hima0407/Project-Eidolon/README.md

# Project Eidolon

**A two-seat light trainer designed to beat the Hansa-NG, with every number traceable to code.**

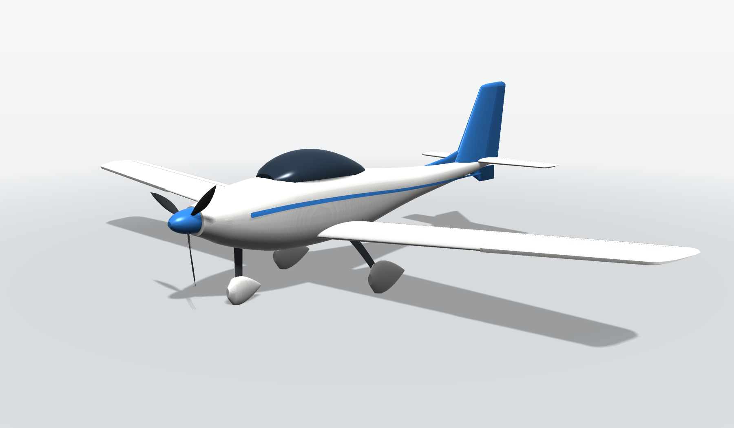
[picture p1: results/16_geometry/render_hero.png]
Eidolon v1, generated from the design closure


Eidolon is a first-semester conceptual design of a 750 kg, two-seat, single-engine trainer. It sits in the same class as India's CSIR-NAL **Hansa-NG**. Every number in this repository comes out of one Python pipeline: airfoils, wing, structure and mass, drag, propeller, engine choice, tail, CG, performance, loads, landing gear and the 3-D model. Every chosen value is the result of a study you can re-run with one command.

> **Status:** preliminary design (conceptual phase). Results are outputs of calibrated engineering models, not flight-test or wind-tunnel data. [Methods & validation](docs/METHODS_AND_VALIDATION.md) lists what each model can and cannot claim.

---

## The idea in one line: calibrate on real aircraft, then beat them

Every conceptual-design model has bias. So we first run our models on real aircraft with published data, and only then on Eidolon.

- **Mass.** A bottom-up count of sized structure, plus one measured unknown: the "class allowance" that a bottom-up count always misses, measured on three certified trainers (Hansa-NG, Aquila A210, DV20 Katana) as **148.8 ± 11.6 kg**. Leave-one-out predicts each of them within −3.7 % to +2.1 %.
- **Performance.** Two factors fitted on the Hansa-NG's cruise speed and climb rate. The models then predict five other published Hansa-NG numbers within **±15 %**.

Eidolon then goes through the **identical** models, so whatever bias is left mostly cancels and the comparison is like-for-like.

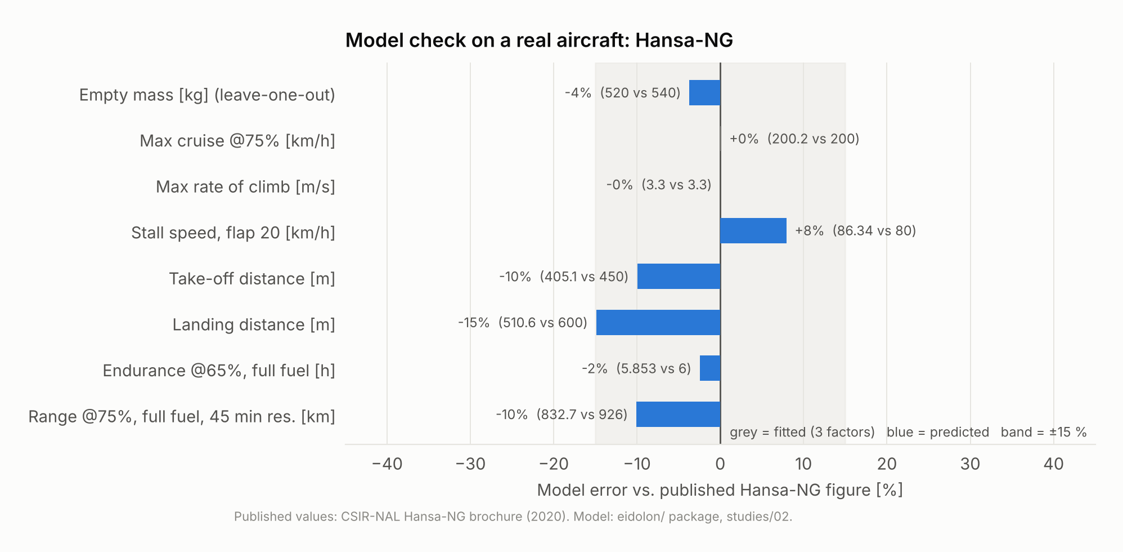
[picture p2: results/02_calibration/hansa_validation.png]
Model check on Hansa-NG


## Eidolon against the Hansa-NG

The design was closed first with glass-fibre sandwich skins (studies 01-16). Study 20 then re-closed the same geometry with **carbon sandwich skins**; that is the final aircraft.

| Same models, same calibration | Hansa-NG | First closure (glass) | **Eidolon, final (carbon)** | Change vs Hansa-NG |
|---|---:|---:|---:|---:|
| Fuel per 100 km at 200 km/h | 9.35 L | 7.84 L | **7.85 L** | **−16 %** |
| Range at 200 km/h, 2 × 77 kg + 10 kg, 45-min reserve | 713 km | 803 km | **1,098 km** | **+54 %** |
| Range, 2 × 90 kg + 10 kg | — | 334 km | **884 km** | |
| Cruise speed at 75 % power, 1500 m | 200 km/h | 216 km/h | **215 km/h** | +8 % |
| Max rate of climb, sea level | 3.30 m/s | 3.70 m/s | **3.70 m/s** | +12 % |
| Take-off distance to 15 m | 405 m | 357 m | **357 m** | −12 % |
| Stall speed, landing flap | 86 km/h* | 81 km/h | **81 km/h** | −6 % |
| L/D max | 12.8 | 15.0 | **15.0** | +17 % |
| Parasite drag coefficient CD0 | 0.0332 | 0.0263 | **0.0263** | −21 % |
| Empty mass | 526 kg | 530 kg | **500 kg** | −5 % |
| Unit cost, model (study 18) | ₹3.00 cr | ₹3.09 cr | **₹3.19 cr** | +6 % |
| Spin screen (Bowman TDPF, ≥ 200 × 10⁻⁶) | — | 481 × 10⁻⁶ | **496 × 10⁻⁶** | passes |

\*Model value. The model over-predicts Hansa-NG's published 80 km/h by 8 %, so Eidolon's 81 km/h is conservative. It is below the CS-VLA limit of 83 km/h.

Carbon does not change fuel burn: the wing is sized by stall at 750 kg either way. It turns 30 kg of structure into payload and fuel, so the 100 L tank is full with two crew, and it costs about ₹10 lakh more per aircraft. Per kilogram of useful load that is **₹1.27 lakh**, against ₹1.43 lakh for Hansa-NG ([study 20](studies/20_materials_carbon.py)).

**Is the advantage real?** We ran the comparison 800 times in Monte Carlo, with every uncertain assumption drawn wide, once with priors biased against Eidolon and once neutral: first on the glass first closure ([study 14](studies/14_sensitivity.py)), then on the final carbon aircraft ([study 22](studies/22_monte_carlo_carbon.py)).

- **Fuel burn:** Eidolon burns less in **100 %** of samples in every run, glass and carbon (−4 % to −14 % P5-P95, pessimistic).
- **Range with two crew, glass first closure:** better in **66 %** (neutral) and **30 %** (pessimistic). At a fixed 750 kg, every kilogram of empty mass is a kilogram of fuel, about **18 km** of range, and the glass aircraft's lead vanished if its empty mass grew 5 kg beyond the estimate.
- **Range, final carbon airframe:** re-run in [study 22](studies/22_monte_carlo_carbon.py) with the same priors, plus the assumption that only 50-100 % of the carbon saving turns up in production. Eidolon flies further in **98 %** of samples (pessimistic) and **100 %** (neutral); median **+24 %** and **+45 %**. The lead now survives **35 kg** of mass growth, against 5 kg in glass.

So the fuel-burn advantage is firm, and the carbon airframe turns the range advantage from conditional into firm. A weight-tracking budget is still the first job of the next phase.

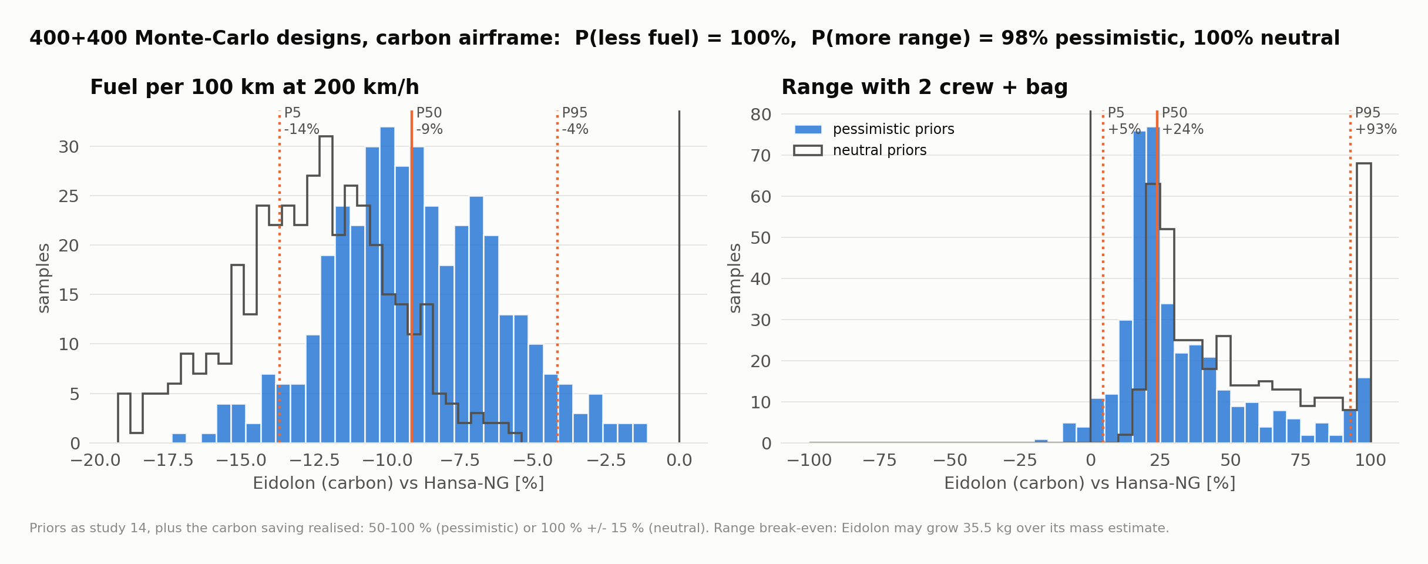
[picture p3: results/22_monte_carlo_carbon/monte_carlo.png]
Monte Carlo, final carbon aircraft


---

## Design decisions, each with its evidence

| # | Decision | Why (short) | Evidence |
|---|---|---|---|
| [D1](docs/DESIGN_DECISIONS.md#d1-mission-mtow-and-certification-basis) | 750 kg MTOW, 2 seats, CS-VLA envelope, +4.4 g utility loads | Same class as Hansa-NG, fair comparison; spin-training loads | studies 02, 12 |
| [D2](docs/DESIGN_DECISIONS.md#d2-mass-is-estimated-bottom-up-and-the-unknown-is-measured) | **Bottom-up mass** + measured class allowance, as a random variable | Sees Eidolon's differences from Hansa; P5-P95 500-560 kg | study 01 |
| [D3](docs/DESIGN_DECISIONS.md#d3-wing-section-naca-63-415-blending-to-63-412) | NACA 63-415 root → 63-412 tip | Laminar to ~35-50 % chord at cruise CL; 25 % deeper spar | study 03 |
| [D4](docs/DESIGN_DECISIONS.md#d4-wing-planform-1325-m-115-m-taper-06-2-washout) | **13.25 m², 11.5 m span (AR 10)**, taper 0.6, −2° washout | Fuel-burn optimum of a carpet of fully closed aircraft, range ≥ 800 km | studies 04, 05 |
| [D5](docs/DESIGN_DECISIONS.md#d5-spin-resistant-drooped-outboard-leading-edge) | **Drooped outboard leading edge** | Ailerons stay 100 % unstalled 3° past first stall (37.5 % without) | study 04 |
| [D6](docs/DESIGN_DECISIONS.md#d6-tail-conventional-low-tail-ventral-strake-40-elevator) | **Conventional low tail + ventral strake, 40 % elevator** | 6 configurations re-closed; T-tail can't rotate before lift-off; strake triples spin damping | studies 09, 10 |
| [D7](docs/DESIGN_DECISIONS.md#d7-drag-reduction) | Faired gear, laminar wing, compact fuselage | −16 % parasite drag area; the gear fairings are the biggest item | study 06 |
| [D8](docs/DESIGN_DECISIONS.md#d8-engine-rotax-912-isc) | **Rotax 912 iSc** (vs 912 ULS, 914, 915 iS, UL520iS) | Each engine re-closed in its own airframe. The DarkAero 1's UL520iS leaves 10 kg of fuel with two crew | study 08 |
| [D9](docs/DESIGN_DECISIONS.md#d9-propeller-175-m-3-blade-constant-speed) | 1.75 m, 3-blade, constant speed | BEMT checked against the momentum limit; 81 % installed in cruise | study 07 |
| [D10](docs/DESIGN_DECISIONS.md#d10-glass-fibre-leaf-spring-gear-with-piezo-health-monitoring) | S-glass leaf-spring gear with piezo health monitoring | Lightest spring material (σ²/Eρ); piezo logs every landing, but can absorb only 0.04 % of it | study 13 |
| [D11](docs/DESIGN_DECISIONS.md#d11-structure-checked-at-66-g-tip-deflection-flagged) | Structure checked at 6.6 g; stiffness flagged | Spar at its allowable, tail cone margin +0.45; wing is skin-driven (57 % skin, 9 % spar caps) | study 17 |
| [D12](docs/DESIGN_DECISIONS.md#d12-fuselage-length-710-m) | Fuselage body 7.10 m | Shortest body at the fuel-burn minimum of 8 re-closed lengths | study 19 |
| [D13](docs/DESIGN_DECISIONS.md#d13-carbon-sandwich-airframe-for-the-final-aircraft) | **Carbon sandwich airframe** (vacuum infusion) | −30 kg empty; range 803 → 1,098 km; +3 % unit cost; cheapest per kg of useful load | studies 18, 20 |
| [D14](docs/DESIGN_DECISIONS.md#d14-engine-re-checked-on-the-carbon-airframe-912-isc-stays) | Engine re-checked on carbon: **912 iSc stays** | Six-cylinder still fits only 40 kg of fuel (349 km); weight, not tank, is the limit. Hot days: 30 kW boost option | studies 15, 23 |

Appendix concept: [hybrid take-off boost for 45 °C airfields](docs/hybrid_boost_concept.md) (study 15).

## What makes it different

- **Spin-resistant by design.** Washout, a drooped outboard leading edge and a ventral strake, each screened with a published criterion, for a trainer that students will stall and spin.
- **A wing the old statistics would never have chosen.** Sizing the carbon spar instead of using a fitted equation made span cheap, and the optimum moved from 10.25 m to 11.5 m.
- **A landing gear that reports on itself.** Piezo films log the sink rate of every landing and flag hard ones; PZT wafers can find damage in the composite leaf between inspections.
- **CAD that follows the numbers.** Change the design, re-run, and the Fusion 360 solids, viewer and renders follow ([docs/CAD.md](docs/CAD.md)).

## How the pipeline closes the design

```mermaid
flowchart LR
  R[Requirements<br/>docs/requirements.md] --> G[Geometry<br/>wing, tails, fuselage]
  G --> A[Aerodynamics<br/>lifting line + drag build-up]
  A --> S[Structure<br/>spar sized for 6.6 g]
  S --> W[Mass<br/>bottom-up + class allowance]
  E[Engine data] --> P[Propeller BEMT]
  W --> C[CG envelope]
  A --> T[Tail sizing +<br/>wing position]
  C --> T
  T --> G
  A --> F[Performance<br/>climb, cruise, range, TO/LDG]
  P --> F
  W --> F
  F --> O[Trade studies<br/>wing carpet, engines, tails,<br/>Monte Carlo]
  G --> X[3-D model<br/>Fusion, viewer, renders]
  H[Hansa-NG, Aquila, DV20<br/>published data] -. calibrate & validate .-> W
  H -.-> F
```

The loop `geometry → mass → CG → tail/wing position → geometry` repeats until it converges (`eidolon/design.py`).

## The studies

| # | Study | Main output |
|---|---|---|
| 01 | Mass estimation | bottom-up mass, class allowance, leave-one-out, mass distribution |
| 02 | Calibrate on Hansa-NG | drag and climb factors, validation against 6 published numbers |
| 03 | Airfoil selection | section geometry and polars |
| 04 | Wing lifting line | span loading, stall progression, washout, drooped LE |
| 05 | Wing sizing | area × span carpet of closed aircraft |
| 06 | Drag build-up | component drag areas, waterfall vs Hansa-NG |
| 07 | Propeller | BEMT, 2 vs 3 blades |
| 08 | Engine trade | 5 engines, each in its own closed airframe |
| 09 | Tail configuration | 6 tails, spin and deep-stall screens, tail height, elevator chord |
| 10 | Stability and CG | neutral point, CG envelope, tail sizing criteria |
| 11 | Performance | head-to-head, power curves, payload-range |
| 12 | V-n diagram | CS-23 manoeuvre and gust envelope |
| 13 | Landing gear | leaf-spring material trade, piezo assessment |
| 14 | Sensitivity | Monte Carlo (pessimistic and neutral), tornado |
| 15 | Hybrid boost | hot-day take-off and climb with electric boost |
| 16 | 3-D geometry | Fusion script data, STL, viewer bundle, renders, three-view |
| 17 | Structural analysis | wing shear, bending, spar caps, deflection, tail cone, margins (glass and carbon) |
| 18 | Cost model | Eastlake/Gudmundsson unit cost calibrated on Hansa-NG's price; glass, infusion, prepreg |
| 19 | Fuselage length | 8 re-closed body lengths, 6.5-7.9 m |
| 20 | Airframe material | glass vs carbon re-closure, what 30 kg buys, cost efficiency |
| 21 | Presentation renders | part stills, exploded-view layers, assembly animation (`--animate`) |
| 22 | Monte Carlo, carbon | study 14 re-run on the final carbon aircraft; study 09's tail screen re-checked on carbon |
| 23 | Engine trade, carbon | study 08 re-run with carbon skins; six-cylinder needs; hot-day options incl. the 30 kW boost |

### The order we designed it in

The studies are numbered by topic; this is the order the design actually went, and the order of the review presentation:

1. **Airfoils in XFLR5** (03): candidate sections, Reynolds numbers of each flight phase, XFoil batch, NACA 63-415 → 63-412.
2. **Finite wing** (04, 05, 12, 17): lifting line checked against XFLR5 VLM2, area × span carpet, washout, drooped leading edge, V-n loads, spar sizing.
3. **Propeller and engine** (07, 08): BEMT, 2 vs 3 blades, five engines in their own closed airframes.
4. **Tail and stability** (09, 10): neutral point, six tails, spin screen, elevator chord.
5. **Landing gear** (13): leaf spring sized by landing energy; piezo for sensing and health monitoring.
6. **Whole-aircraft drag and mass** (06, 01, 02): component build-up; bottom-up mass with a measured class allowance.
7. **Fuselage** (19, 17): layout around the CG, drag physics, length trade, tail-cone bending.
8. **Materials and cost** (20, 18, 23): carbon sandwich airframe adopted; cost calibrated on Hansa-NG; engine choice re-checked on carbon.
9. **The aircraft** (11, 14, 16, 21, 22): performance, Monte Carlo (glass, then carbon), CAD with internal components ([docs/CAD.md](docs/CAD.md)) and renders.

## Run it

```bash
pip install -r requirements.txt      # numpy >= 2, matplotlib, pytest
python3 -m pytest -q                 # 16 verification tests
python3 run_all.py                   # all 23 studies, about 8 minutes; figures land in results/
python3 run_all.py 05 09             # just the wing carpet and the tail trade
```

The 3-D model is regenerated by study 16 ([docs/CAD.md](docs/CAD.md)):
- `cad/fusion/Eidolon/` — a Fusion 360 script that lofts every body as a parametric solid
- `cad/generated/*.stl` — one mesh per body
- `docs/viewer/` — an interactive web viewer. Enable GitHub Pages on `/docs` to publish it.

## Repository map

```text
eidolon/            the design toolkit: a Python package, one module per discipline (models only, nothing runs on import)
studies/            the 23 numbered analyses that use it; each writes into results/<study>/
run_all.py          runs every study in order
results/            every figure and table, regenerated by run_all.py
tests/              verification tests (ISA, lifting-line textbook cases, momentum bound, spar sizing, closure)
xflr5/              our XFLR5 work: airfoils/ (coordinates), projects/ (.xfl files), results/ (exported polars)
cad/                eidolon_v1.step and the Fusion file; fusion/ = generator script, generated/ = STL per body, early/ = first models
docs/               requirements, design decisions, methods & validation, CAD notes, concepts
docs/viewer/        interactive 3-D viewer (three.js)
archive/            first-iteration scripts and their results, and early concept notes, kept for history
```

## Gallery

| | |
|---|---|
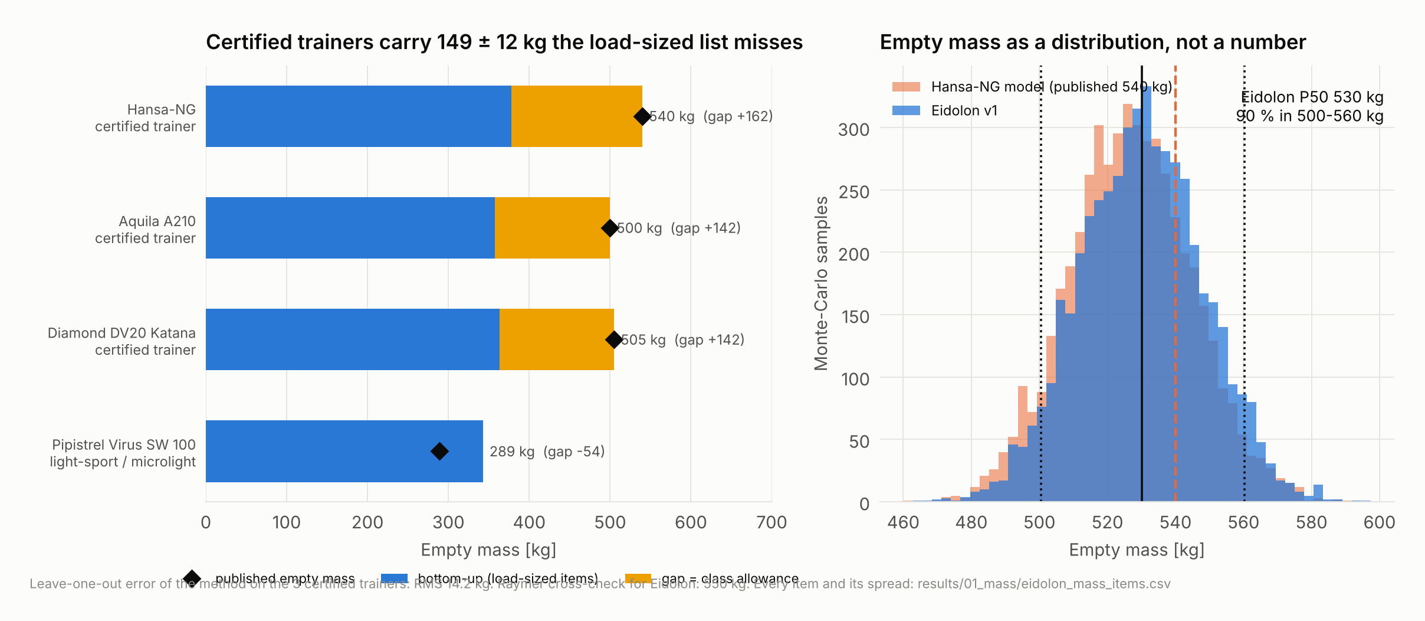
[picture p4: results/01_mass/mass_estimation.png]
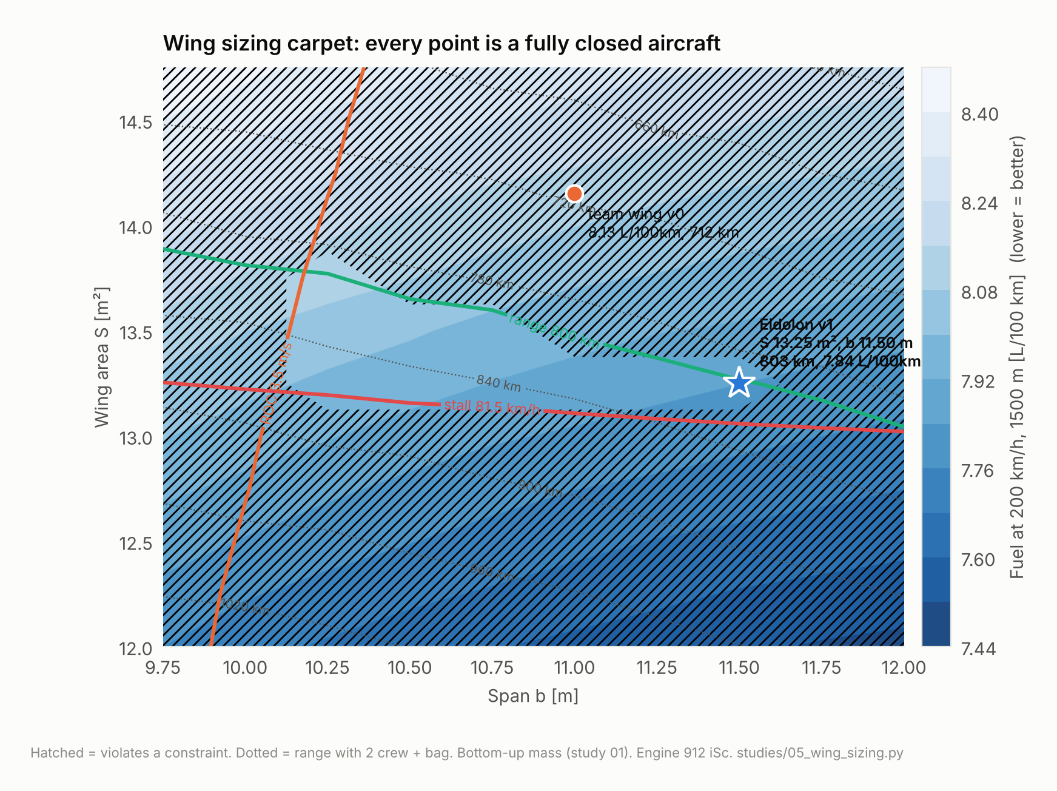
[picture p5: results/05_wing_sizing/wing_carpet.png]
|  |  |
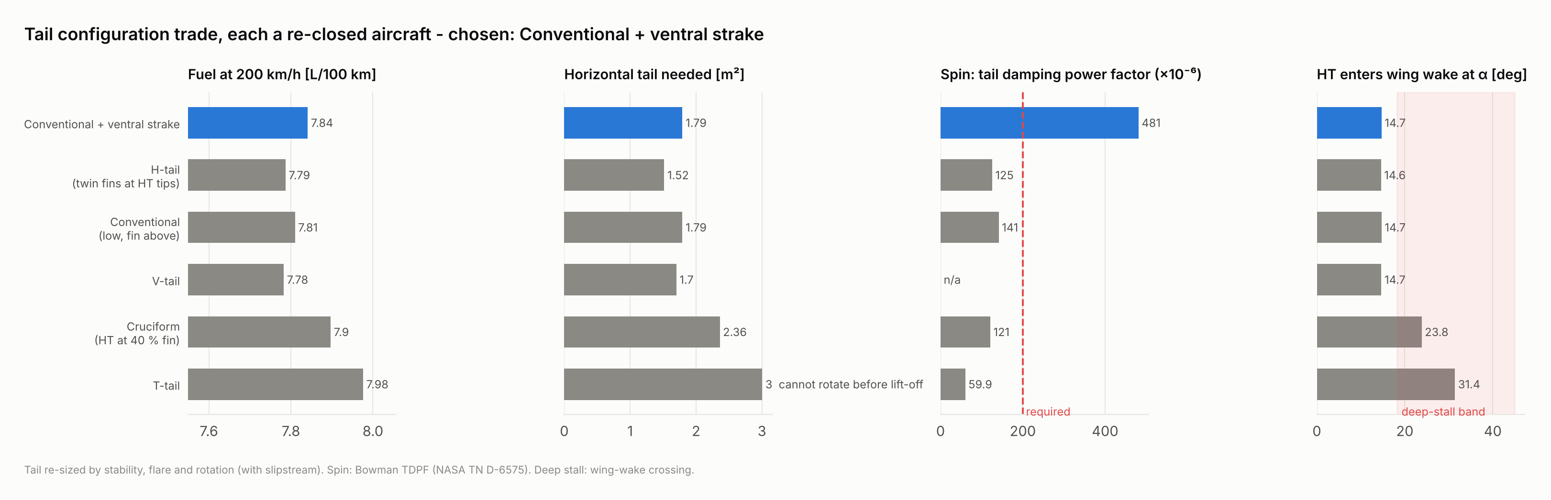
[picture p6: results/09_tail/tail_configurations.png]
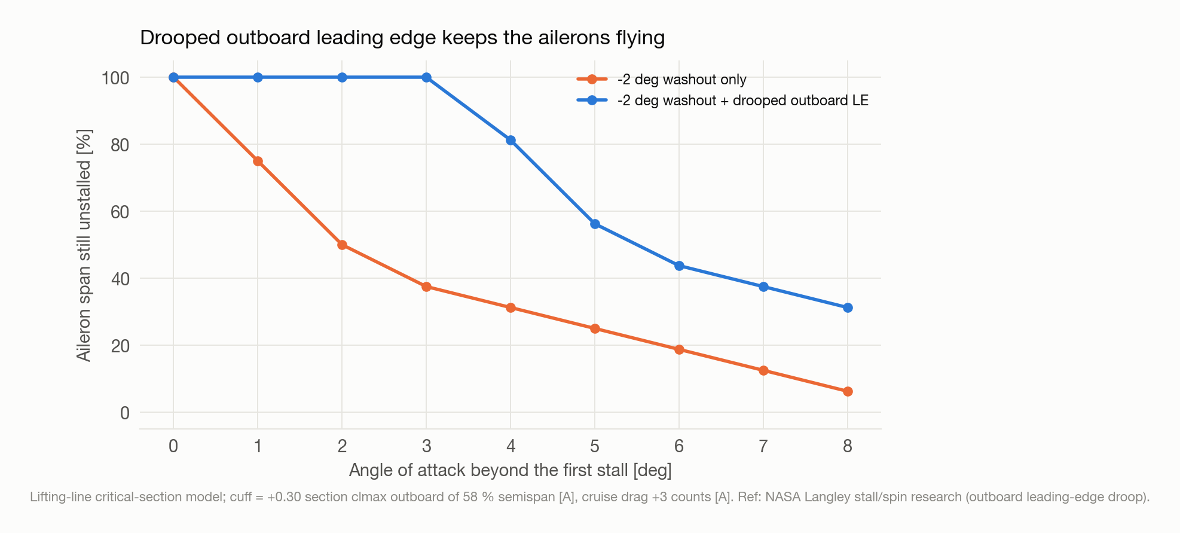
[picture p7: results/04_wing/leading_edge_cuff.png]
|  |  |
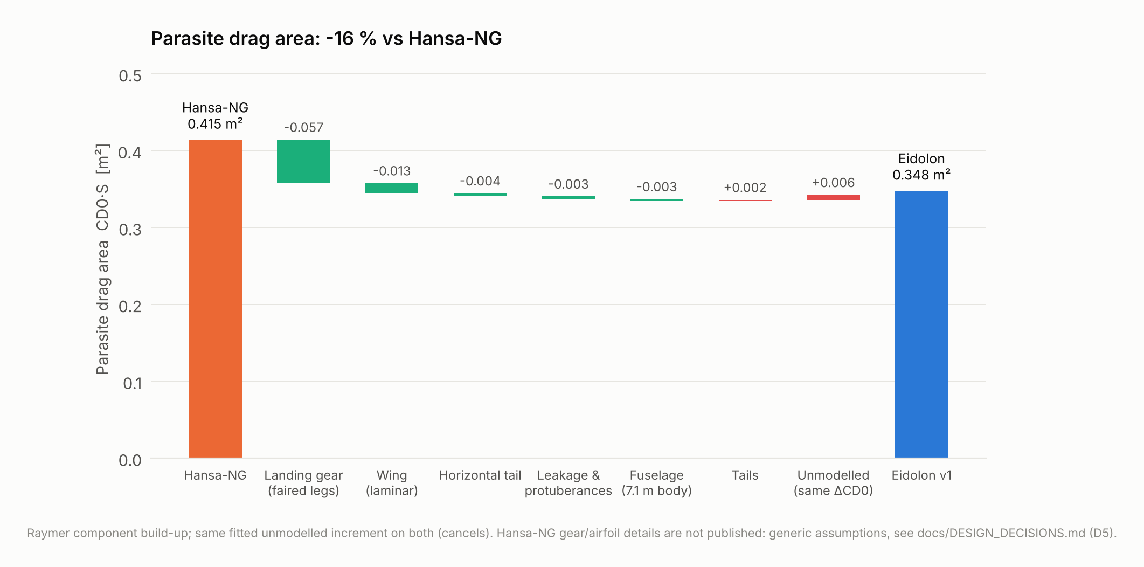
[picture p8: results/06_drag/drag_waterfall.png]
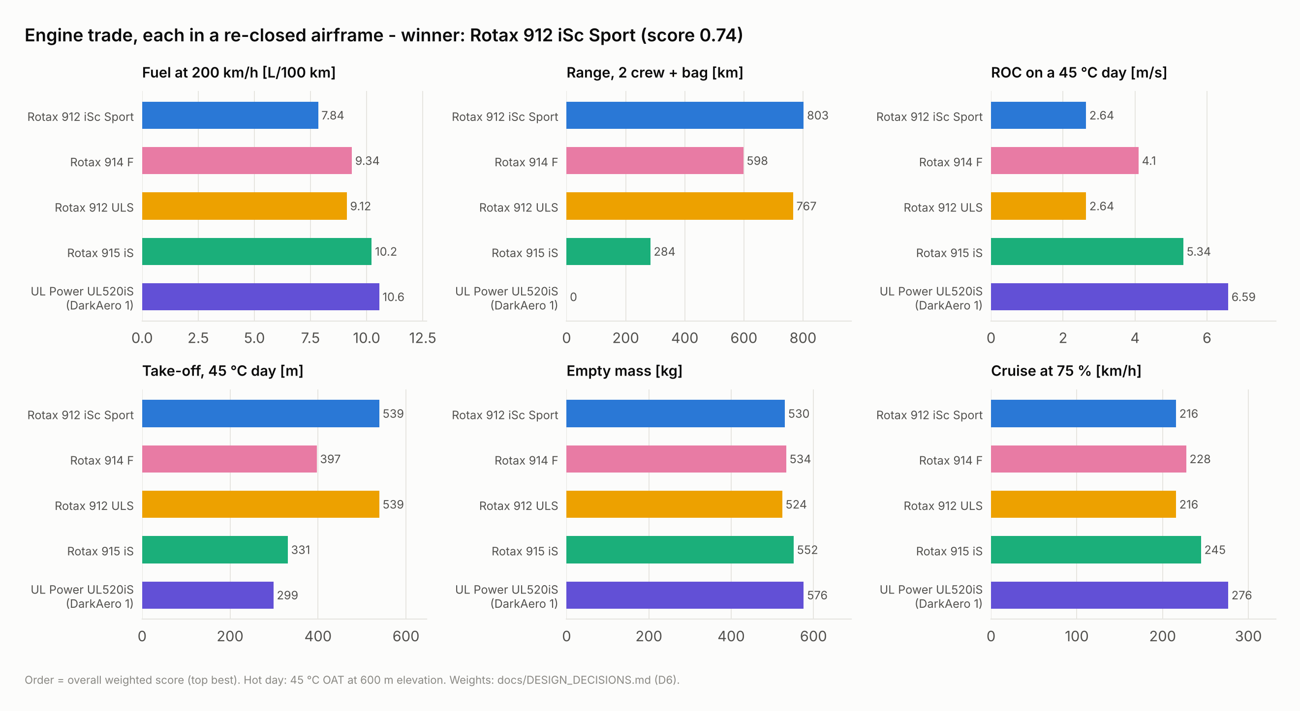
[picture p9: results/08_engine_trade/engine_trade.png]
|  |  |
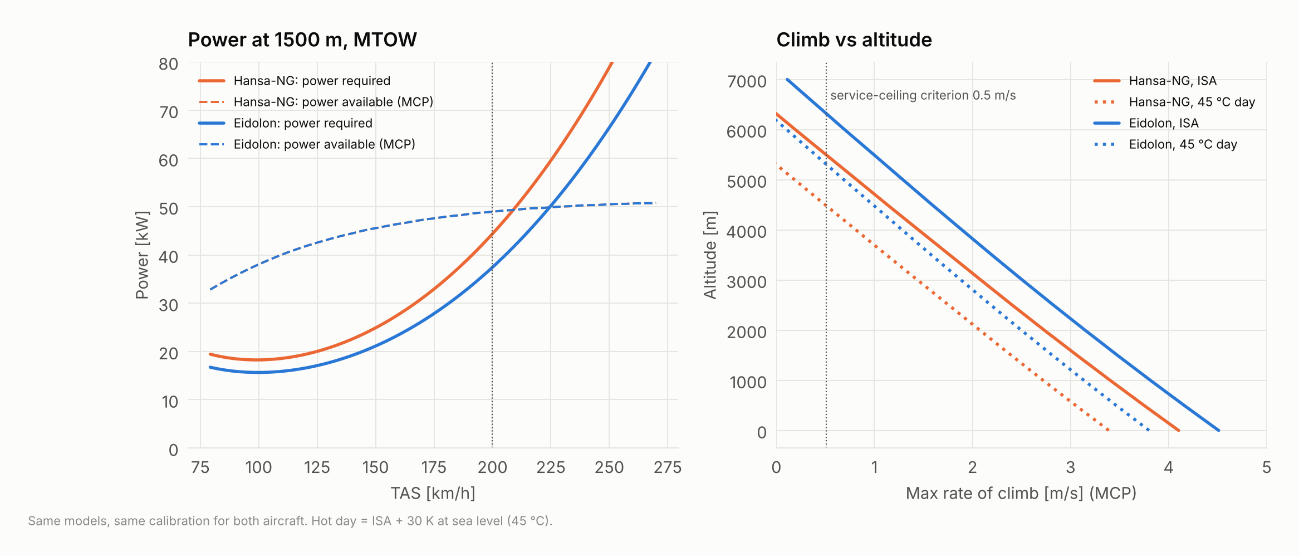
[picture p10: results/11_performance/power_and_climb.png]
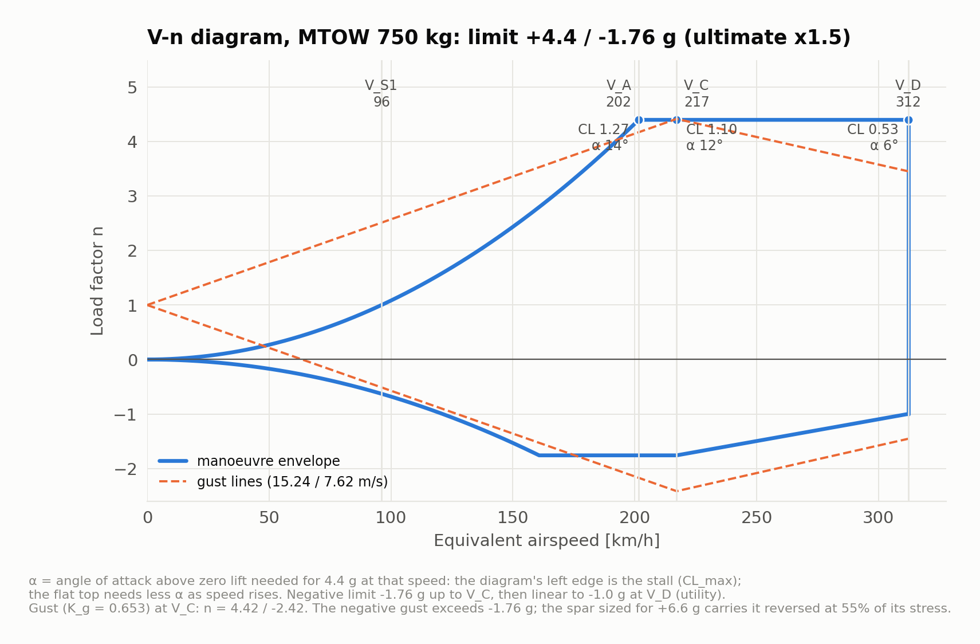
[picture p11: results/12_vn/vn_diagram.png]
|  |  |
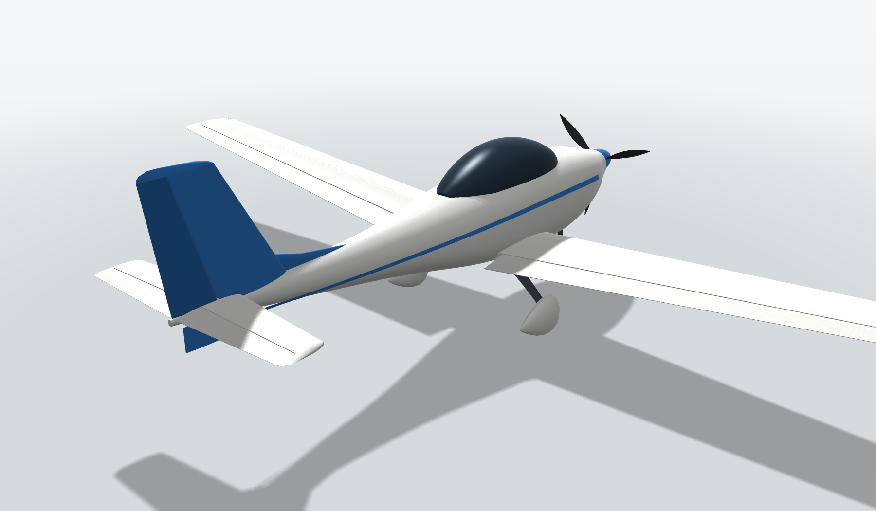
[picture p12: results/16_geometry/render_rear.png]
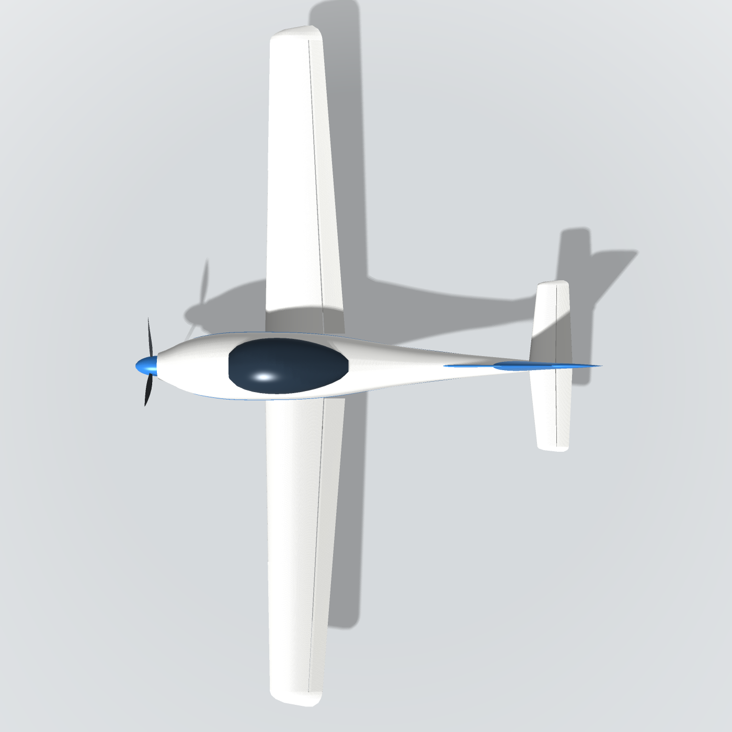
[picture p13: results/16_geometry/render_top.png]
|  |  |
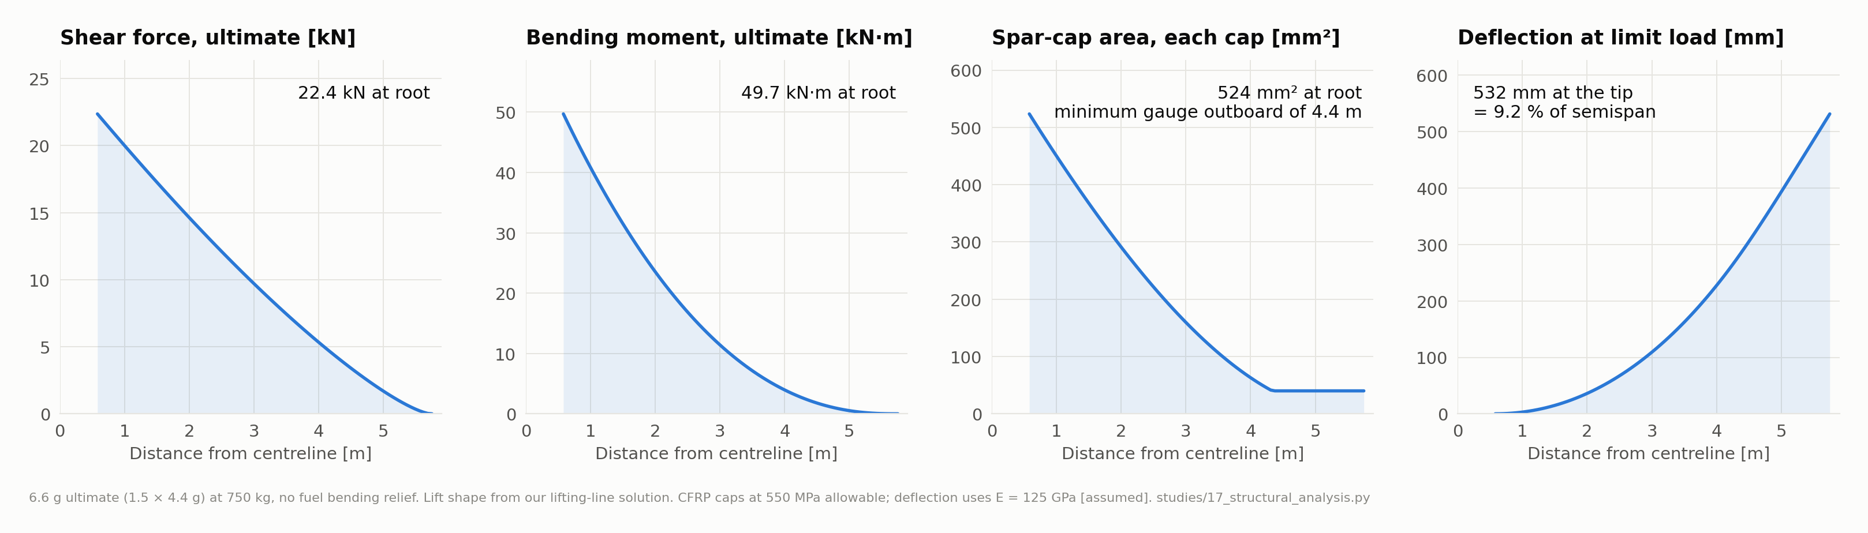
[picture p14: results/17_structures/wing_loads.png]
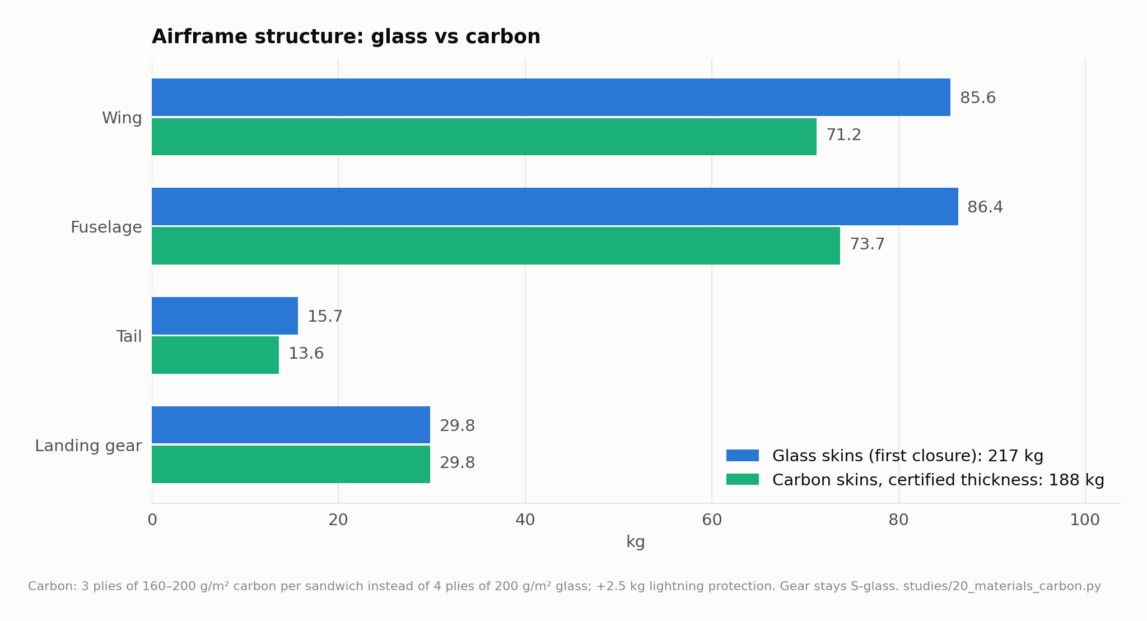
[picture p15: results/20_materials/glass_vs_carbon.png]
|  |  |
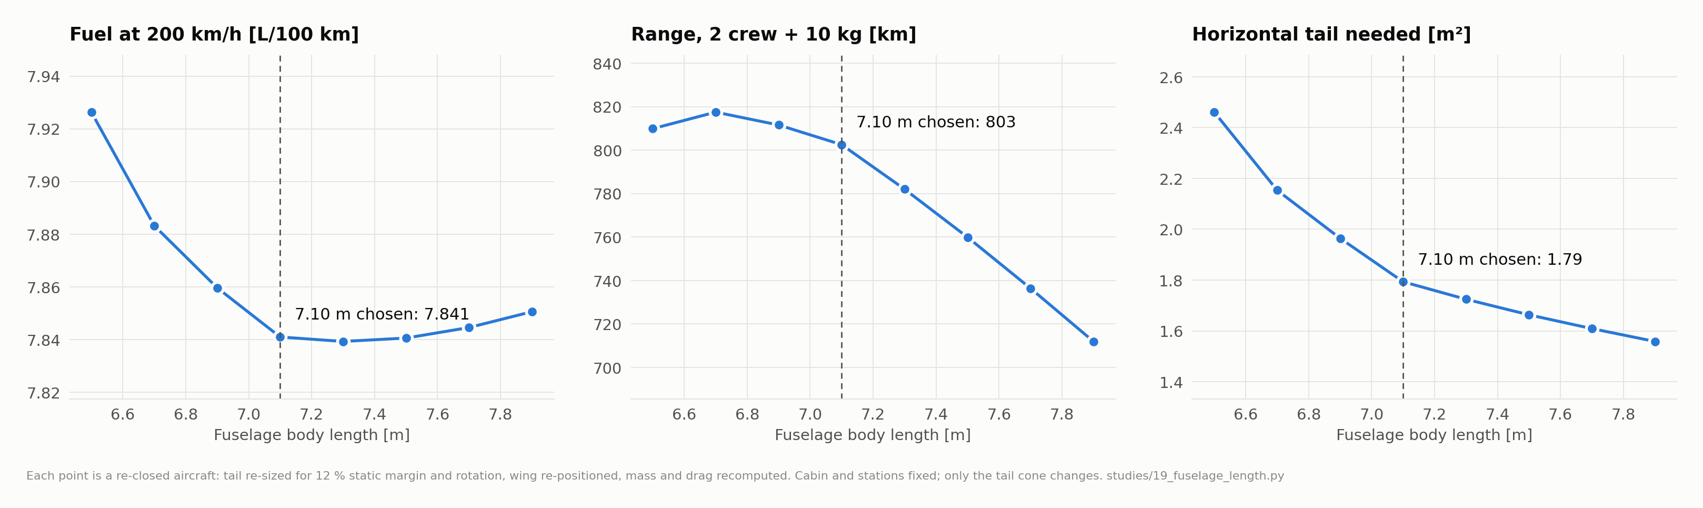
[picture p16: results/19_fuselage/fuselage_trade.png]
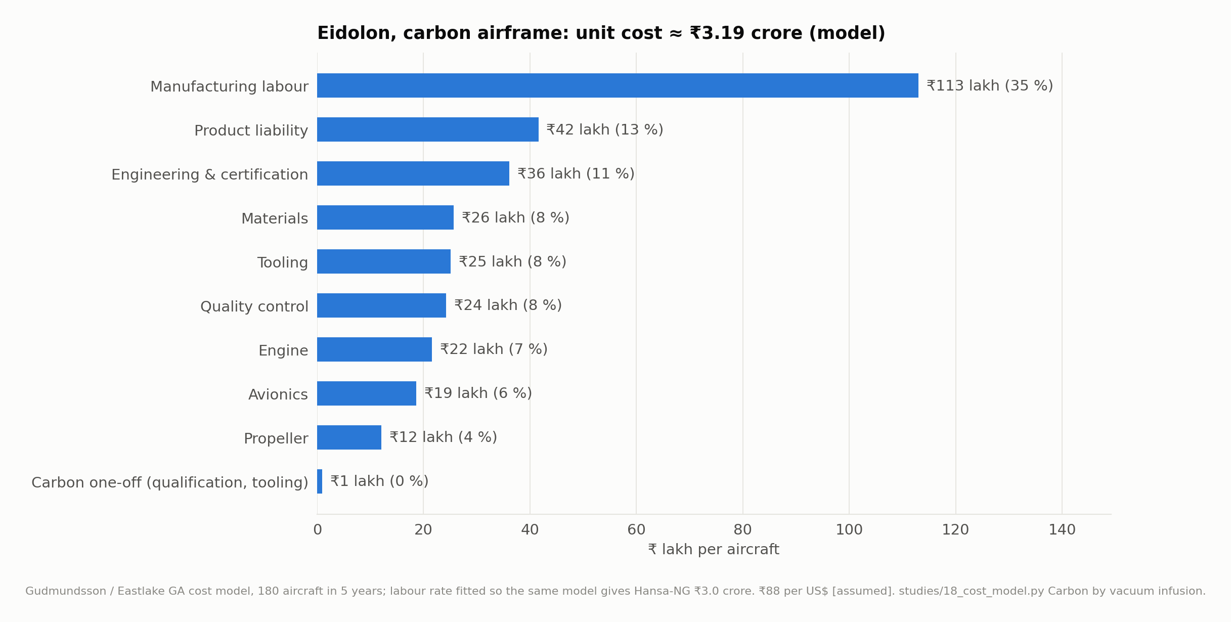
[picture p17: results/18_cost/cost_carbon.png]
|  |  |

Assembly animation, rendered by the pipeline: [results/21_renders/assembly.mp4](results/21_renders/assembly.mp4)

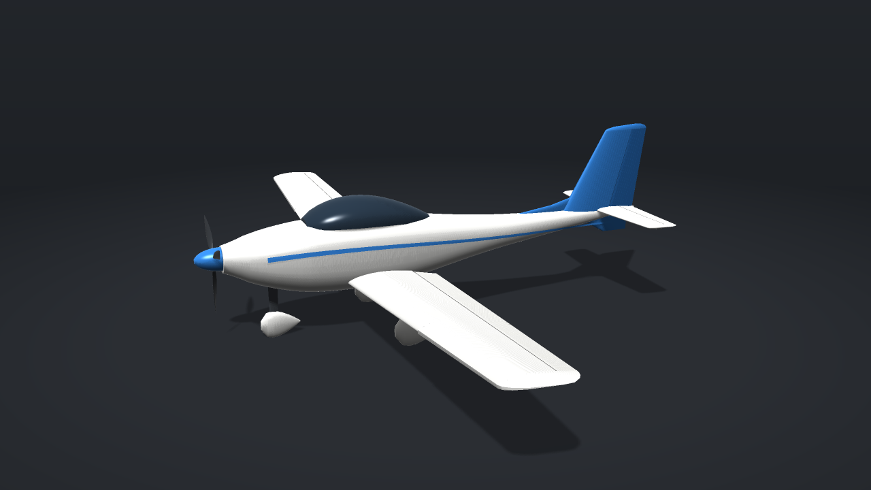
[picture p18: results/21_renders/assembly_still.png]
Assembled


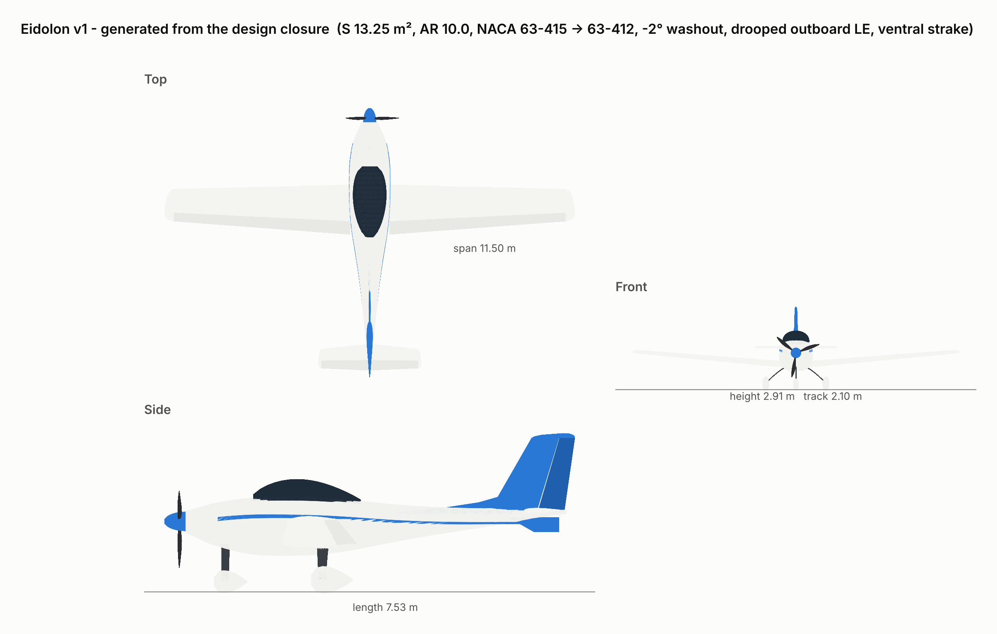
[picture p19: results/16_geometry/three_view.png]
Three-view


## Engineering principles we kept to

- Requirements are not results. Assumptions are tagged `[A]` in the code where they are made.
- Every figure carries its source and method in a footer.
- A model is believed only as far as it has been checked (see `tests/` and studies 01-02).
- Comparisons use identical models and conditions for both aircraft.
- Unknowns are named and given a spread, not hidden in a factor.
- When the analysis disagreed with an earlier choice (wing span, tail size, piezo damping, BEMT efficiency, 25 L tank), the analysis won and the change is recorded.

## References

- CSIR-NAL, *Hansa-NG* brochure (2020), nal.res.in
- D. P. Raymer, *Aircraft Design: A Conceptual Approach*, 6th ed., AIAA, 2018
- E. Torenbeek, *Synthesis of Subsonic Airplane Design*, Delft UP, 1982
- J. D. Anderson, *Fundamentals of Aerodynamics*, 6th ed., McGraw-Hill
- I. H. Abbott & A. E. von Doenhoff, *Theory of Wing Sections*, Dover, 1959
- S. Gudmundsson, *General Aviation Aircraft Design*, 2nd ed., Elsevier, 2022
- B. W. McCormick, *Aerodynamics, Aeronautics and Flight Mechanics*, Wiley
- T. H. G. Megson, *Aircraft Structures for Engineering Students*, Elsevier
- J. S. Bowman Jr., *Summary of spin technology as related to light general-aviation airplanes*, NASA TN D-6575, 1971
- EASA CS-VLA and CS-23 (Amdt. 4 and earlier load-case paragraphs 23.333-23.473)
- Rotax 912 iS/iSc and 915 iS data sheets (flyrotax.com); ULPower UL520iS data (ulpower.com)
- M. Nita & D. Scholz, *Estimating the Oswald factor from basic aircraft geometrical parameters*, DLRK 2012
- N. W. Hagood & A. von Flotow, *Damping of structural vibrations with piezoelectric materials and passive electrical networks*, J. Sound Vib. 146, 1991
