hima0407/Project-Eidolon/cad/early/initialtrail0.png

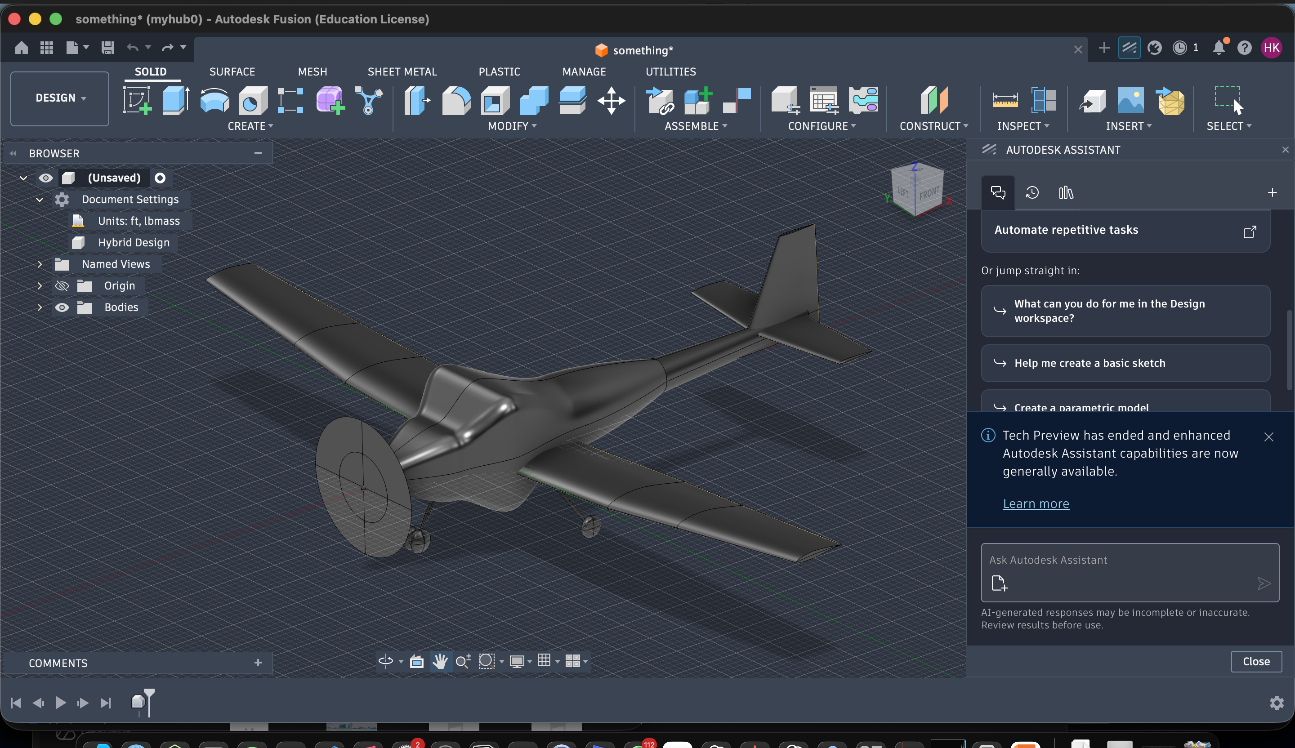
cad/early/initialtrail0.png
