hima0407/Project-Eidolon/cad/eidolon_v1_fusion.png

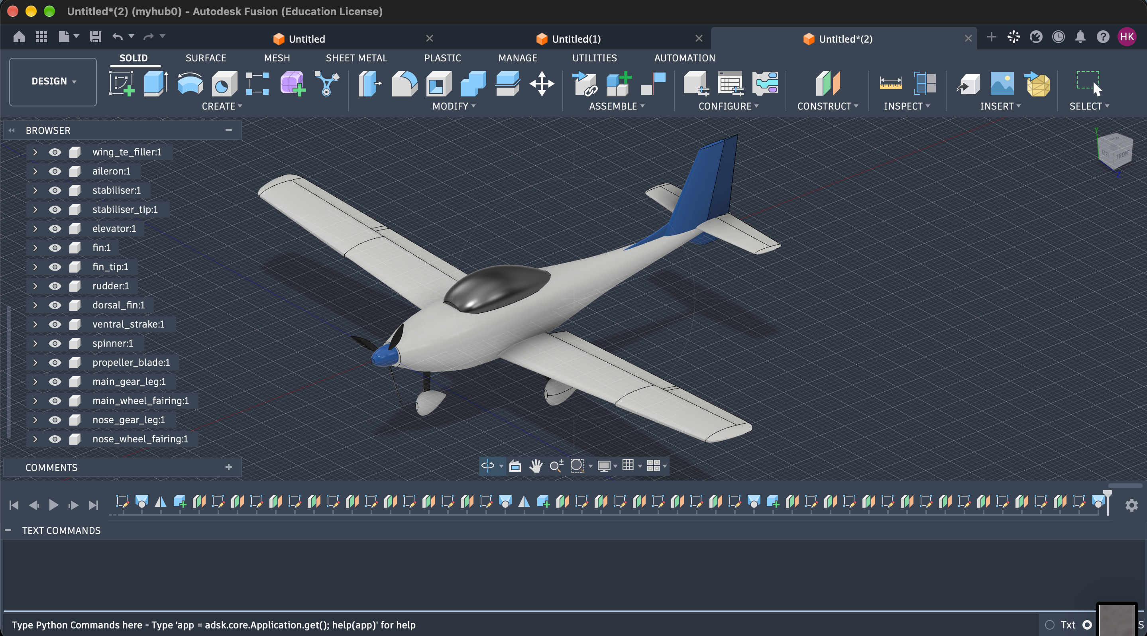
cad/eidolon_v1_fusion.png
