hima0407/Project-Eidolon/docs/eidolon_constraint_graph.png

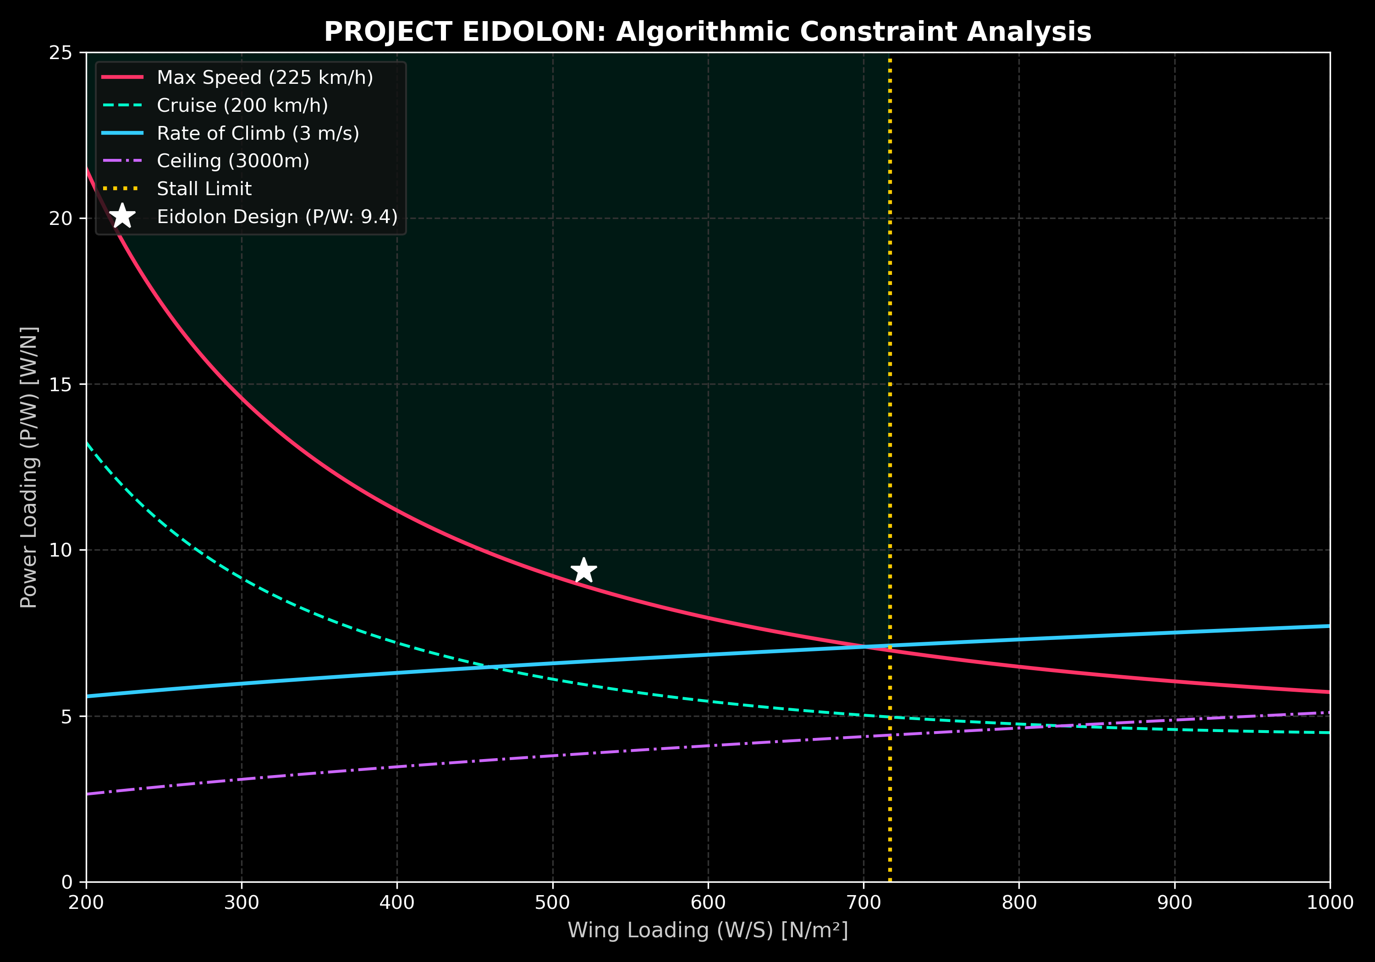
docs/eidolon_constraint_graph.png
