hima0407/Project-Eidolon/results/18_cost/cost_glass.png

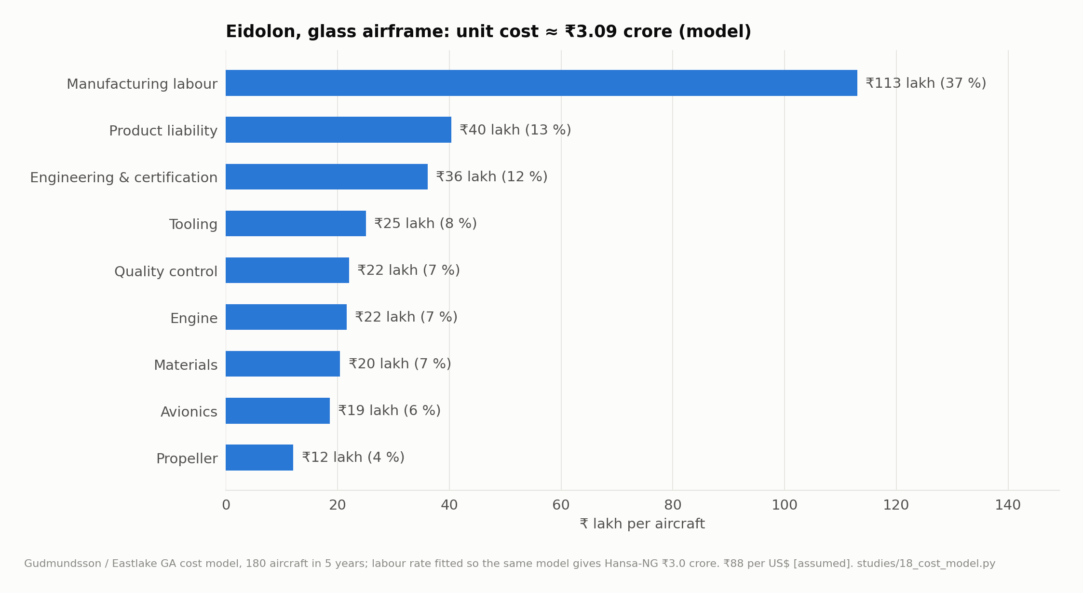
results/18_cost/cost_glass.png
