hima0407/Project-Eidolon/results/20_materials/cost_efficiency.png

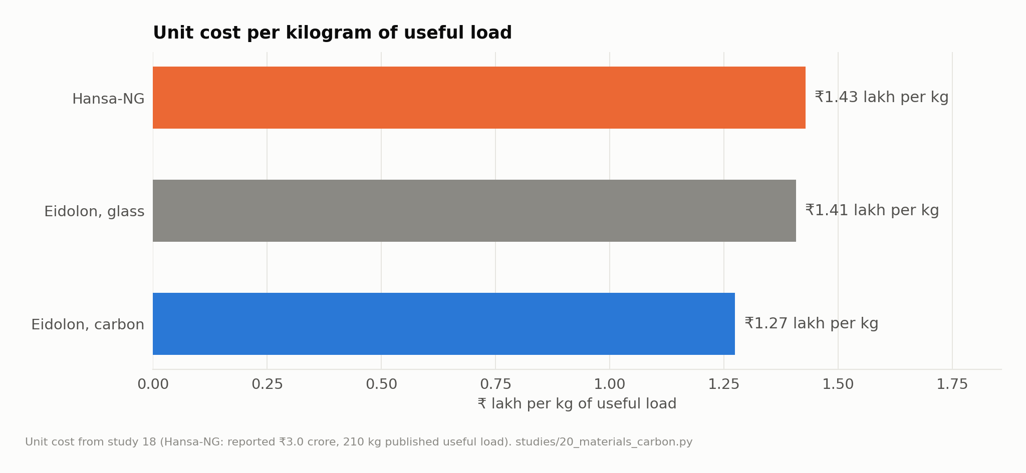
results/20_materials/cost_efficiency.png
