hima0407/Project-Eidolon/cad/generated/eidolon_v1_main_gear_leg.stl

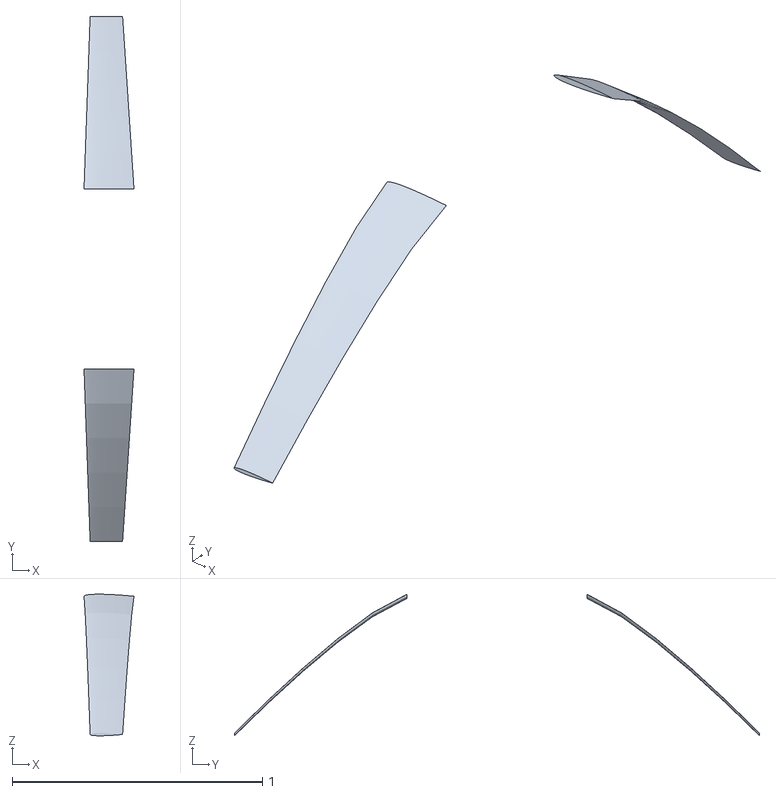
[picture p25: CAD file, 2026-11-10]
cad/generated/eidolon_v1_main_gear_leg.stl
0.2 x 2.10 x 0.567
