hima0407/Project-Eidolon/cad/generated/eidolon_v1_main_wheel_fairing.stl

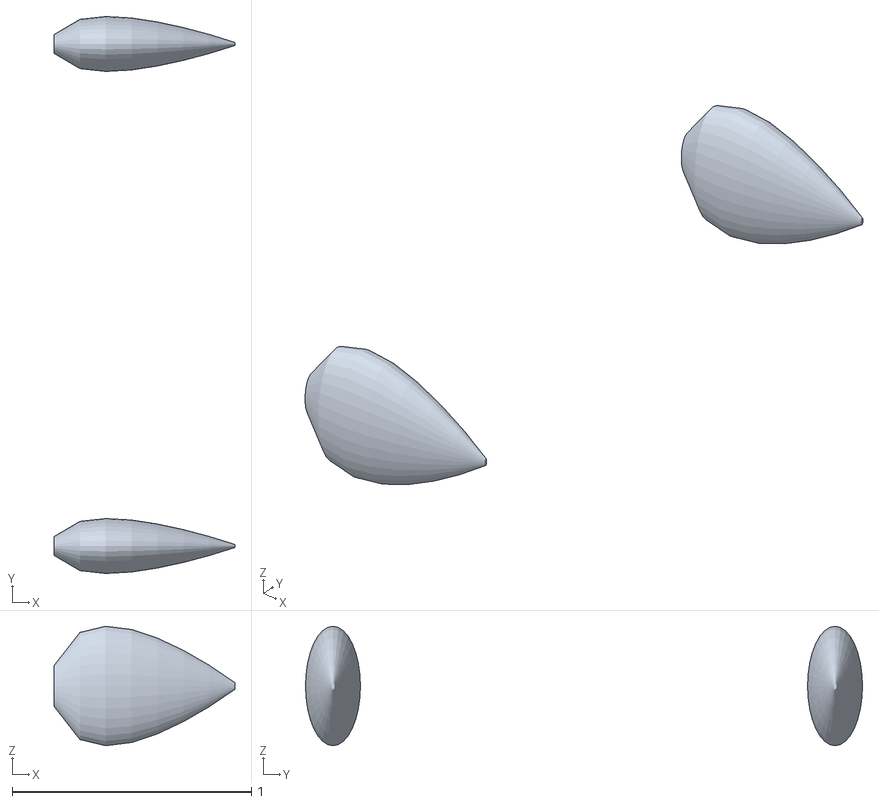
[picture p26: CAD file, 2026-11-10]
cad/generated/eidolon_v1_main_wheel_fairing.stl
0.757 x 2.33 x 0.5
