hima0407/Project-Eidolon/cad/generated/eidolon_v1_complete.stl

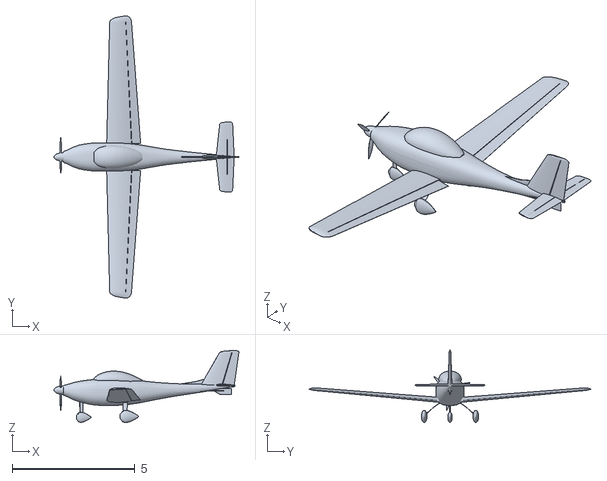
[picture p27: CAD file, 2026-11-10]
cad/generated/eidolon_v1_complete.stl
7.53 x 11.5 x 2.94
