hima0407/Project-Eidolon/cad/generated/internals/eidolon_v1_int_main_spar.stl

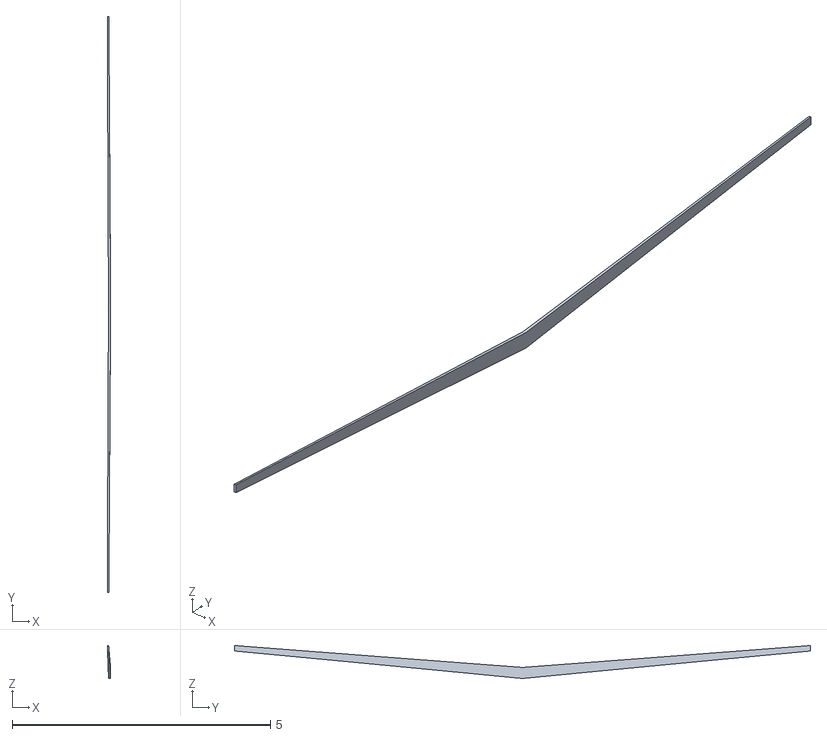
[picture p28: CAD file, 2026-11-12]
cad/generated/internals/eidolon_v1_int_main_spar.stl
0.0651 x 11.2 x 0.639
