hima0407/Project-Eidolon/cad/eidolon_v1.step

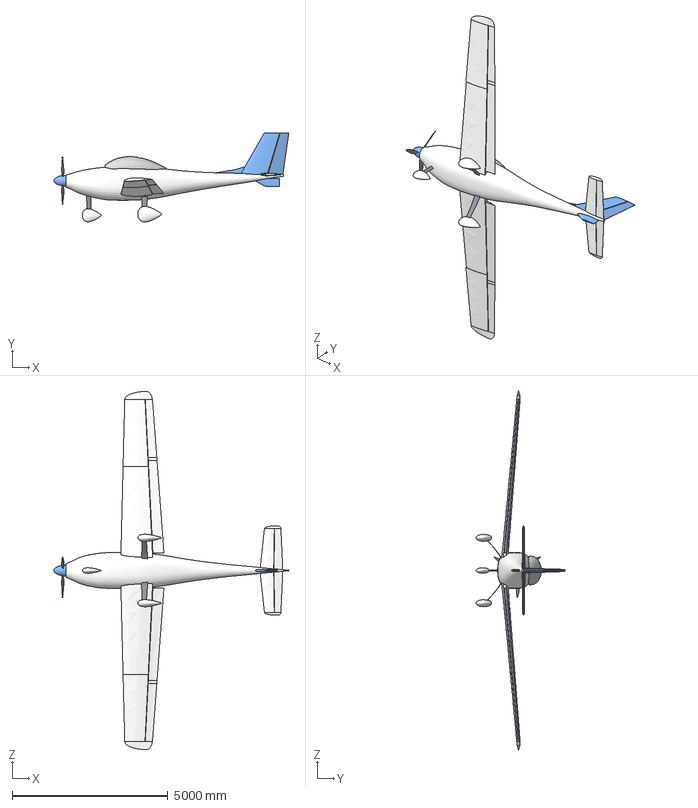
[picture p29: CAD file, 2026-11-10]
cad/eidolon_v1.step
7530.8 x 2855.4 x 11488.5 mm
