hima0407/Project-Eidolon/cad/generated/eidolon_v1_livery_stripe.stl

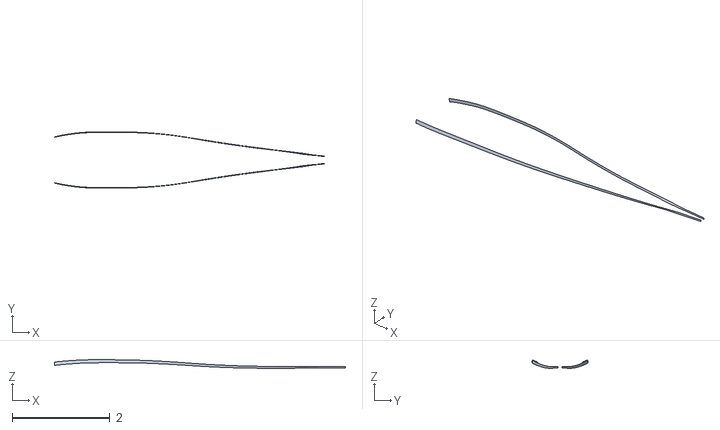
[picture p30: CAD file, 2026-11-10]
cad/generated/eidolon_v1_livery_stripe.stl
5.95 x 1.15 x 0.178
