hima0407/Project-Eidolon/cad/generated/internals/eidolon_v1_int_ribs_06.stl

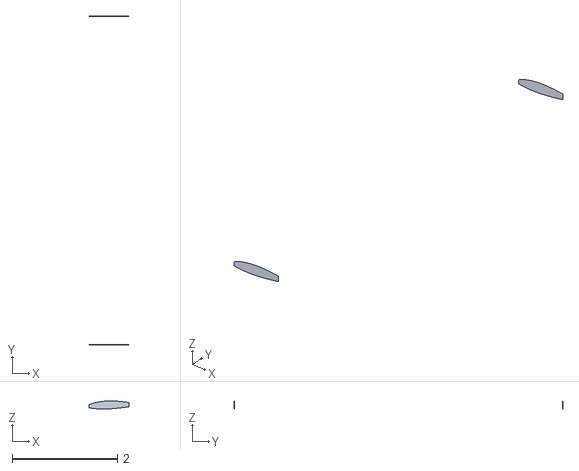
[picture p31: CAD file, 2026-11-12]
cad/generated/internals/eidolon_v1_int_ribs_06.stl
0.756 x 6.26 x 0.154
