hima0407/Project-Eidolon/cad/generated/eidolon_v1_spinner.stl

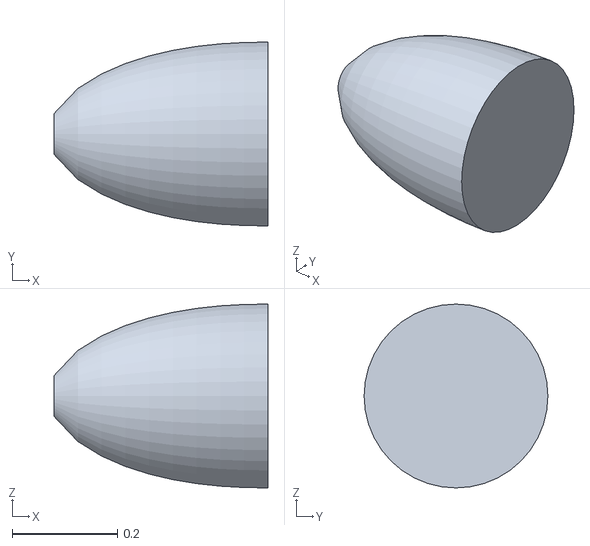
[picture p32: CAD file, 2026-11-10]
cad/generated/eidolon_v1_spinner.stl
0.407 x 0.35 x 0.35
