hima0407/Project-Eidolon/cad/generated/internals/eidolon_v1_int_carry_through.stl

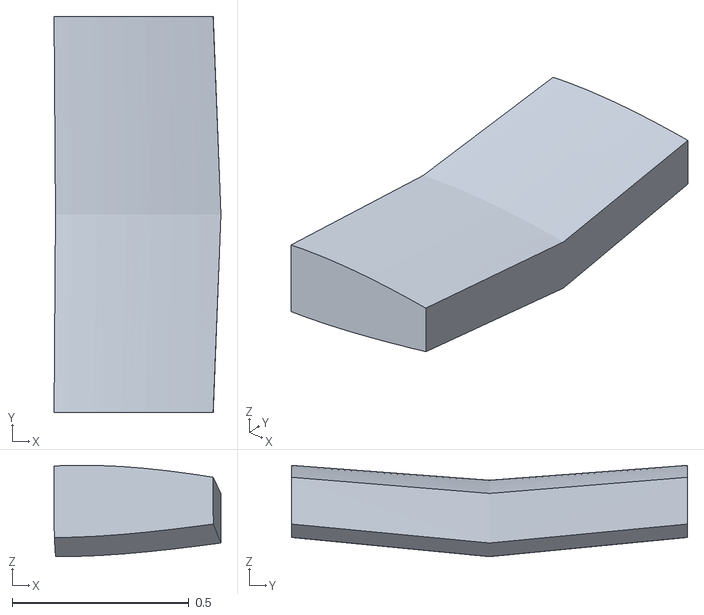
[picture p33: CAD file, 2026-11-12]
cad/generated/internals/eidolon_v1_int_carry_through.stl
0.472 x 1.12 x 0.258
