hima0407/Project-Eidolon/cad/generated/internals/eidolon_v1_int_pushrod.stl

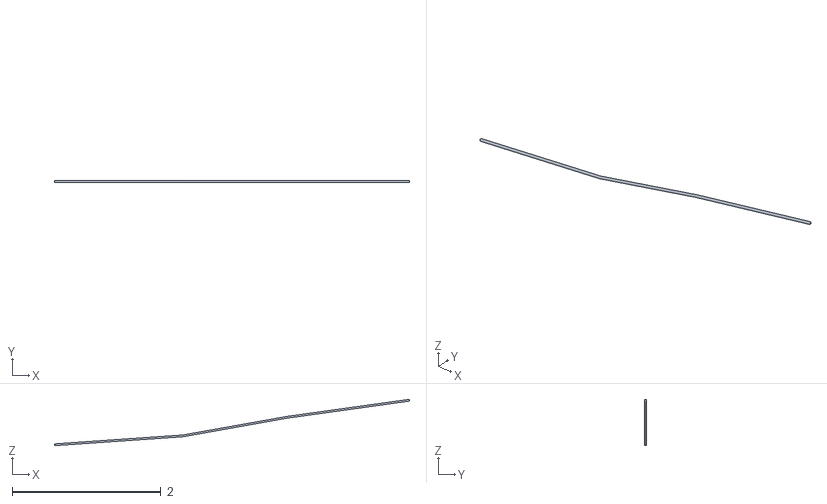
[picture p34: CAD file, 2026-11-12]
cad/generated/internals/eidolon_v1_int_pushrod.stl
4.78 x 0.024 x 0.624
