hima0407/Project-Eidolon/cad/generated/eidolon_v1_rudder.stl

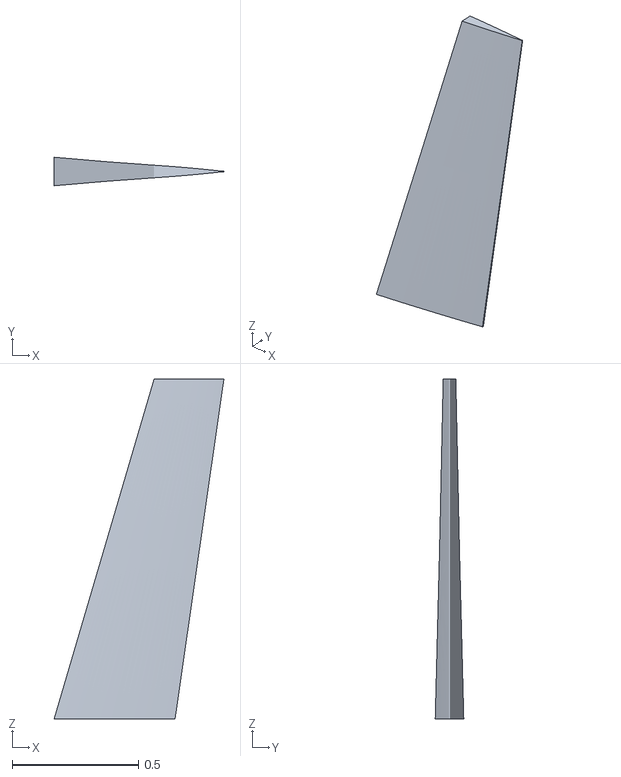
[picture p35: CAD file, 2026-11-10]
cad/generated/eidolon_v1_rudder.stl
0.672 x 0.113 x 1.35
