hima0407/Project-Eidolon/cad/generated/internals/eidolon_v1_int_ribs_10.stl

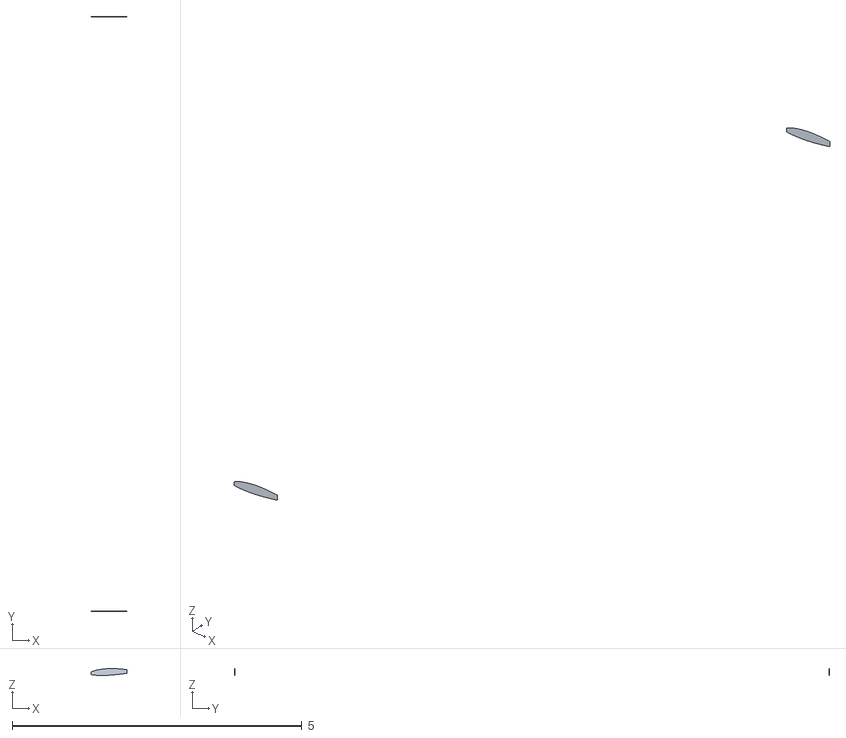
[picture p36: CAD file, 2026-11-12]
cad/generated/internals/eidolon_v1_int_ribs_10.stl
0.622 x 10.3 x 0.119
