hima0407/Project-Eidolon/cad/generated/eidolon_v1_stabiliser.stl

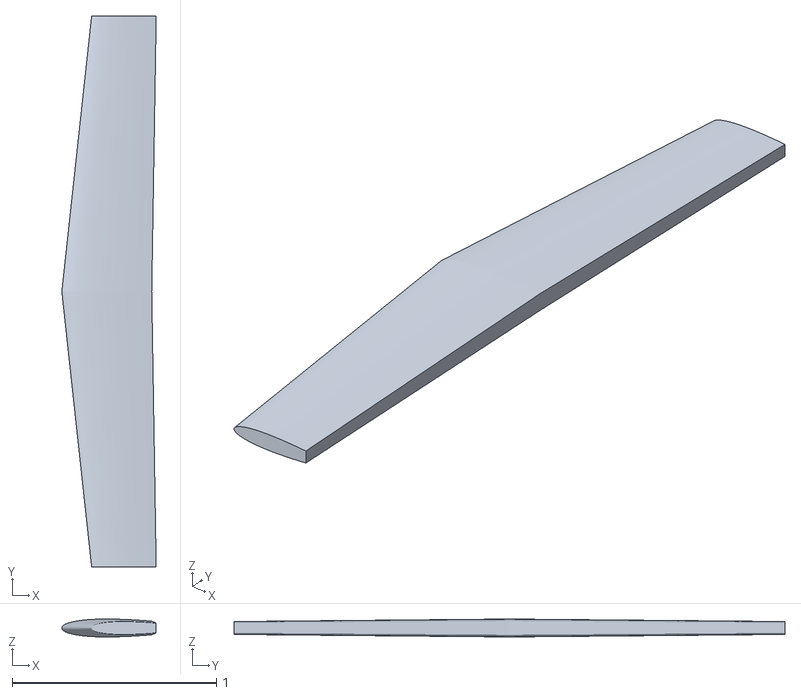
[picture p37: CAD file, 2026-11-10]
cad/generated/eidolon_v1_stabiliser.stl
0.463 x 2.70 x 0.0881
