hima0407/Project-Eidolon/cad/generated/internals/eidolon_v1_int_seat_pan.stl

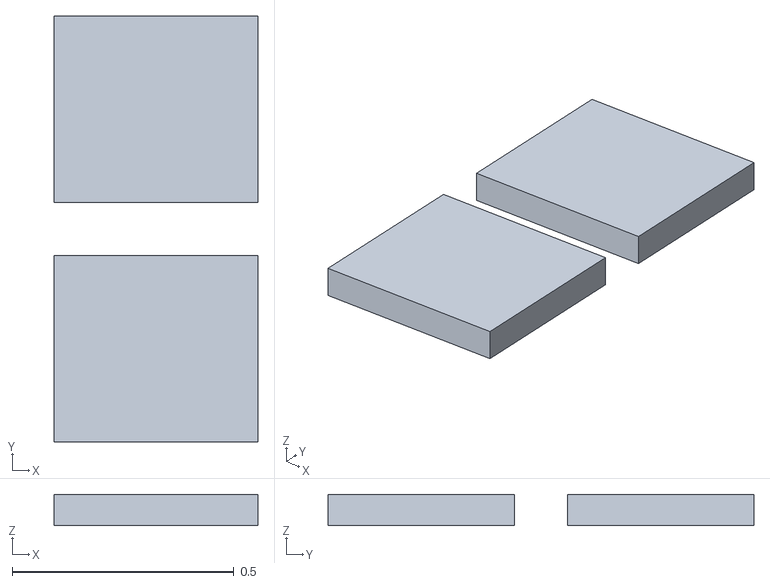
[picture p38: CAD file, 2026-11-12]
cad/generated/internals/eidolon_v1_int_seat_pan.stl
0.46 x 0.96 x 0.07
