hima0407/Project-Eidolon/cad/generated/eidolon_v1_elevator.stl

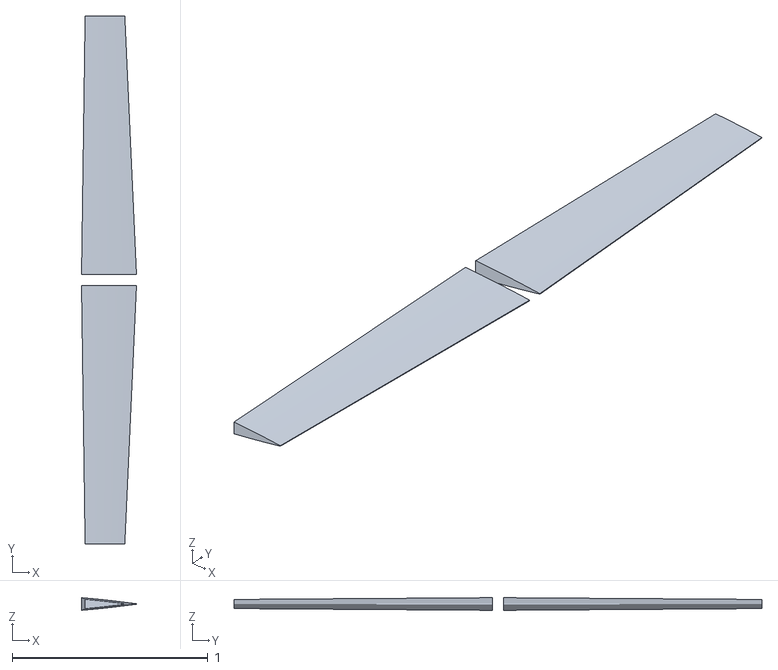
[picture p39: CAD file, 2026-11-10]
cad/generated/eidolon_v1_elevator.stl
0.281 x 2.70 x 0.0648
