hima0407/Project-Eidolon/cad/generated/internals/eidolon_v1_int_crew_head.stl

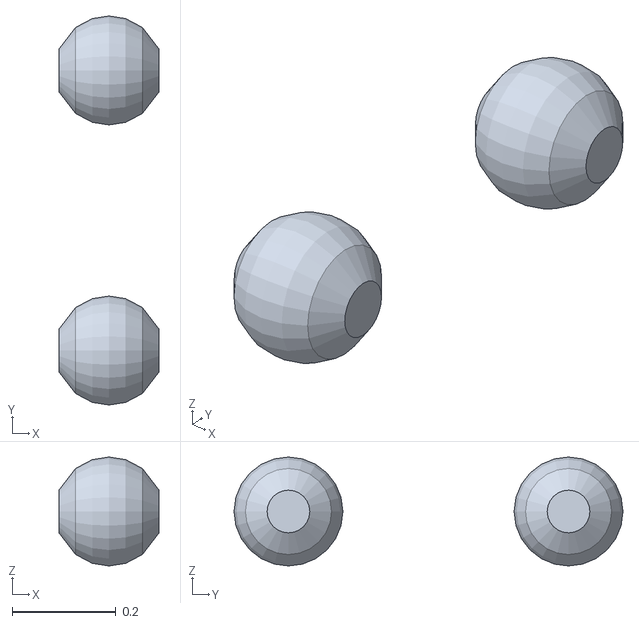
[picture p40: CAD file, 2026-11-12]
cad/generated/internals/eidolon_v1_int_crew_head.stl
0.193 x 0.75 x 0.21
