hima0407/Project-Eidolon/cad/generated/eidolon_v1_stabiliser_tip.stl

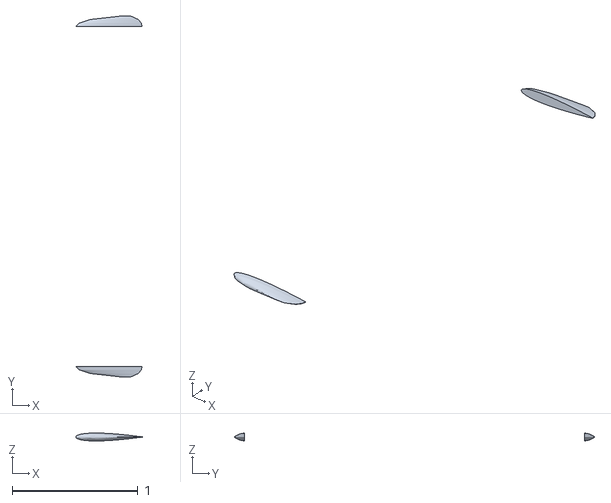
[picture p41: CAD file, 2026-11-10]
cad/generated/eidolon_v1_stabiliser_tip.stl
0.527 x 2.87 x 0.0633
