hima0407/Project-Eidolon/cad/generated/internals/eidolon_v1_int_engine.stl

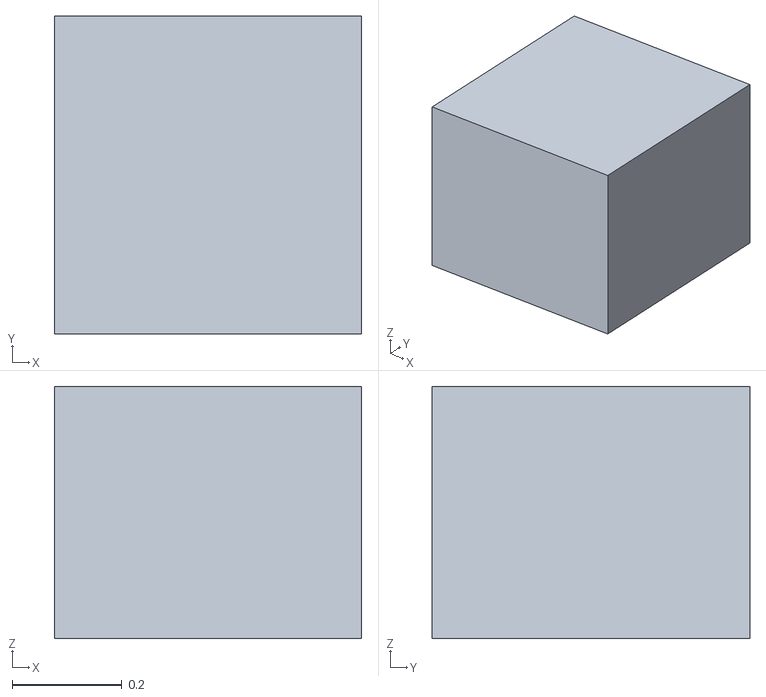
[picture p42: CAD file, 2026-11-12]
cad/generated/internals/eidolon_v1_int_engine.stl
0.56 x 0.58 x 0.46
