hima0407/Project-Eidolon/cad/generated/eidolon_v1_canopy.stl

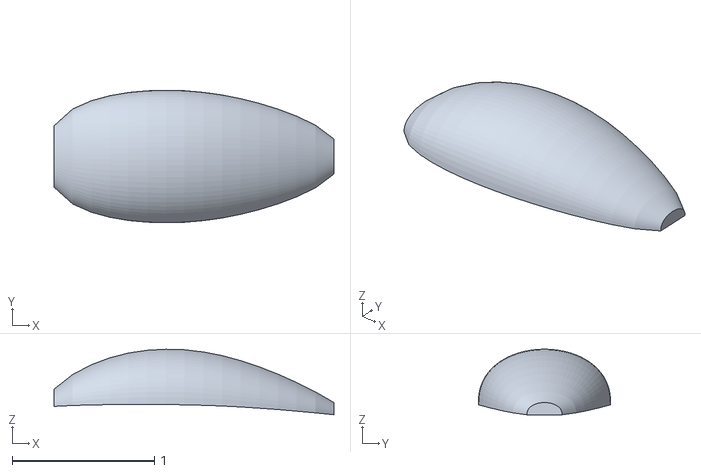
[picture p43: CAD file, 2026-11-10]
cad/generated/eidolon_v1_canopy.stl
1.97 x 0.931 x 0.461
