hima0407/Project-Eidolon/cad/generated/internals/eidolon_v1_int_gear_sensor.stl

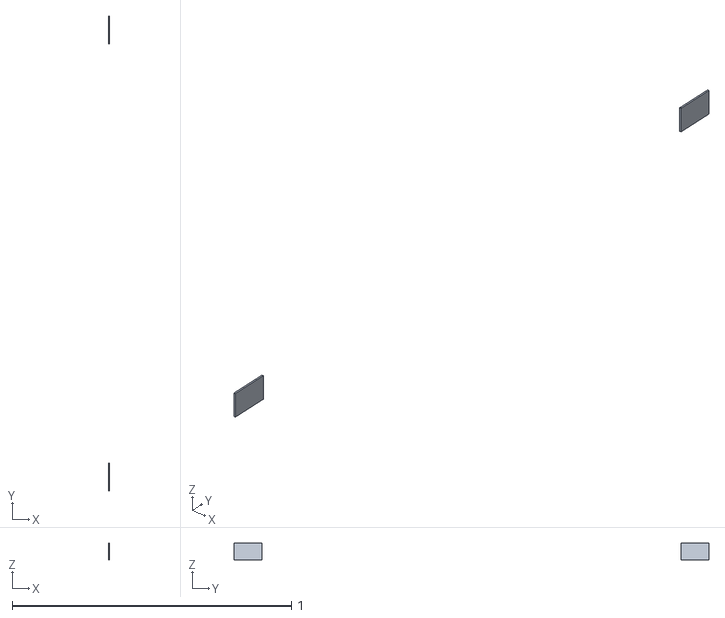
[picture p44: CAD file, 2026-11-12]
cad/generated/internals/eidolon_v1_int_gear_sensor.stl
0.004 x 1.70 x 0.06
