hima0407/Project-Eidolon/cad/generated/eidolon_v1_wing_outboard_cuffed.stl

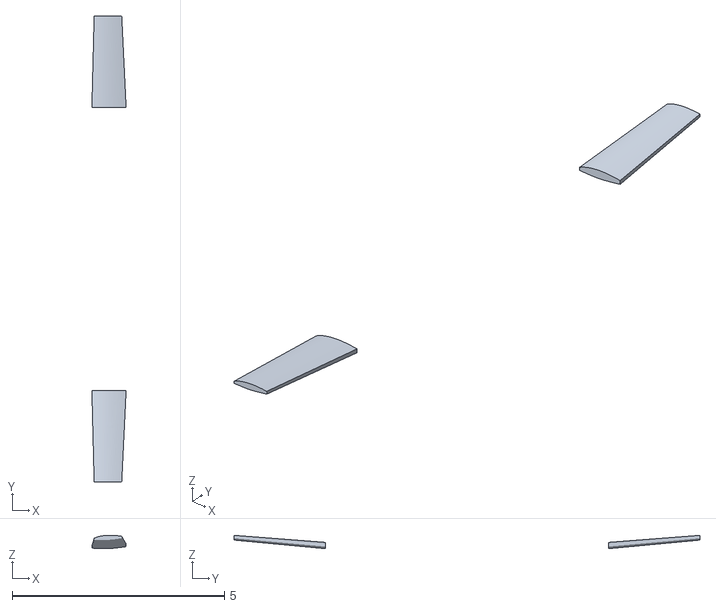
[picture p45: CAD file, 2026-11-10]
cad/generated/eidolon_v1_wing_outboard_cuffed.stl
0.808 x 11.0 x 0.316
