hima0407/Project-Eidolon/cad/generated/internals/eidolon_v1_int_rear_spar.stl

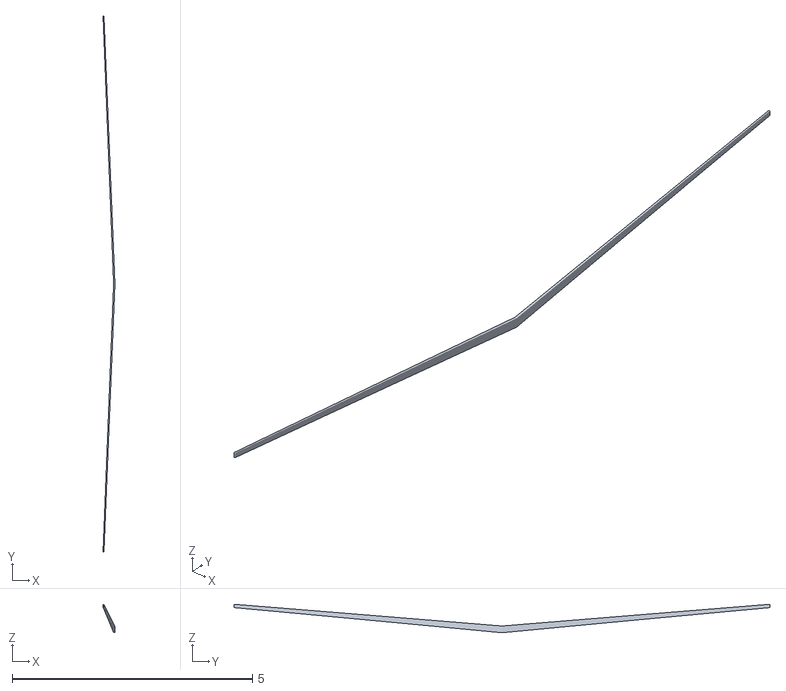
[picture p46: CAD file, 2026-11-12]
cad/generated/internals/eidolon_v1_int_rear_spar.stl
0.249 x 11.2 x 0.593
