hima0407/Project-Eidolon/cad/generated/eidolon_v1_dorsal_fin.stl

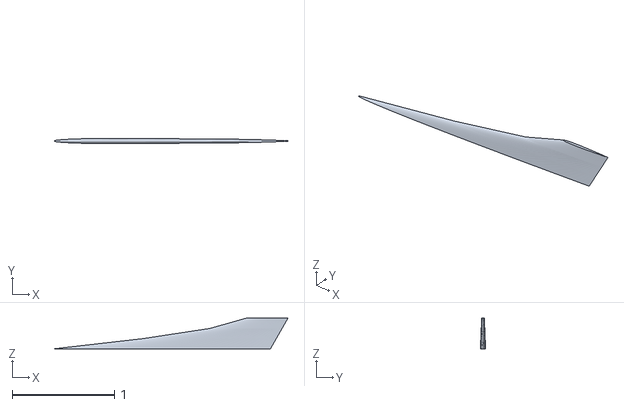
[picture p47: CAD file, 2026-11-10]
cad/generated/eidolon_v1_dorsal_fin.stl
2.29 x 0.0524 x 0.3
