hima0407/Project-Eidolon/cad/generated/internals/eidolon_v1_int_ribs_02.stl

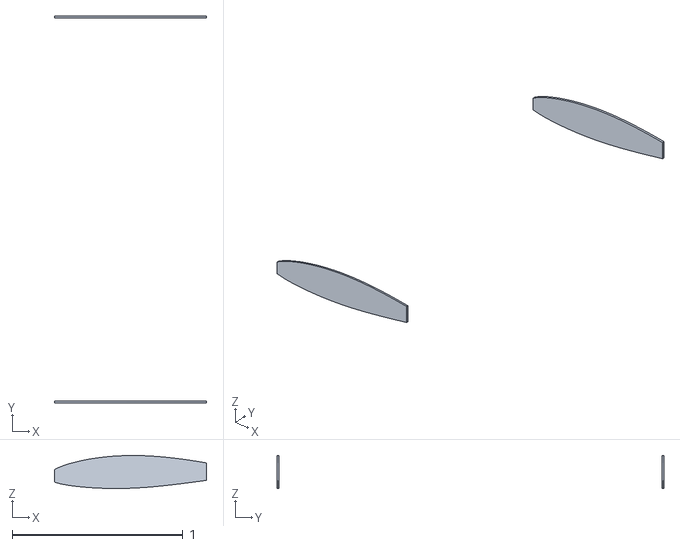
[picture p48: CAD file, 2026-11-12]
cad/generated/internals/eidolon_v1_int_ribs_02.stl
0.89 x 2.26 x 0.193
