hima0407/Project-Eidolon/cad/generated/eidolon_v1_wing_inboard.stl

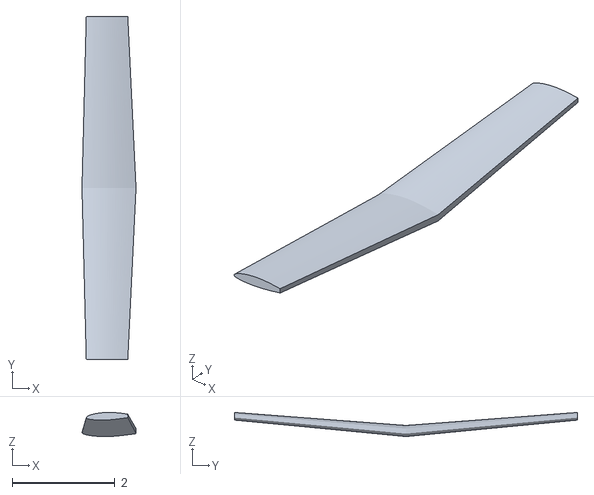
[picture p49: CAD file, 2026-11-10]
cad/generated/eidolon_v1_wing_inboard.stl
1.05 x 6.67 x 0.47
