hima0407/Project-Eidolon/cad/generated/internals/eidolon_v1_int_ribs_11.stl

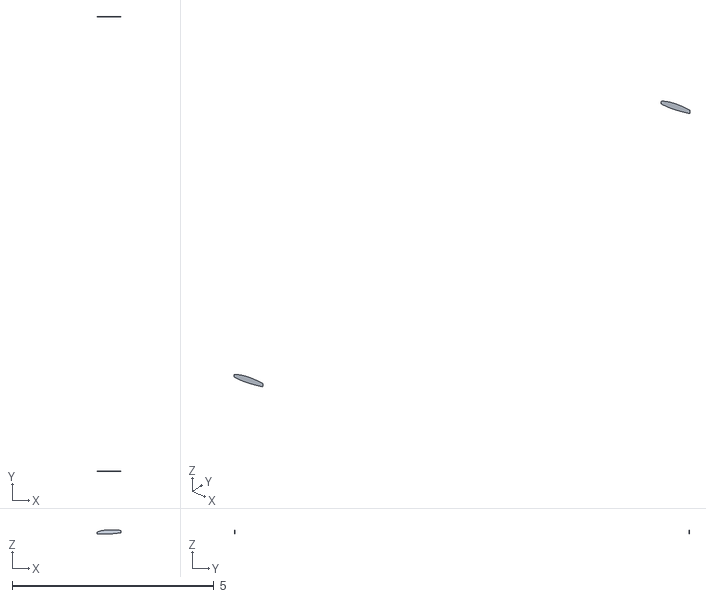
[picture p50: CAD file, 2026-11-12]
cad/generated/internals/eidolon_v1_int_ribs_11.stl
0.589 x 11.3 x 0.111
