hima0407/Project-Eidolon/cad/generated/eidolon_v1_fin.stl

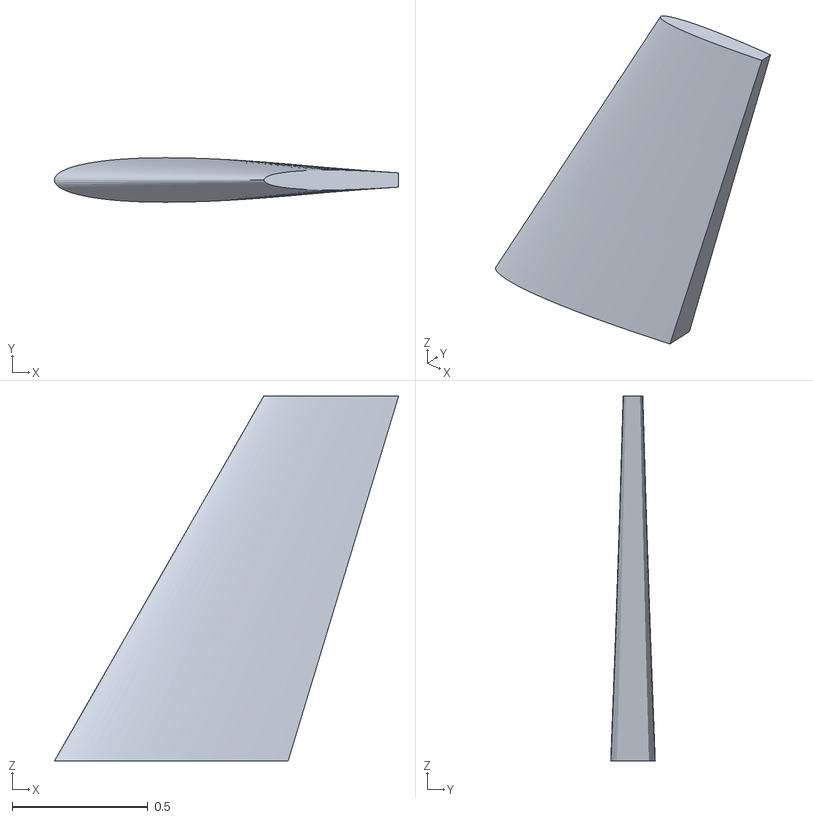
[picture p51: CAD file, 2026-11-10]
cad/generated/eidolon_v1_fin.stl
1.27 x 0.164 x 1.35
