hima0407/Project-Eidolon/cad/generated/internals/eidolon_v1_int_ribs_07.stl

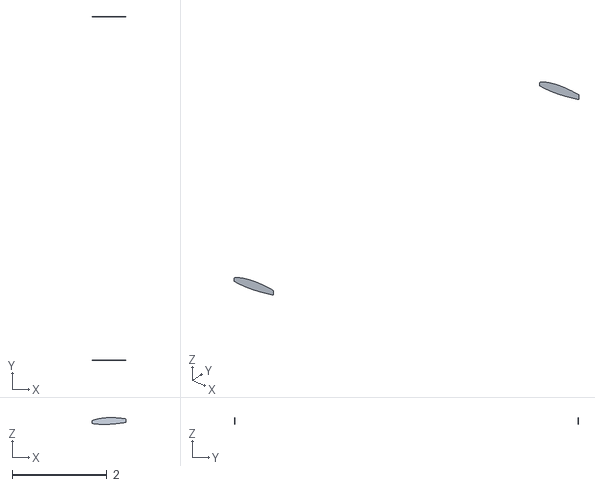
[picture p52: CAD file, 2026-11-12]
cad/generated/internals/eidolon_v1_int_ribs_07.stl
0.723 x 7.26 x 0.145
