hima0407/Project-Eidolon/cad/generated/internals/eidolon_v1_int_crew_torso.stl

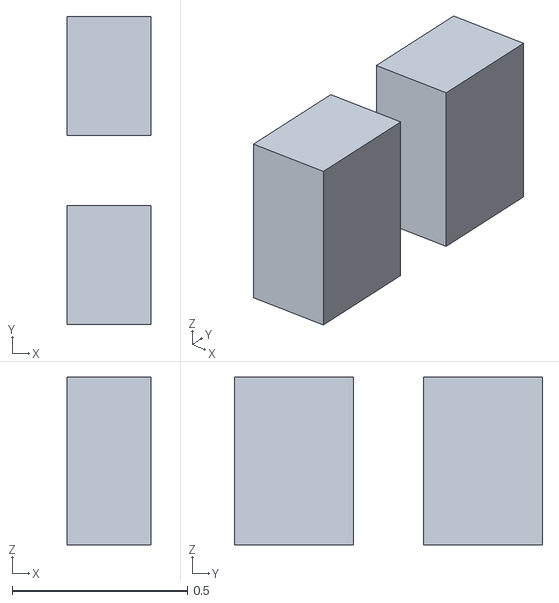
[picture p53: CAD file, 2026-11-12]
cad/generated/internals/eidolon_v1_int_crew_torso.stl
0.24 x 0.88 x 0.48
