hima0407/Project-Eidolon/cad/generated/internals/eidolon_v1_int_ribs_09.stl

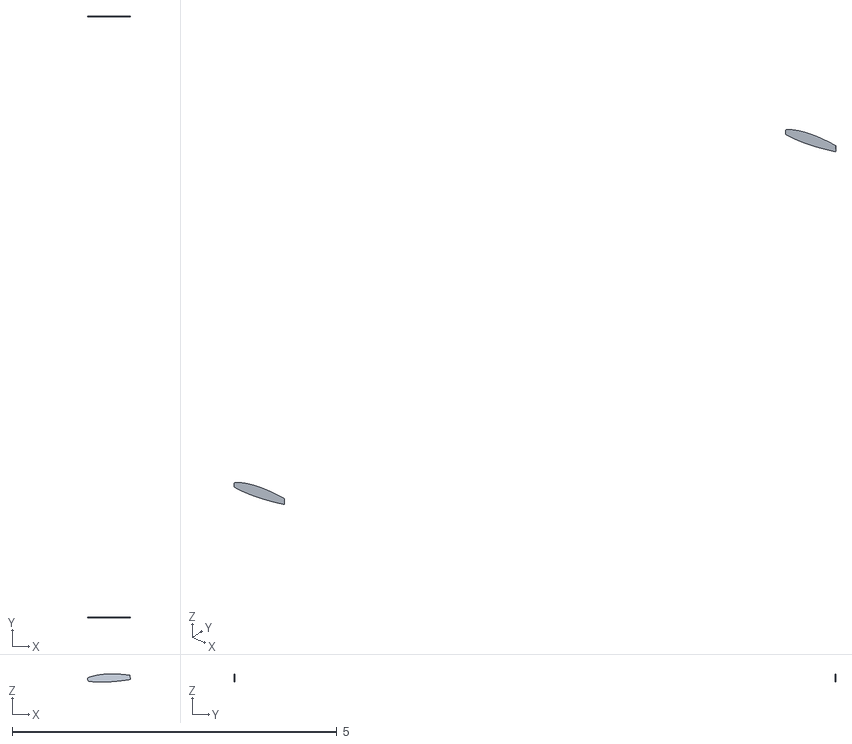
[picture p54: CAD file, 2026-11-12]
cad/generated/internals/eidolon_v1_int_ribs_09.stl
0.656 x 9.26 x 0.128
