hima0407/Project-Eidolon/cad/generated/eidolon_v1_fuselage.stl

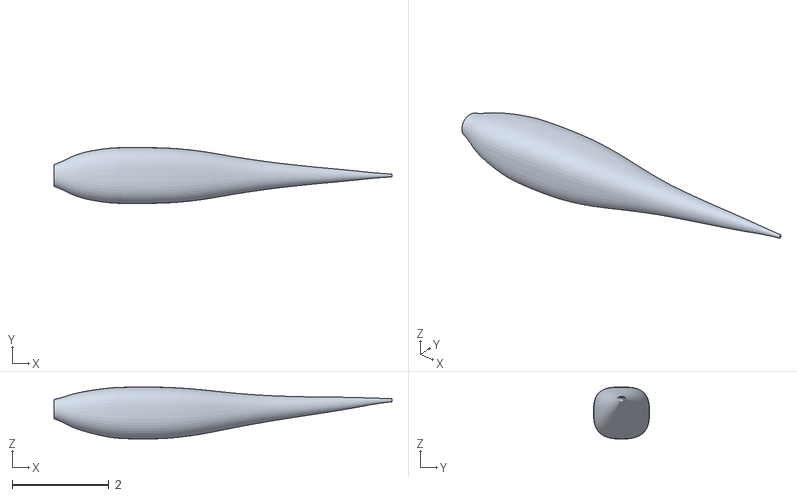
[picture p55: CAD file, 2026-11-10]
cad/generated/eidolon_v1_fuselage.stl
6.98 x 1.16 x 1.07
