hima0407/Project-Eidolon/cad/generated/internals/eidolon_v1_int_battery.stl

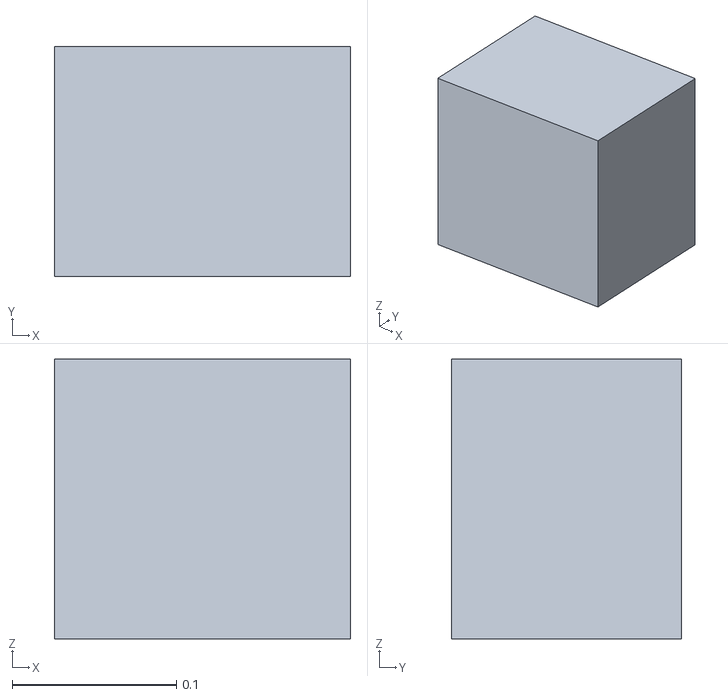
[picture p56: CAD file, 2026-11-12]
cad/generated/internals/eidolon_v1_int_battery.stl
0.18 x 0.14 x 0.17
