hima0407/Project-Eidolon/cad/generated/eidolon_v1_wing_te_filler.stl

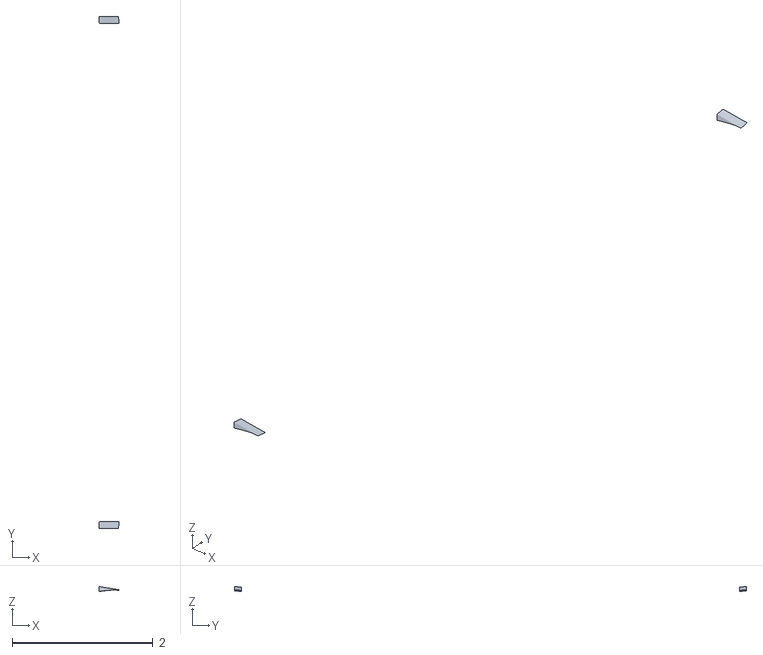
[picture p57: CAD file, 2026-11-10]
cad/generated/eidolon_v1_wing_te_filler.stl
0.286 x 7.27 x 0.0709
