hima0407/Project-Eidolon/cad/generated/internals/eidolon_v1_int_fuel_tank.stl

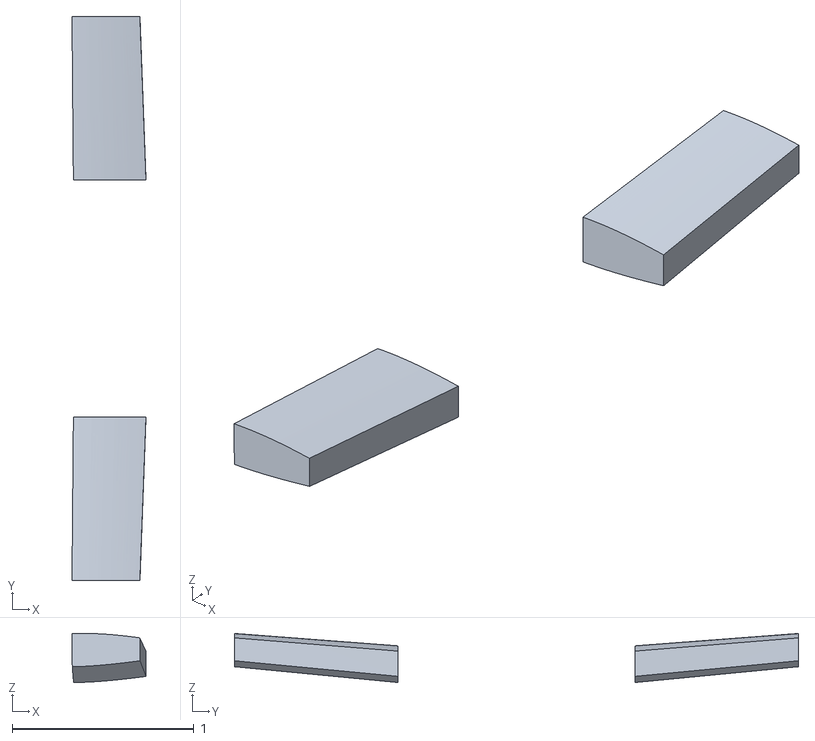
[picture p58: CAD file, 2026-11-12]
cad/generated/internals/eidolon_v1_int_fuel_tank.stl
0.407 x 3.10 x 0.27
