hima0407/Project-Eidolon/cad/generated/eidolon_v1_fin_tip.stl

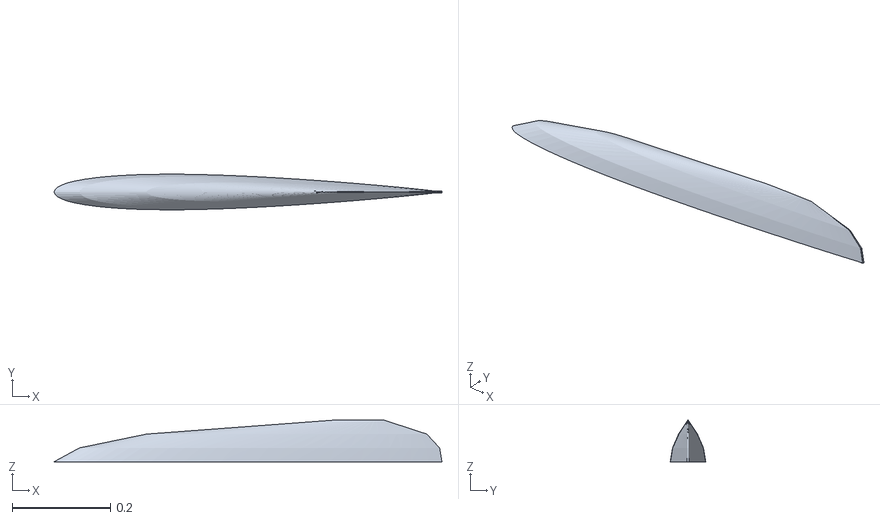
[picture p59: CAD file, 2026-11-10]
cad/generated/eidolon_v1_fin_tip.stl
0.789 x 0.0726 x 0.0845
