hima0407/Project-Eidolon/cad/generated/internals/eidolon_v1_int_stick.stl

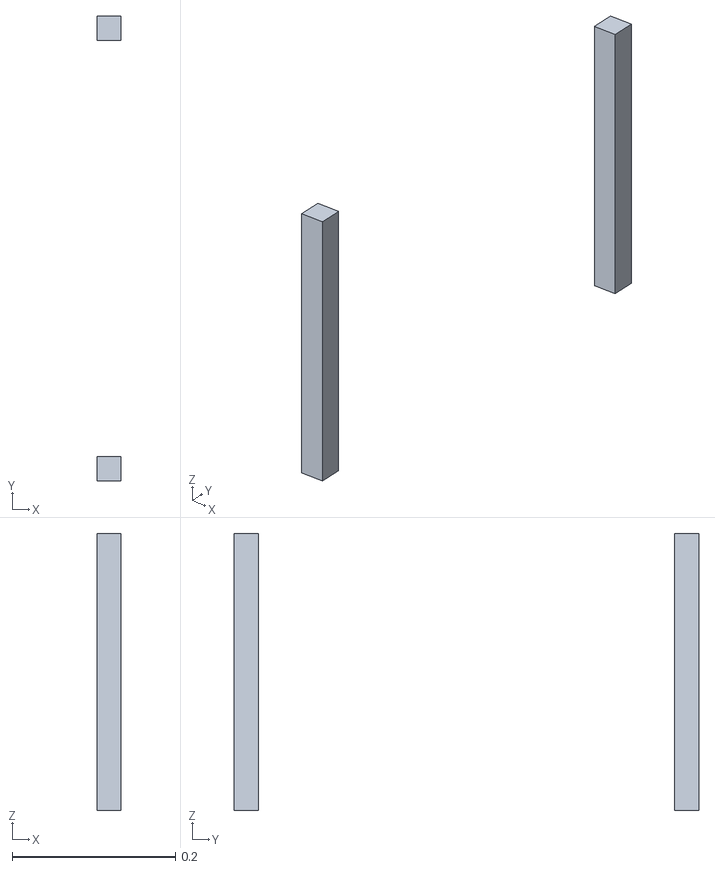
[picture p60: CAD file, 2026-11-12]
cad/generated/internals/eidolon_v1_int_stick.stl
0.03 x 0.57 x 0.34
