hima0407/Project-Eidolon/cad/generated/eidolon_v1_propeller_blade.stl

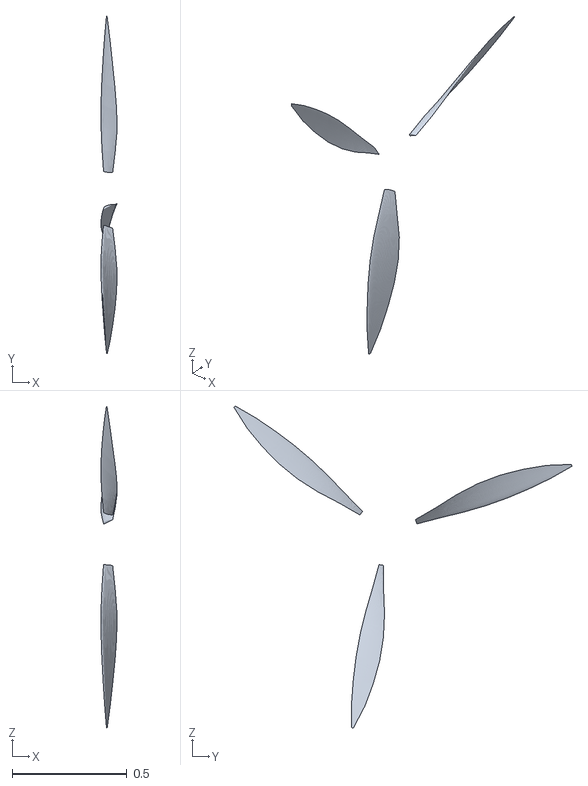
[picture p61: CAD file, 2026-11-10]
cad/generated/eidolon_v1_propeller_blade.stl
0.07 x 1.47 x 1.41
