hima0407/Project-Eidolon/cad/generated/internals/eidolon_v1_int_seat_back.stl

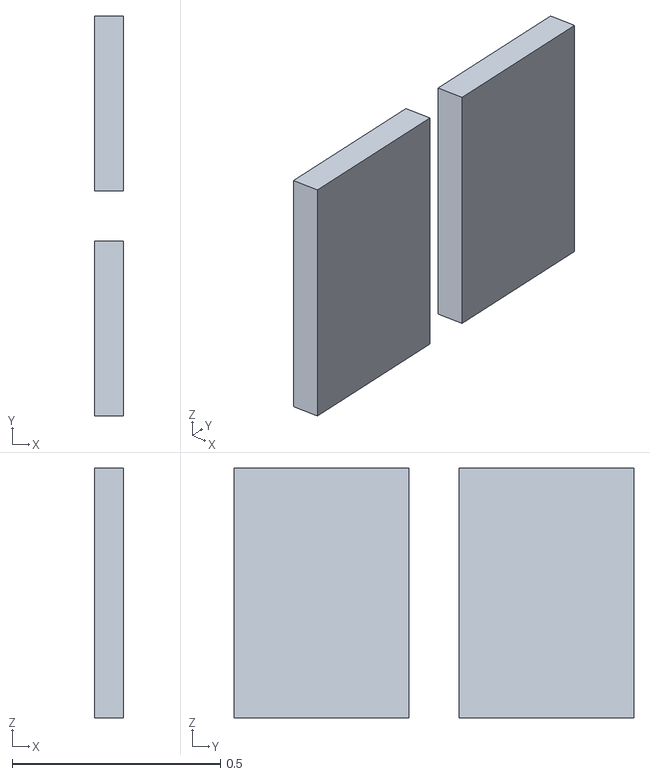
[picture p62: CAD file, 2026-11-12]
cad/generated/internals/eidolon_v1_int_seat_back.stl
0.07 x 0.96 x 0.6
