hima0407/Project-Eidolon/cad/generated/eidolon_v1_ventral_strake.stl

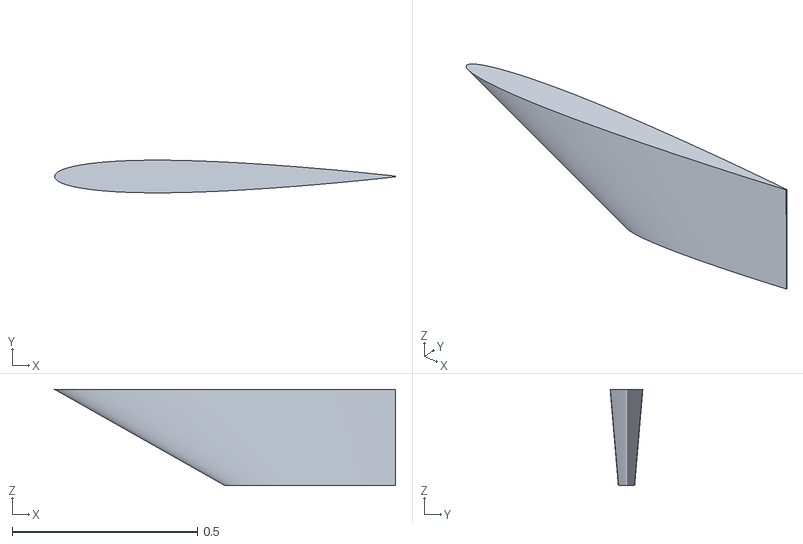
[picture p63: CAD file, 2026-11-10]
cad/generated/eidolon_v1_ventral_strake.stl
0.921 x 0.0884 x 0.26
