hima0407/Project-Eidolon/cad/generated/eidolon_v1_nose_wheel_fairing.stl

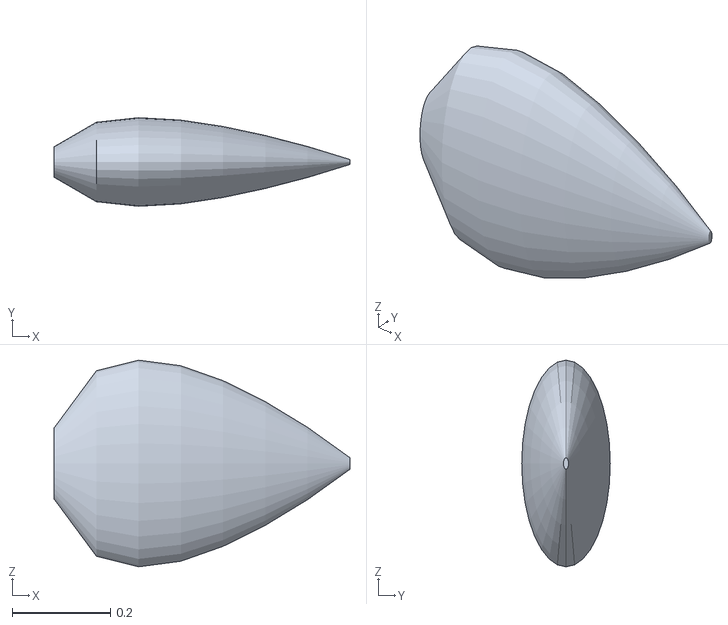
[picture p64: CAD file, 2026-11-10]
cad/generated/eidolon_v1_nose_wheel_fairing.stl
0.601 x 0.18 x 0.42
