hima0407/Project-Eidolon/cad/generated/internals/eidolon_v1_int_ribs_03.stl

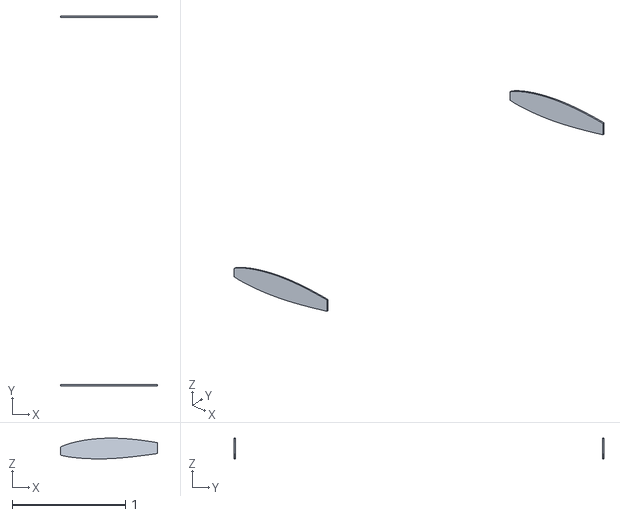
[picture p65: CAD file, 2026-11-12]
cad/generated/internals/eidolon_v1_int_ribs_03.stl
0.857 x 3.26 x 0.183
