hima0407/Project-Eidolon/cad/generated/eidolon_v1_aileron.stl

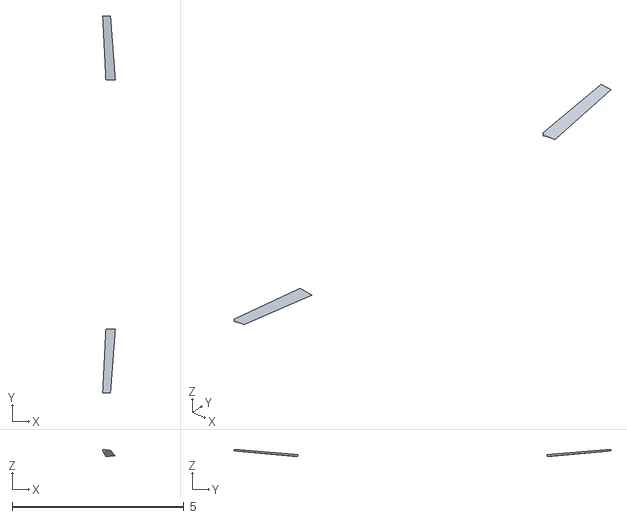
[picture p66: CAD file, 2026-11-10]
cad/generated/eidolon_v1_aileron.stl
0.371 x 11.0 x 0.217
