hima0407/Project-Eidolon/cad/generated/internals/eidolon_v1_internals_all.stl

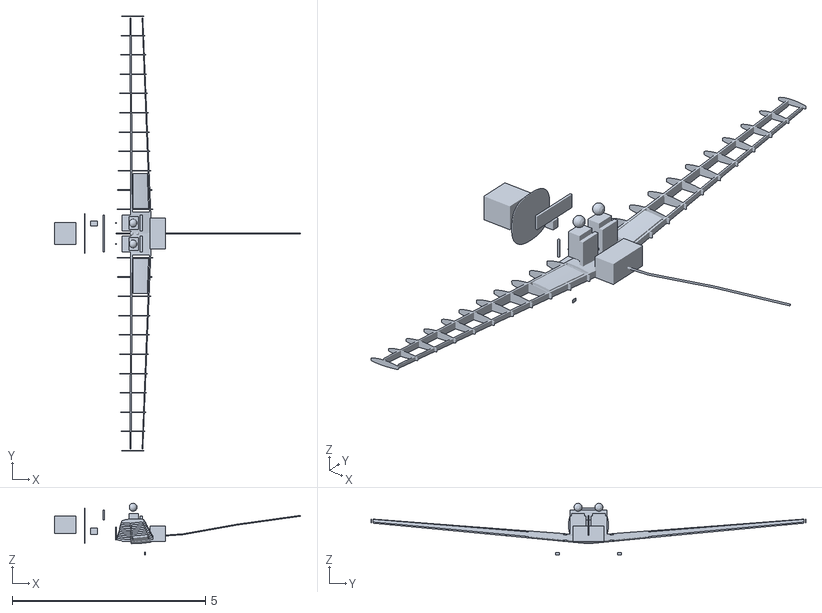
[picture p67: CAD file, 2026-11-12]
cad/generated/internals/eidolon_v1_internals_all.stl
6.38 x 11.3 x 1.33
