hima0407/Project-Eidolon/cad/generated/eidolon_v1_nose_gear_leg.stl

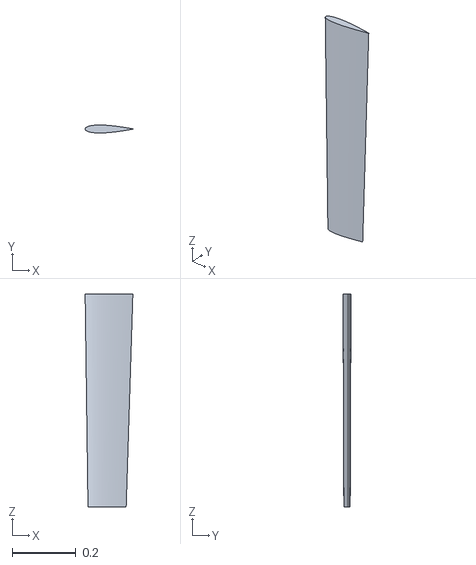
[picture p68: CAD file, 2026-11-10]
cad/generated/eidolon_v1_nose_gear_leg.stl
0.15 x 0.0252 x 0.669
