hima0407/Project-Eidolon/cad/generated/internals/eidolon_v1_int_ribs_08.stl

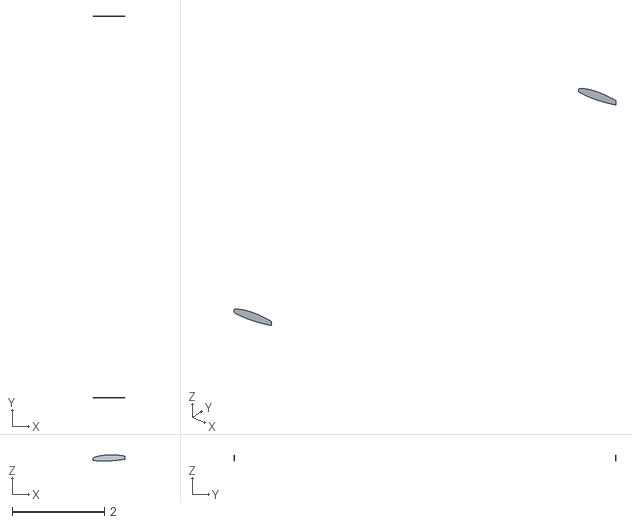
[picture p69: CAD file, 2026-11-12]
cad/generated/internals/eidolon_v1_int_ribs_08.stl
0.689 x 8.26 x 0.136
