hima0407/Project-Eidolon/cad/generated/eidolon_v1_flap.stl

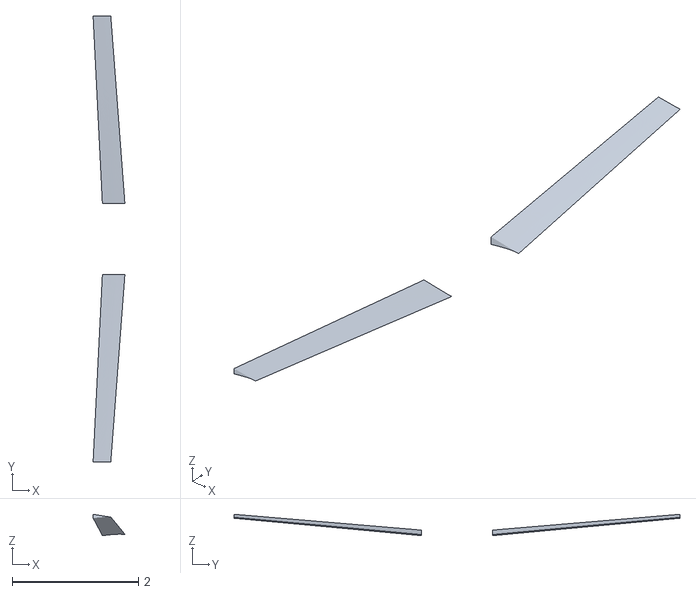
[picture p70: CAD file, 2026-11-10]
cad/generated/eidolon_v1_flap.stl
0.505 x 7.07 x 0.34
