hima0407/Project-Eidolon/cad/generated/internals/eidolon_v1_int_cg_marker.stl

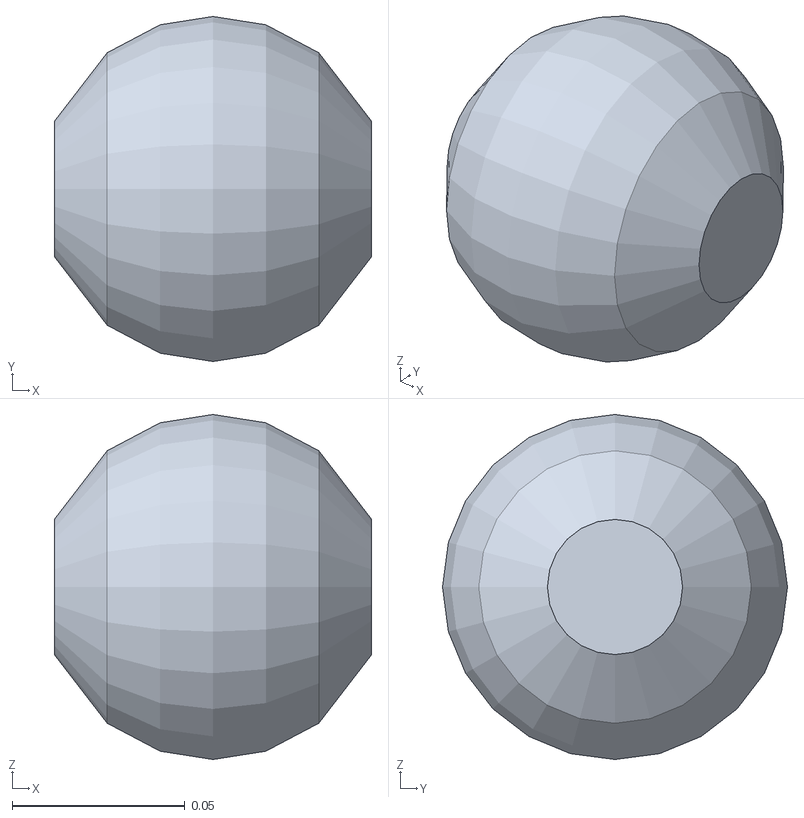
[picture p71: CAD file, 2026-11-12]
cad/generated/internals/eidolon_v1_int_cg_marker.stl
0.092 x 0.1 x 0.1
