hima0407/Project-Eidolon/cad/generated/eidolon_v1_wing_tip.stl

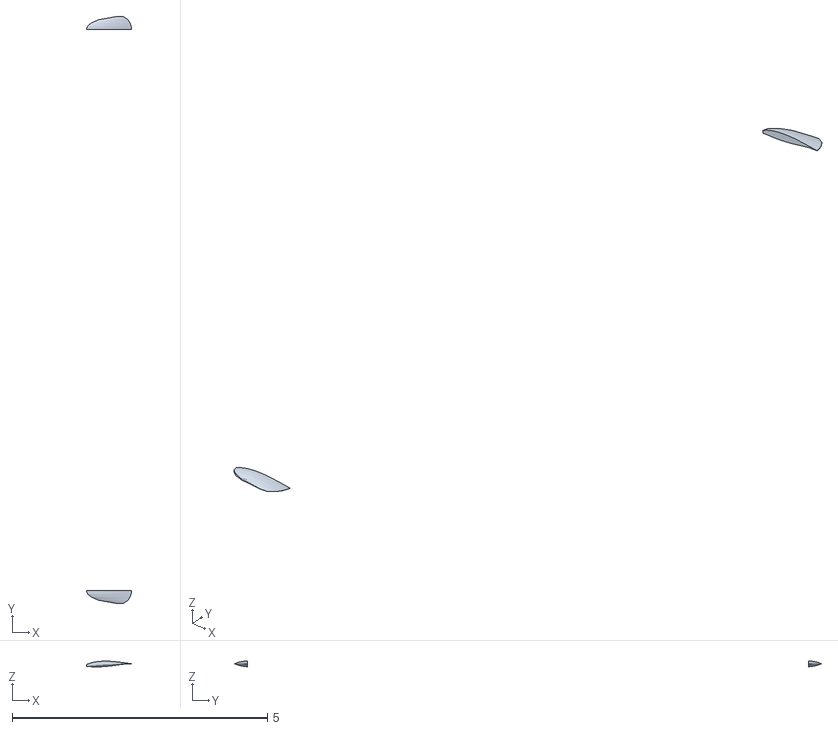
[picture p72: CAD file, 2026-11-10]
cad/generated/eidolon_v1_wing_tip.stl
0.89 x 11.5 x 0.113
