hima0407/Project-Eidolon/cad/generated/internals/eidolon_v1_int_baggage.stl

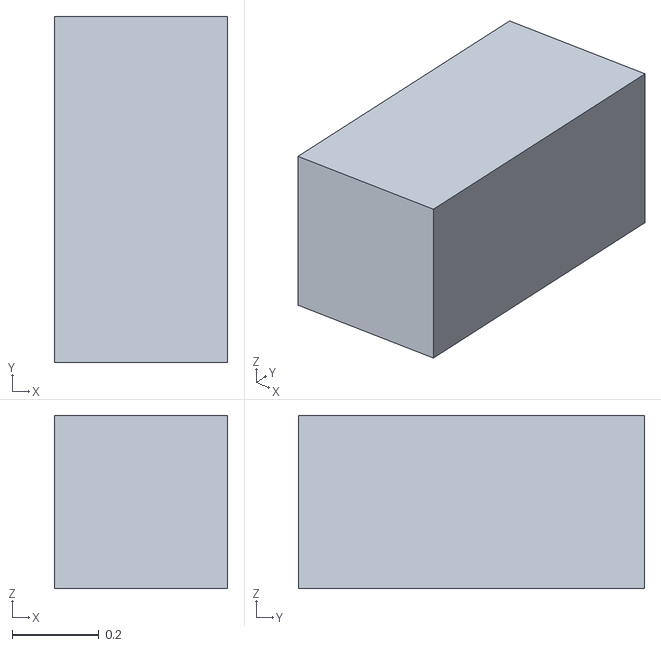
[picture p73: CAD file, 2026-11-12]
cad/generated/internals/eidolon_v1_int_baggage.stl
0.4 x 0.8 x 0.4
