hima0407/Project-Eidolon/cad/generated/internals/eidolon_v1_int_ribs_05.stl

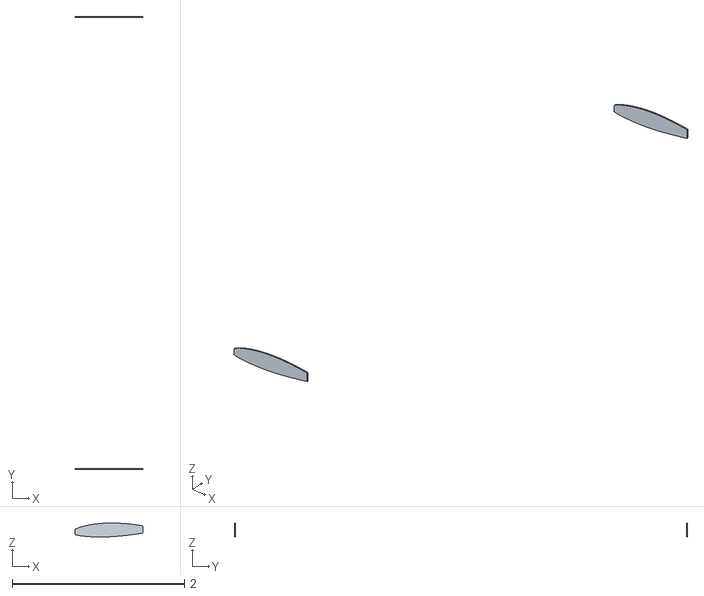
[picture p74: CAD file, 2026-11-12]
cad/generated/internals/eidolon_v1_int_ribs_05.stl
0.79 x 5.26 x 0.163
