hima0407/Project-Eidolon/cad/generated/internals/eidolon_v1_int_np_marker.stl

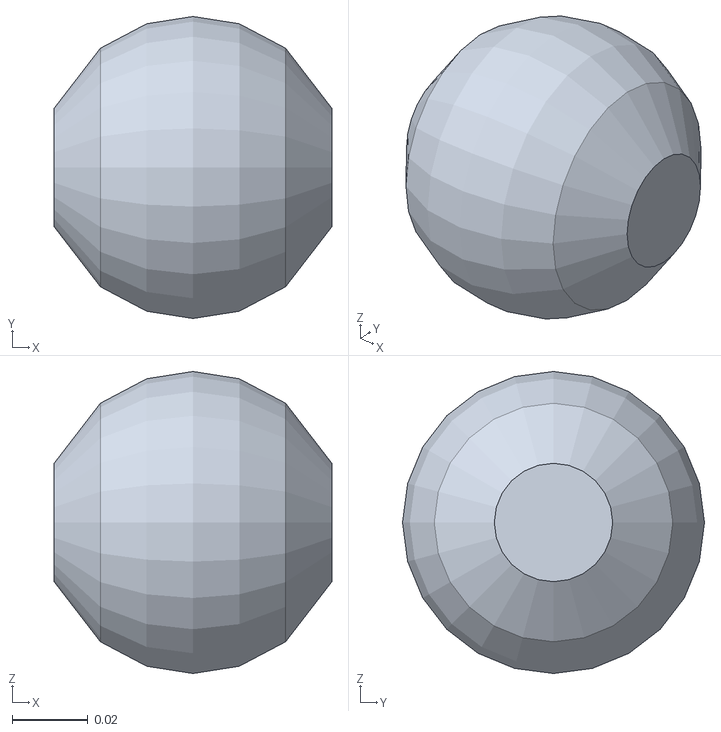
[picture p75: CAD file, 2026-11-12]
cad/generated/internals/eidolon_v1_int_np_marker.stl
0.0736 x 0.08 x 0.08
