hima0407/Project-Eidolon/cad/generated/internals/eidolon_v1_int_firewall.stl

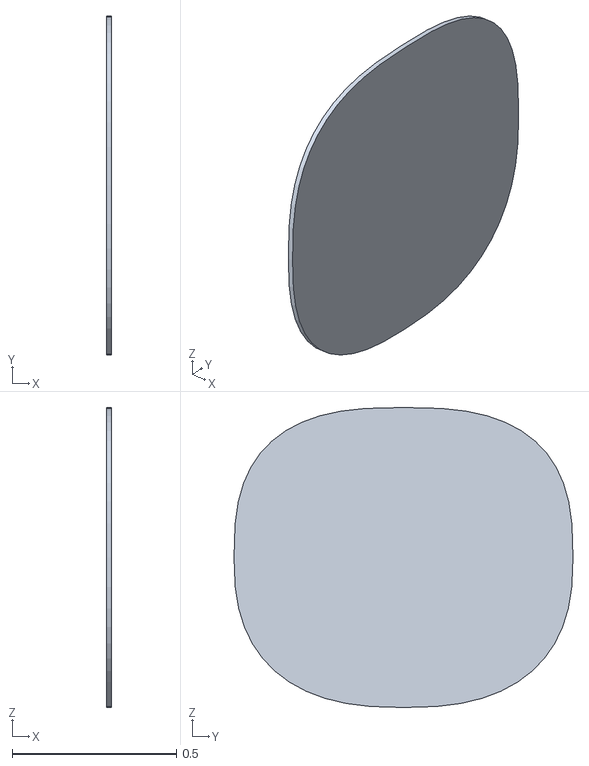
[picture p76: CAD file, 2026-11-12]
cad/generated/internals/eidolon_v1_int_firewall.stl
0.015 x 1.03 x 0.914
