hima0407/Project-Eidolon/cad/generated/internals/eidolon_v1_int_panel.stl

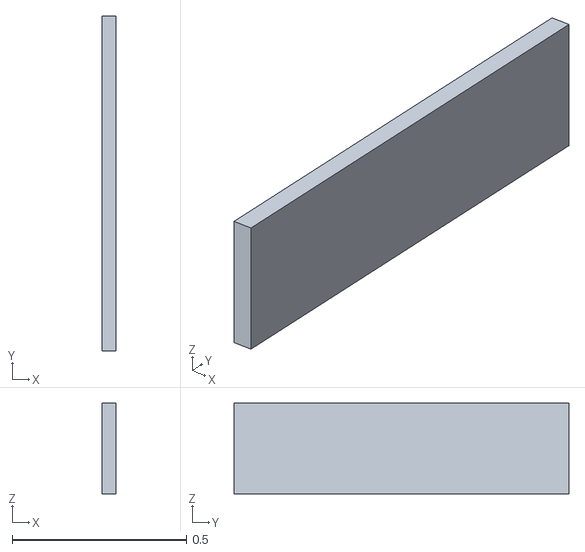
[picture p77: CAD file, 2026-11-12]
cad/generated/internals/eidolon_v1_int_panel.stl
0.04 x 0.96 x 0.26
