hima0407/Project-Eidolon/cad/generated/internals/eidolon_v1_int_ribs_04.stl

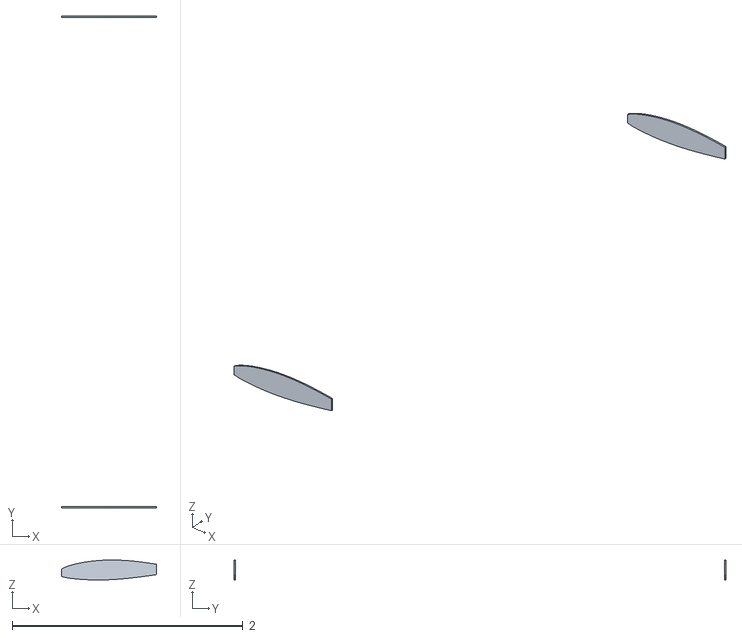
[picture p78: CAD file, 2026-11-12]
cad/generated/internals/eidolon_v1_int_ribs_04.stl
0.823 x 4.26 x 0.173
