hima0407/Project-Eidolon/cad/generated/internals/eidolon_v1_int_ribs_01.stl

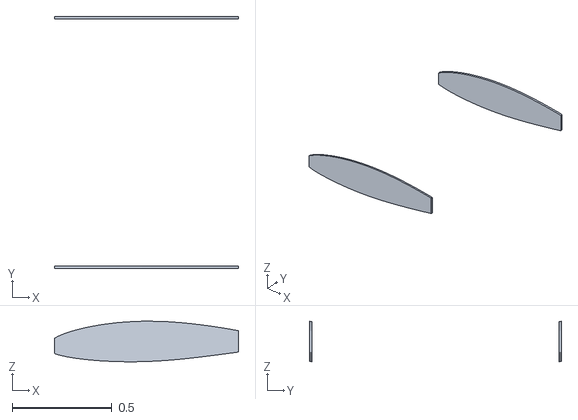
[picture p79: CAD file, 2026-11-12]
cad/generated/internals/eidolon_v1_int_ribs_01.stl
0.924 x 1.26 x 0.204
