hima0407/Project-Eidolon/(list of files, cad)

Other CAD files:
cad/early/cadv0.step
cad/early/initialtrail0.f3d
