hima0407/Project-Eidolon/results/01_mass/comparators.csv

aircraft | category | published_empty_kg | bottom_up_kg | gap_kg | source
Hansa-NG | certified trainer | 540 | 377.85 | 162.15 | CSIR-NAL brochure 2020
Aquila A210 | certified trainer | 500 | 357.546 | 142.454 | Wikipedia: Aquila A 210
Diamond DV20 Katana | certified trainer | 505 | 363.223 | 141.777 | aeropedia.com.au: HOAC Katana DV-20
Pipistrel Virus SW 100 | light-sport / microlight | 289 | 342.759 | -53.7595 | Wikipedia: Pipistrel Virus
