hima0407/Project-Eidolon/results/01_mass/wing_mass_vs_span.csv

span_m | bottom_up_kg | raymer_kg
9.5 | 79.6821 | 109.661
9.75 | 80.3731 | 113.133
10 | 81.0747 | 116.623
10.25 | 81.7882 | 120.131
10.5 | 82.5145 | 123.655
10.75 | 83.2549 | 127.197
11 | 84.0102 | 130.754
11.25 | 84.7814 | 134.328
11.5 | 85.5694 | 137.918
11.75 | 86.375 | 141.524
12 | 87.1993 | 145.145
12.25 | 88.0426 | 148.781
12.5 | 88.906 | 152.432
