hima0407/Project-Eidolon/results/02_calibration/calibration_vs_cruise_power_assumption.csv

cruise_power_fraction | mass_cal | drag_cal | climb_cal
0.65 | 1.35227 | 0.00317664 | 0.835134
0.7 | 1.35227 | 0.0057137 | 0.850896
0.75 | 1.35227 | 0.00825076 | 0.865838
0.8 | 1.35227 | 0.010763 | 0.880086
0.85 | 1.35227 | 0.0121559 | 0.887772
