hima0407/Project-Eidolon/archive/first_iteration/results/landing_gear/landing_energy_screening.csv

MTOW_kg_assumed | sink_speed_m_s_assumed | effective_mass_fraction_assumed | gear_energy_share_assumed | stroke_m_assumed | effective_mass_kg | vertical_kinetic_energy_J_screening | gear_energy_J_screening | average_force_N_energy_over_stroke | linear_spring_equivalent_stiffness_N_m | ideal_linear_spring_end_force_N
600.0 | 1.5 | 0.25 | 0.5 | 0.08 | 150.0 | 168.75 | 84.375 | 1054.6875 | 26367.1875 | 2109.375
600.0 | 1.5 | 0.25 | 0.5 | 0.12 | 150.0 | 168.75 | 84.375 | 703.125 | 11718.75 | 1406.25
600.0 | 1.5 | 0.25 | 0.5 | 0.16 | 150.0 | 168.75 | 84.375 | 527.34375 | 6591.796875 | 1054.6875
600.0 | 1.5 | 0.25 | 0.5 | 0.2 | 150.0 | 168.75 | 84.375 | 421.875 | 4218.749999999999 | 843.7499999999999
600.0 | 1.5 | 0.25 | 0.7 | 0.08 | 150.0 | 168.75 | 118.12499999999999 | 1476.5624999999998 | 36914.06249999999 | 2953.1249999999995
600.0 | 1.5 | 0.25 | 0.7 | 0.12 | 150.0 | 168.75 | 118.12499999999999 | 984.3749999999999 | 16406.25 | 1968.75
600.0 | 1.5 | 0.25 | 0.7 | 0.16 | 150.0 | 168.75 | 118.12499999999999 | 738.2812499999999 | 9228.515624999998 | 1476.5624999999998
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
