hima0407/Project-Eidolon/results/01_mass/eidolon_mass_breakdown.png

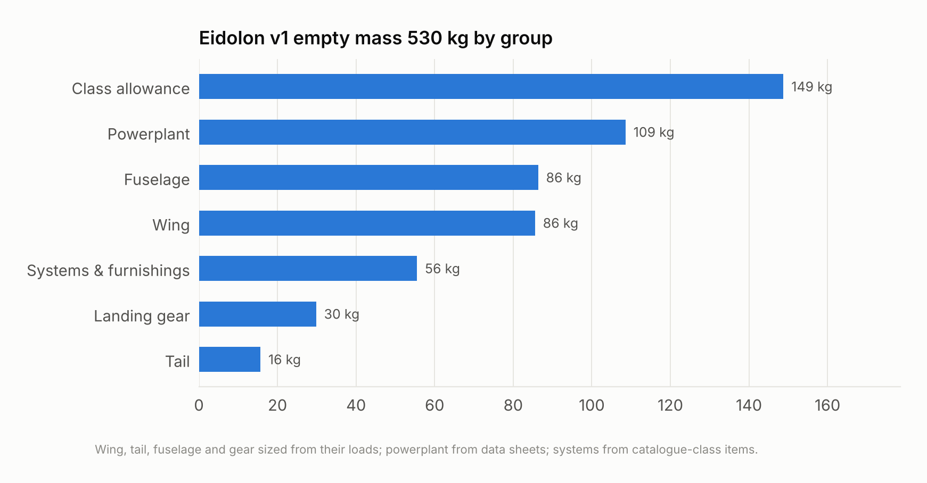
results/01_mass/eidolon_mass_breakdown.png
