hima0407/Project-Eidolon/results/01_mass/wing_mass_vs_span.png

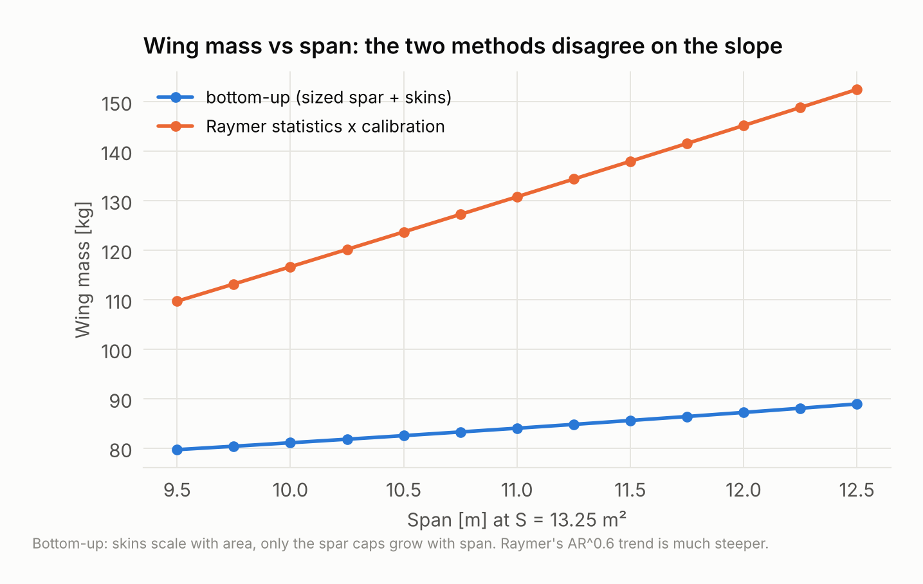
results/01_mass/wing_mass_vs_span.png
