hima0407/Project-Eidolon/results/03_airfoil/airfoil_polars.png

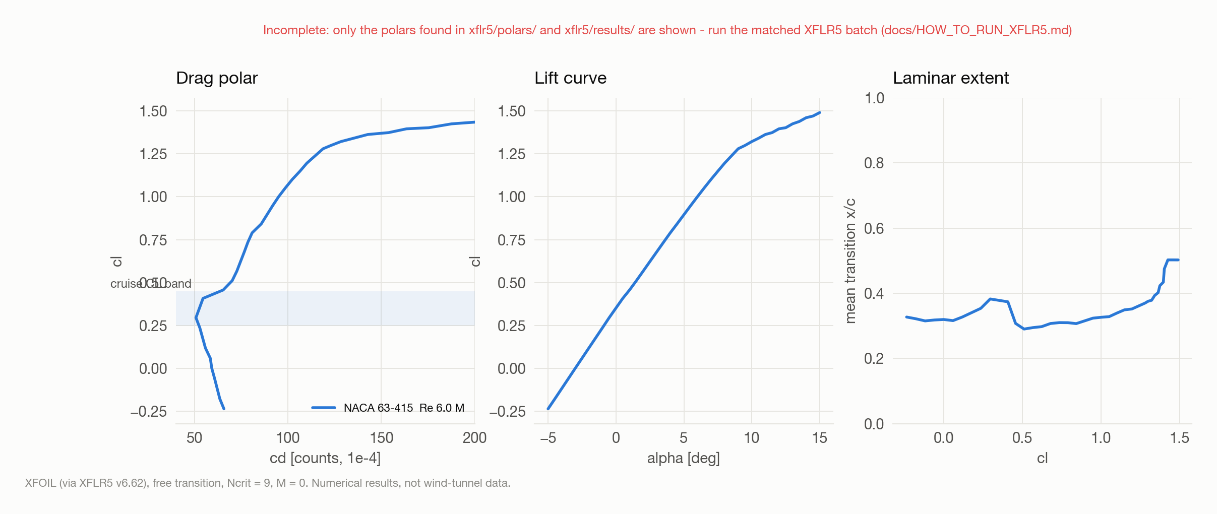
results/03_airfoil/airfoil_polars.png
