hima0407/Project-Eidolon/results/03_airfoil/airfoil_shapes.png

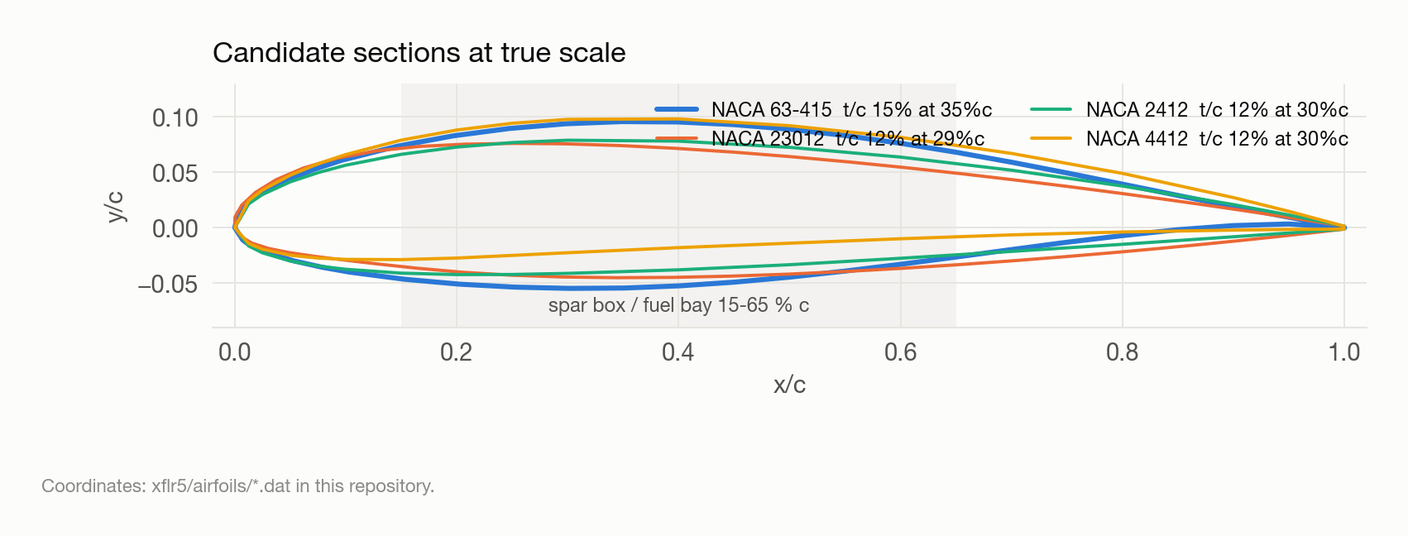
results/03_airfoil/airfoil_shapes.png
