hima0407/Project-Eidolon/results/04_wing/llt_vs_xflr5.png

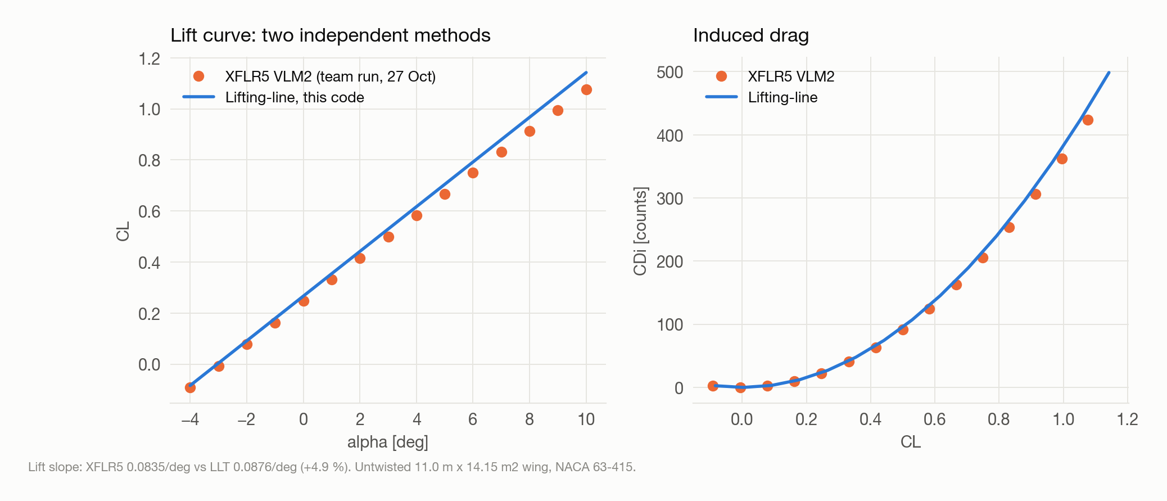
results/04_wing/llt_vs_xflr5.png
