hima0407/Project-Eidolon/results/04_wing/stall_progression.png

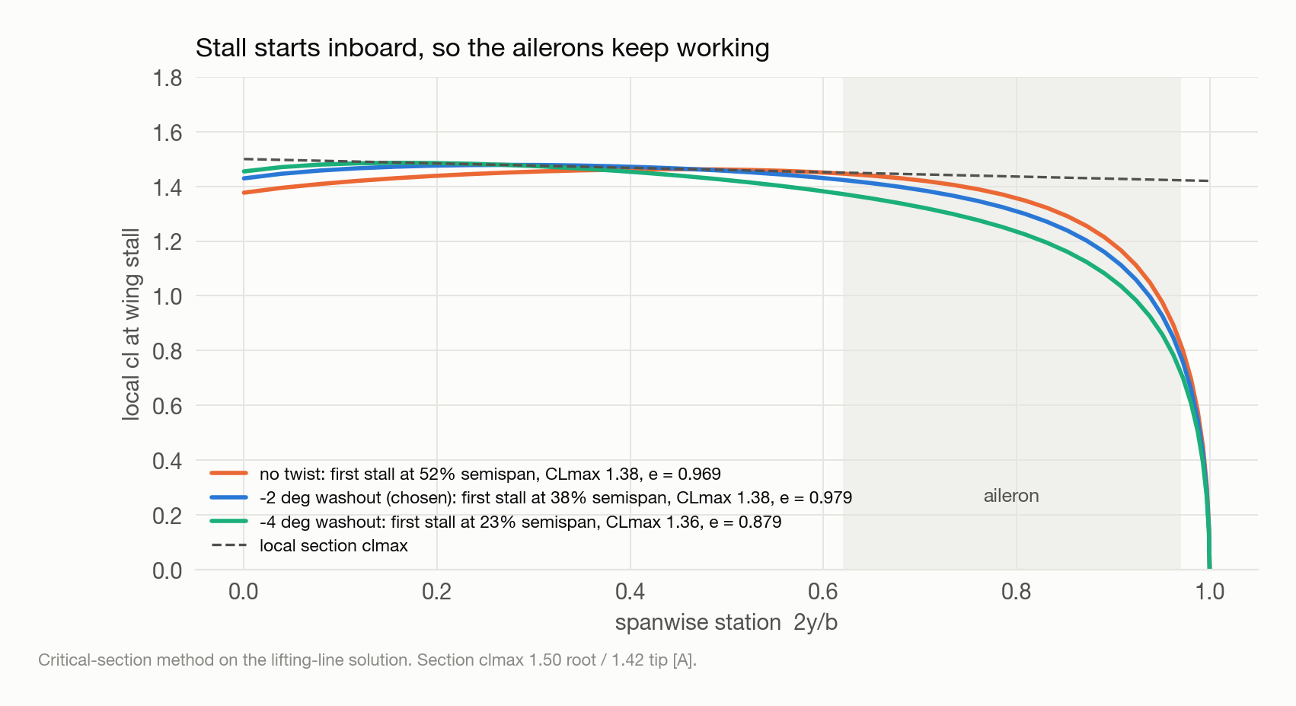
results/04_wing/stall_progression.png
