hima0407/Project-Eidolon/results/05_wing_sizing/constraint_diagram.png

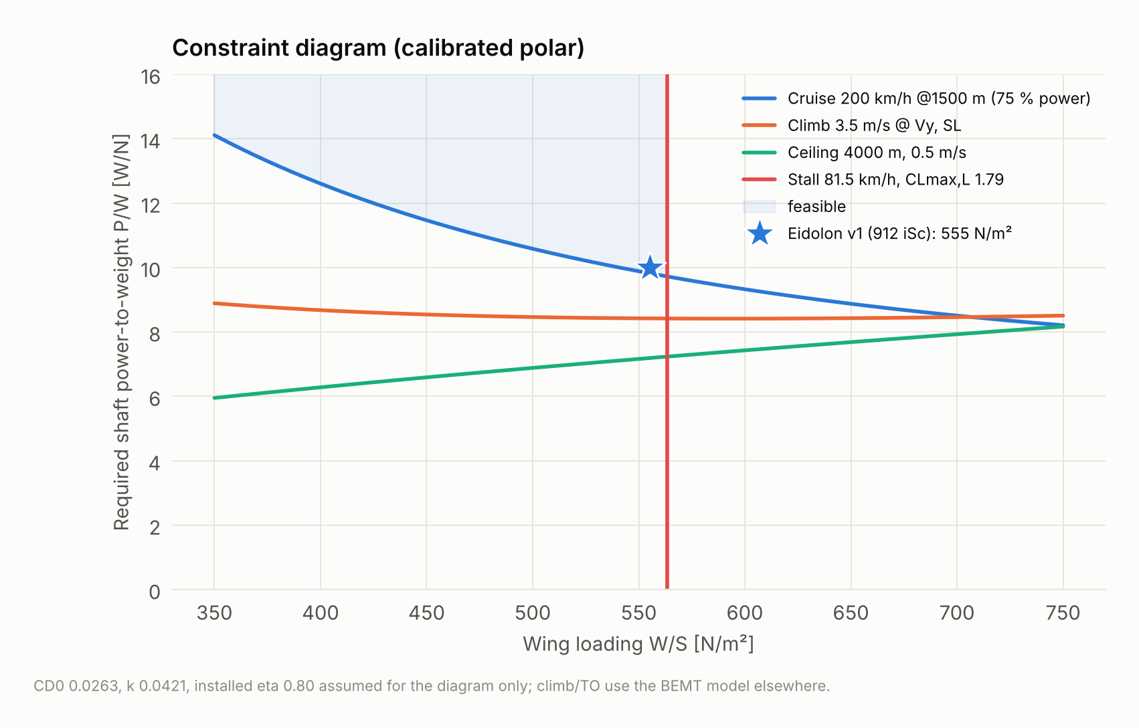
results/05_wing_sizing/constraint_diagram.png
