hima0407/Project-Eidolon/results/06_drag/eidolon_cd0_breakdown.png

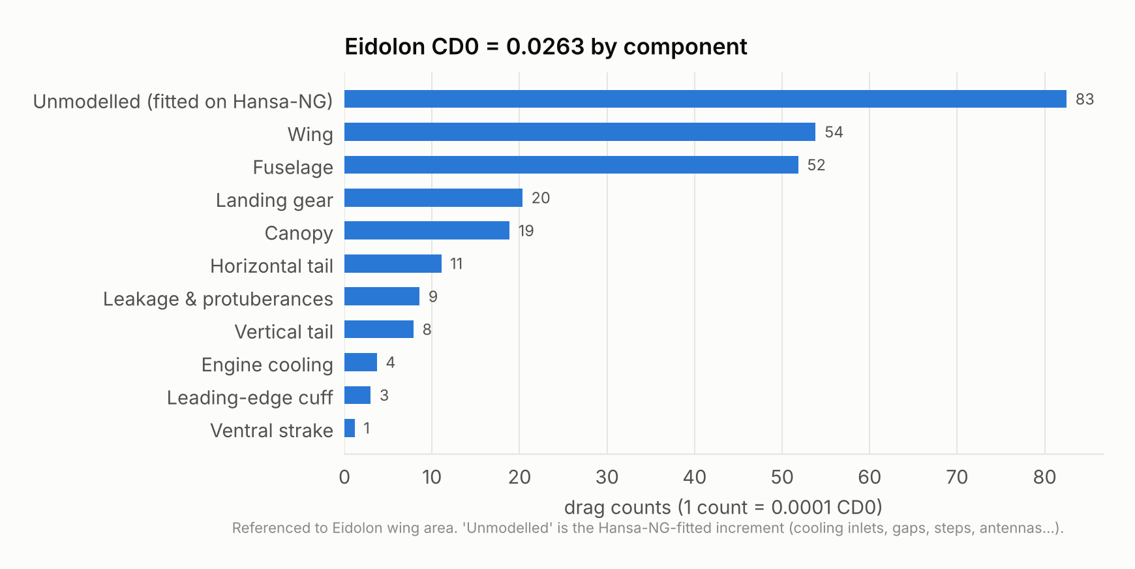
results/06_drag/eidolon_cd0_breakdown.png
