hima0407/Project-Eidolon/results/07_propeller/propeller_efficiency.png

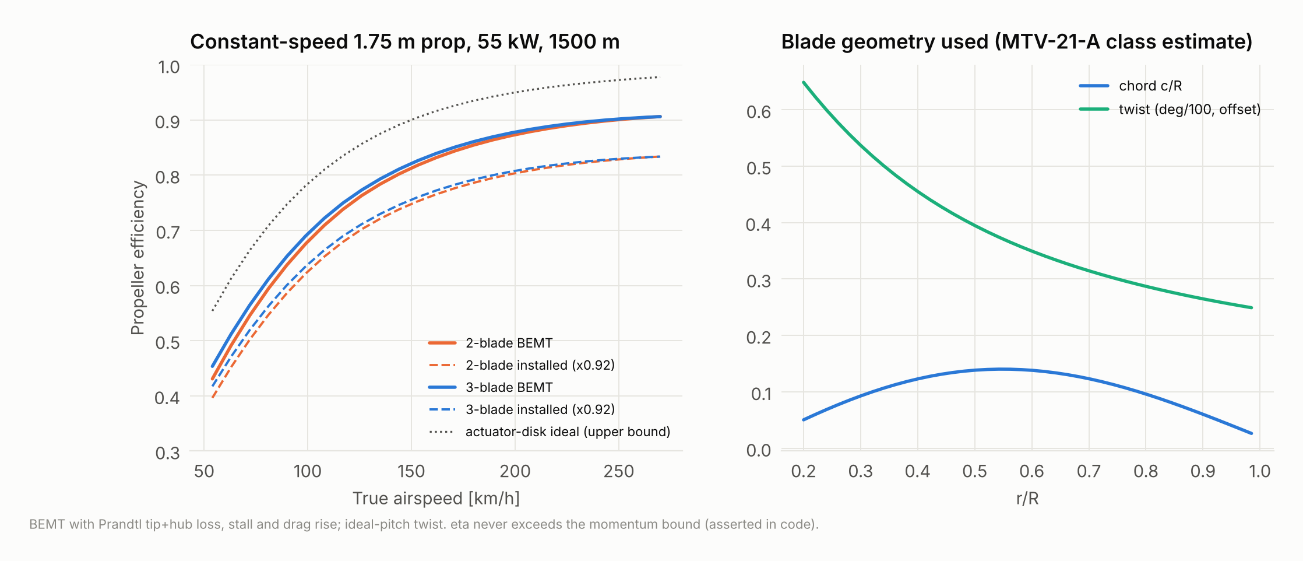
results/07_propeller/propeller_efficiency.png
