hima0407/Project-Eidolon/results/09_tail/elevator_sweep.png

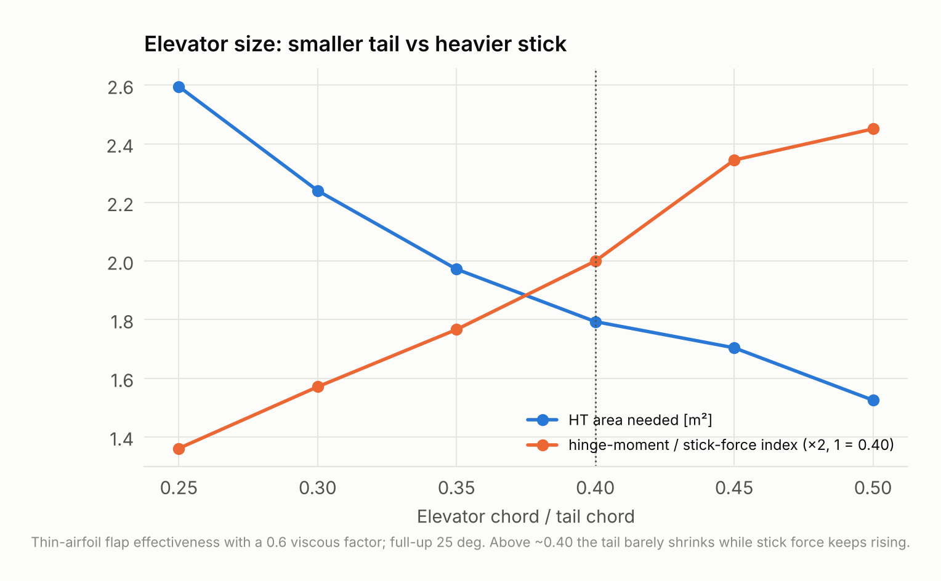
results/09_tail/elevator_sweep.png
