hima0407/Project-Eidolon/results/09_tail/ht_height_sweep.png

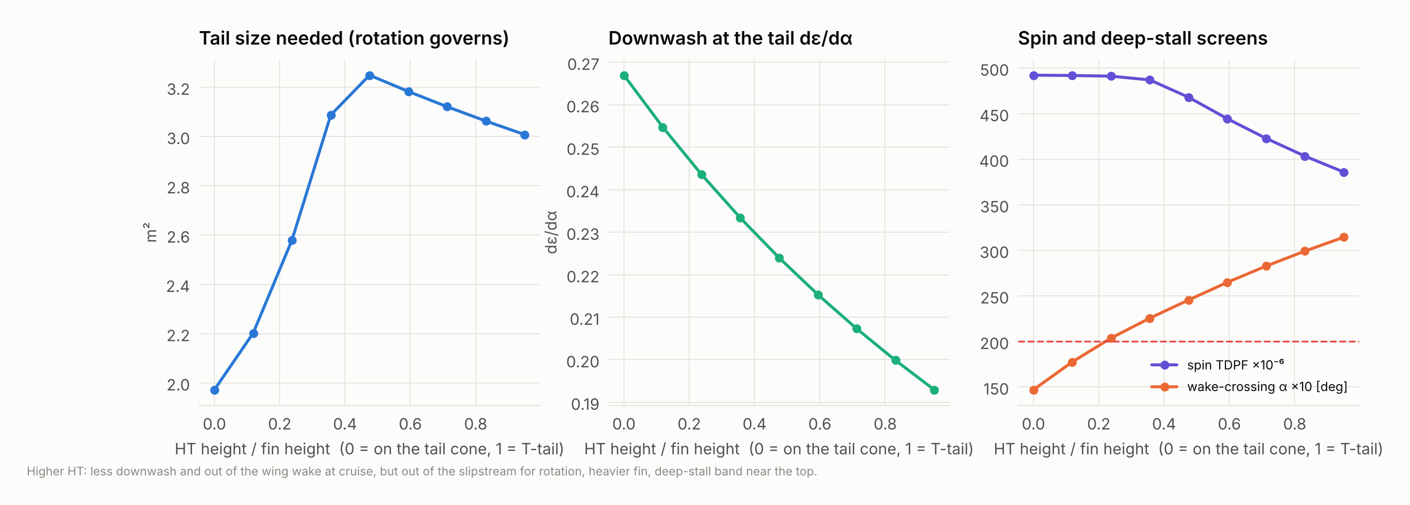
results/09_tail/ht_height_sweep.png
