hima0407/Project-Eidolon/results/10_stability/cg_envelope.png

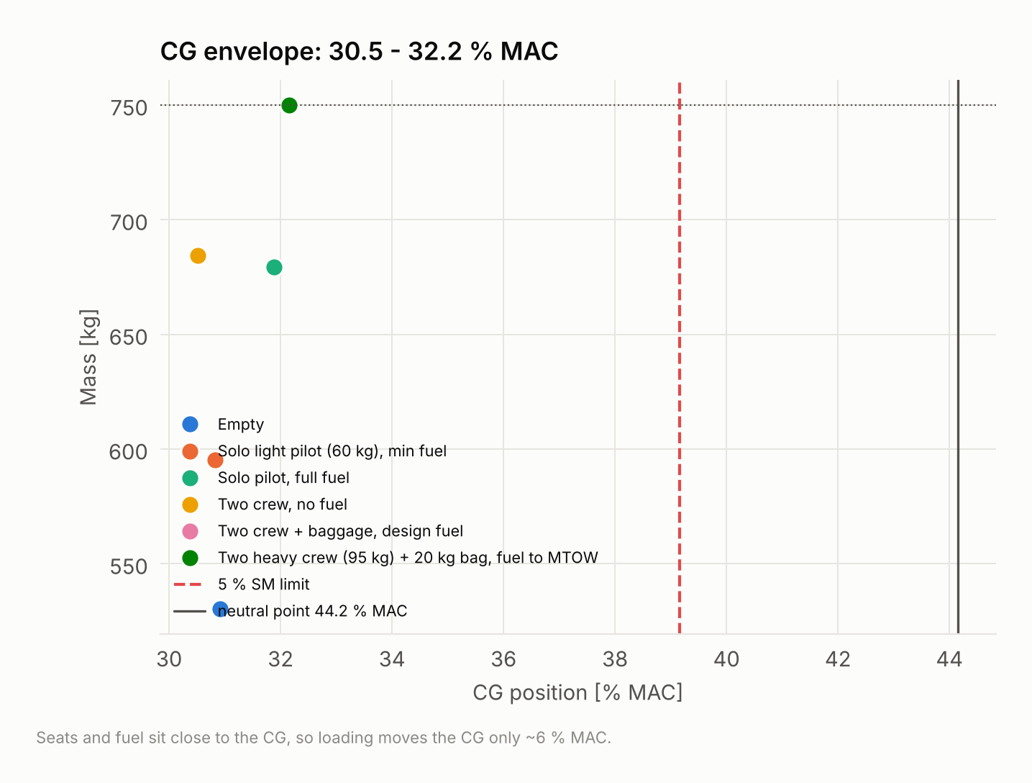
results/10_stability/cg_envelope.png
