hima0407/Project-Eidolon/results/10_stability/tail_sizing.png

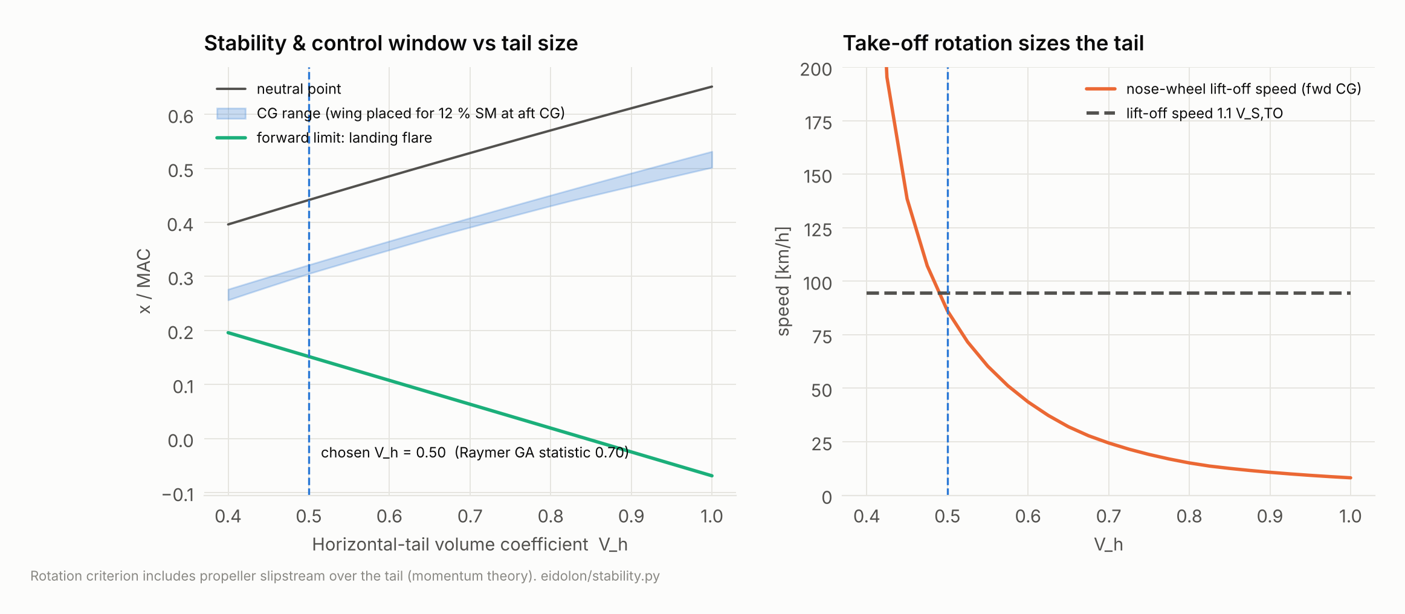
results/10_stability/tail_sizing.png
