hima0407/Project-Eidolon/results/11_performance/head_to_head.png

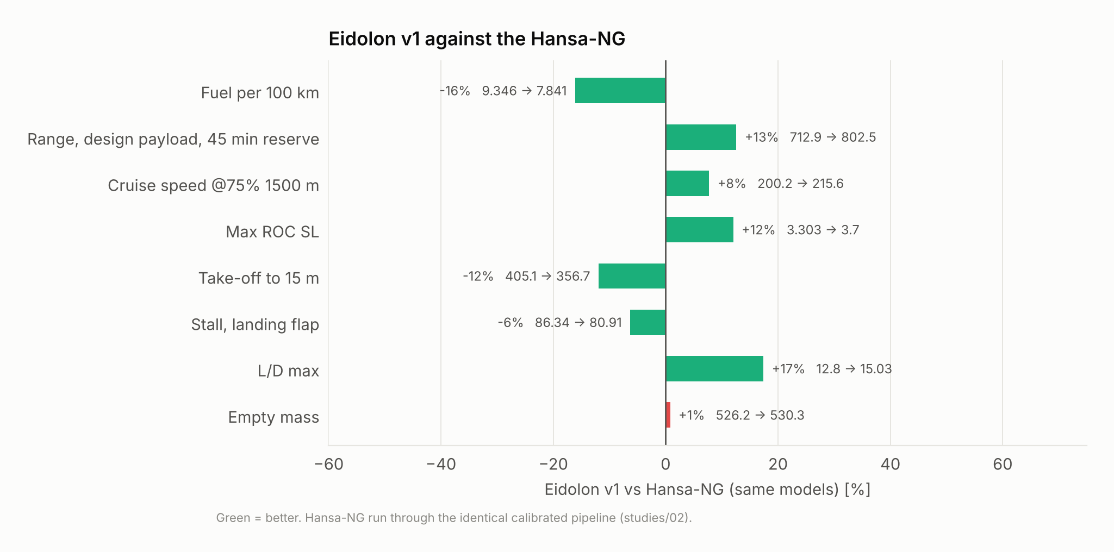
results/11_performance/head_to_head.png
