hima0407/Project-Eidolon/results/11_performance/payload_range.png

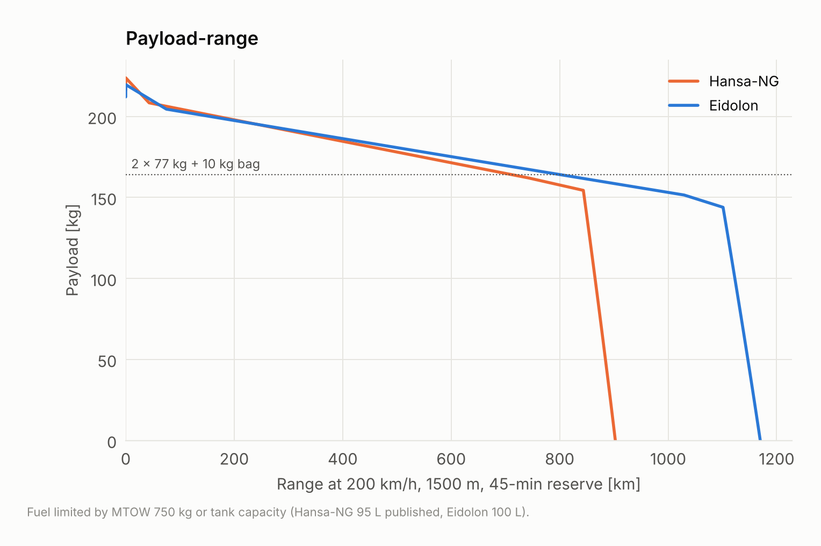
results/11_performance/payload_range.png
