hima0407/Project-Eidolon/results/13_landing_gear/piezo_energy.png

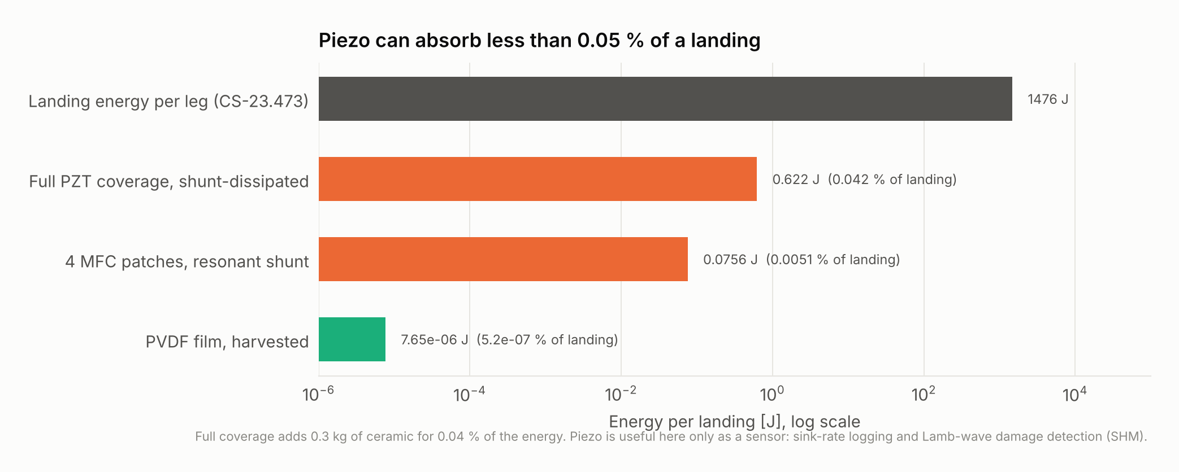
results/13_landing_gear/piezo_energy.png
