hima0407/Project-Eidolon/results/13_landing_gear/smart_gear.png

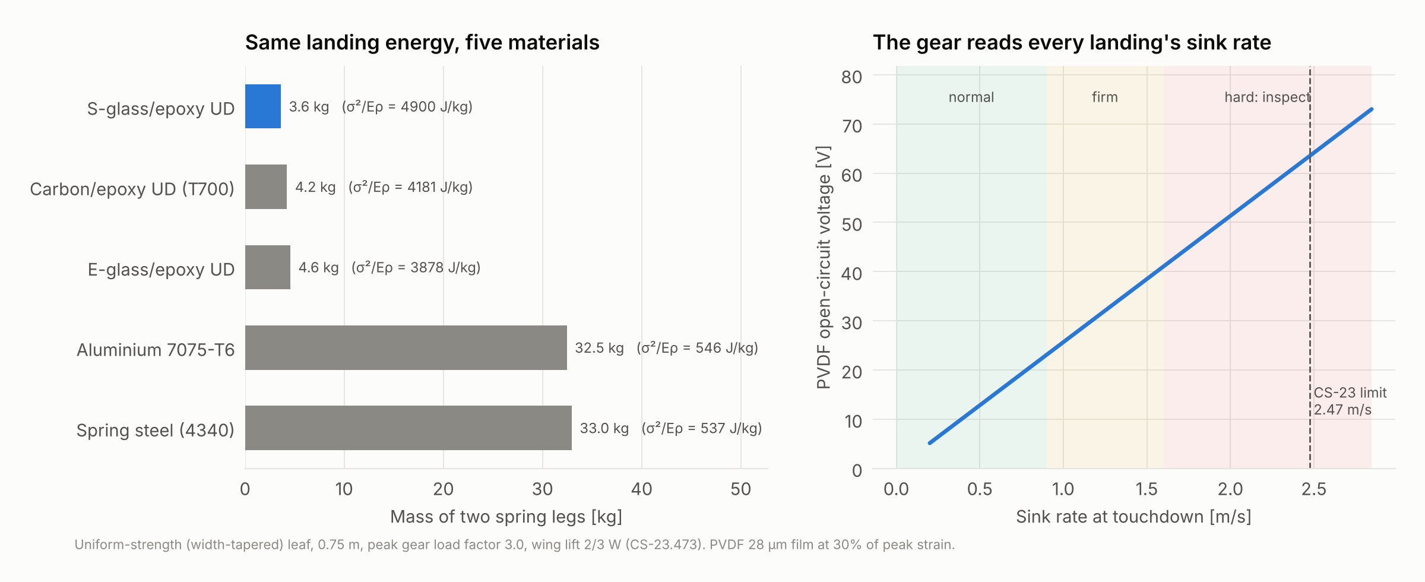
results/13_landing_gear/smart_gear.png
