hima0407/Project-Eidolon/results/14_sensitivity/tornado.png

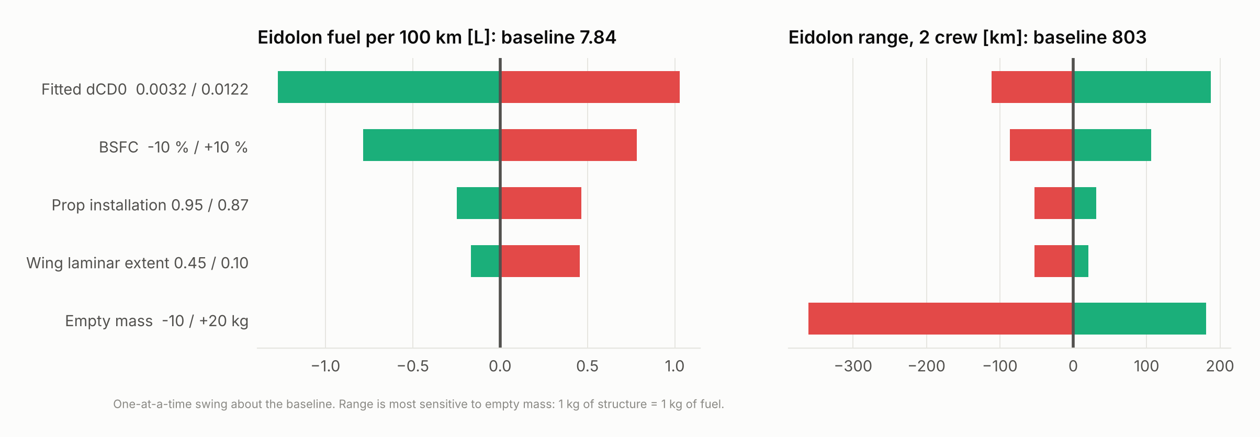
results/14_sensitivity/tornado.png
