hima0407/Project-Eidolon/results/15_hybrid/hybrid_boost.png

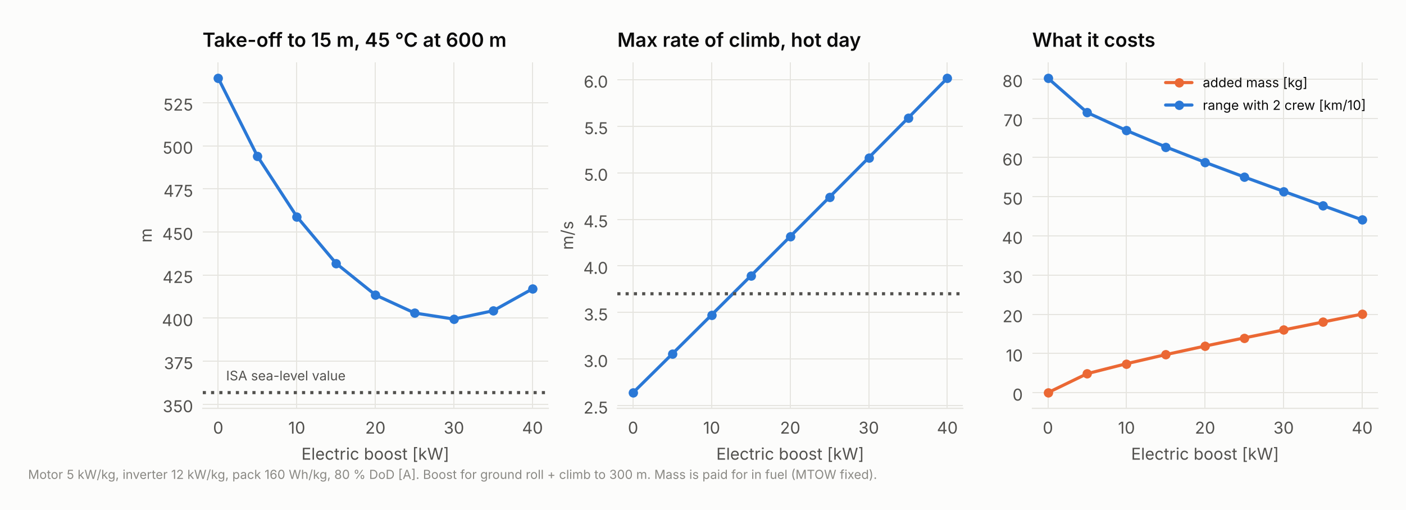
results/15_hybrid/hybrid_boost.png
