hima0407/Project-Eidolon/results/16_geometry/render_front.png

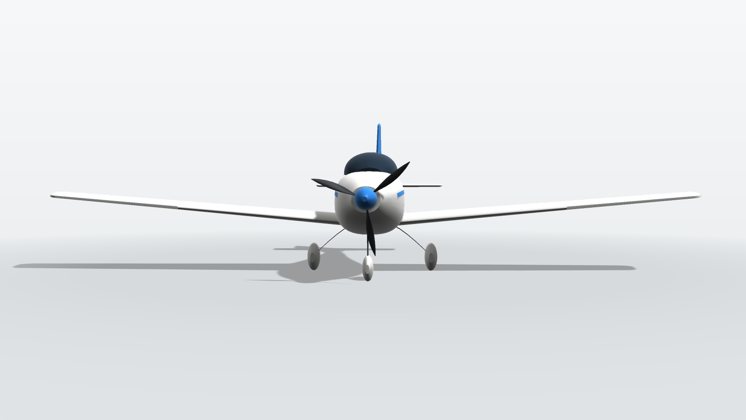
results/16_geometry/render_front.png
