hima0407/Project-Eidolon/results/17_structures/structure_mass.png

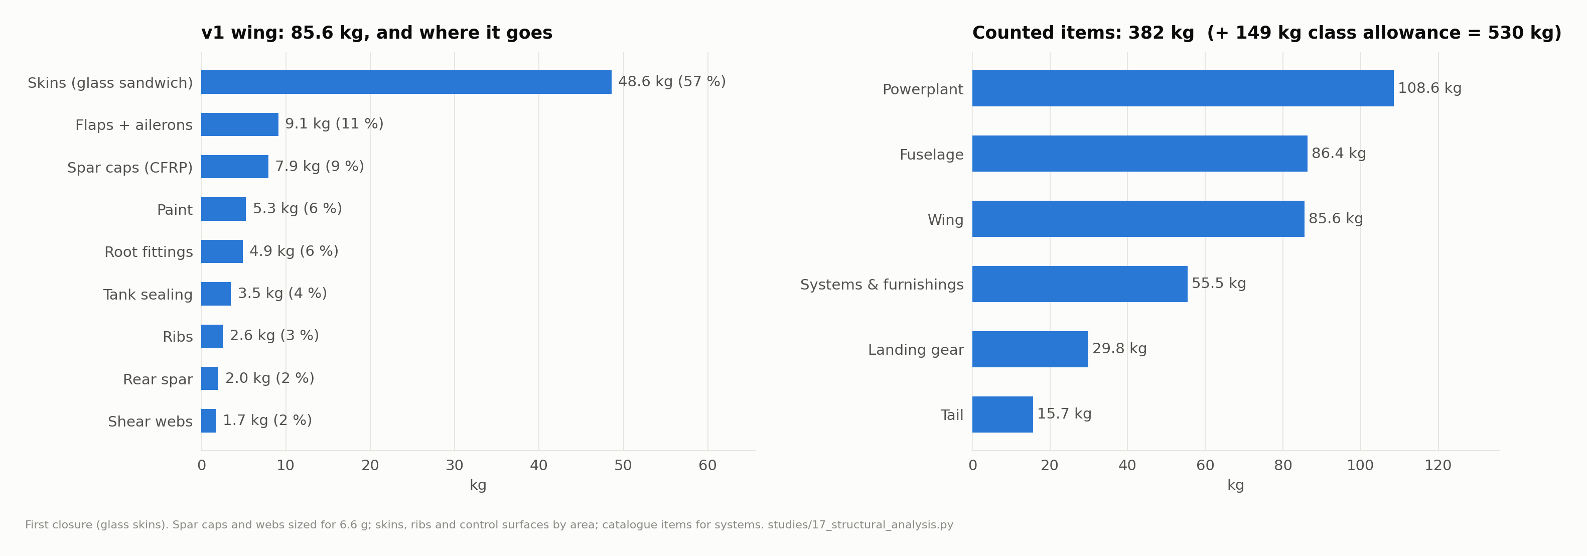
results/17_structures/structure_mass.png
