hima0407/Project-Eidolon/results/21_renders/crop_fin.png

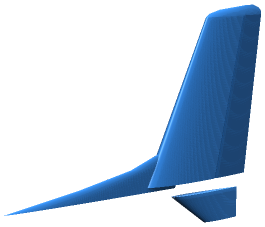
results/21_renders/crop_fin.png
