hima0407/Project-Eidolon/results/21_renders/crop_fuselage.png

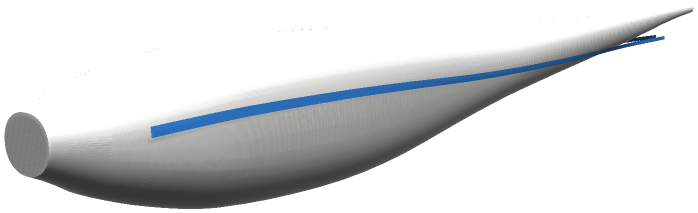
results/21_renders/crop_fuselage.png
