hima0407/Project-Eidolon/results/21_renders/crop_gear.png

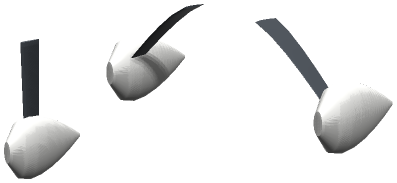
results/21_renders/crop_gear.png
