hima0407/Project-Eidolon/results/21_renders/crop_prop.png

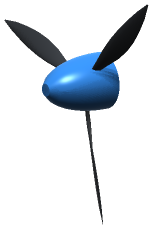
results/21_renders/crop_prop.png
