hima0407/Project-Eidolon/results/21_renders/crop_wing_far.png

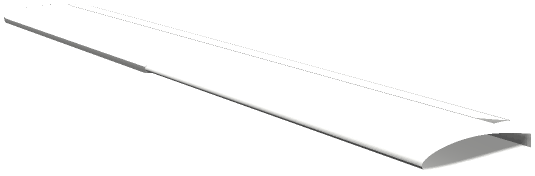
results/21_renders/crop_wing_far.png
