hima0407/Project-Eidolon/results/21_renders/part_fuselage.png

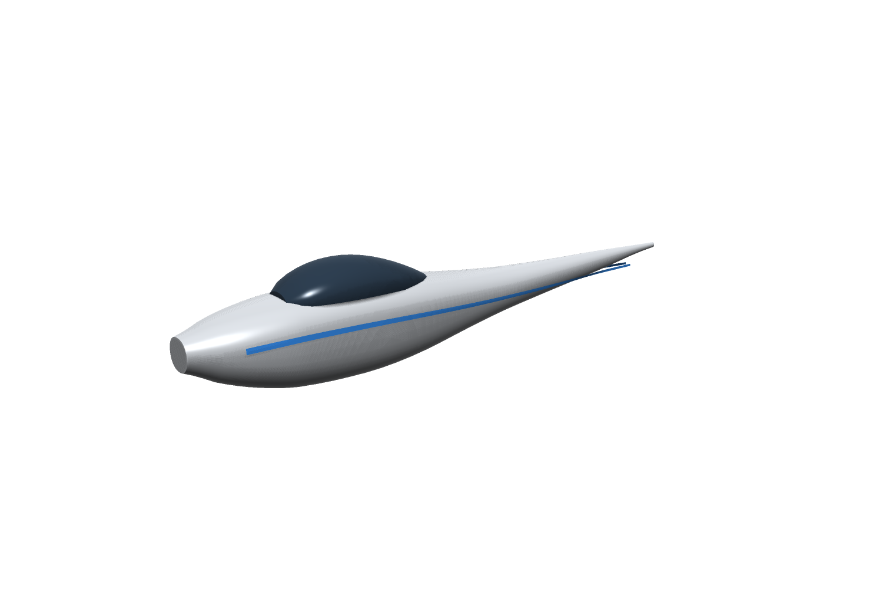
results/21_renders/part_fuselage.png
