hima0407/Project-Eidolon/results/21_renders/part_gear.png

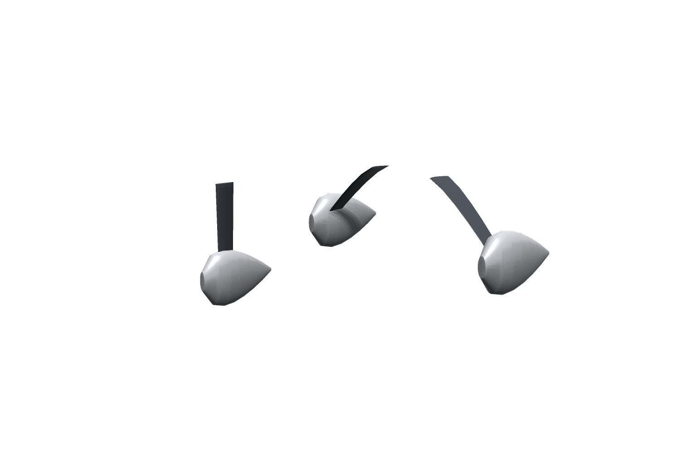
results/21_renders/part_gear.png
