hima0407/Project-Eidolon/results/21_renders/part_prop.png

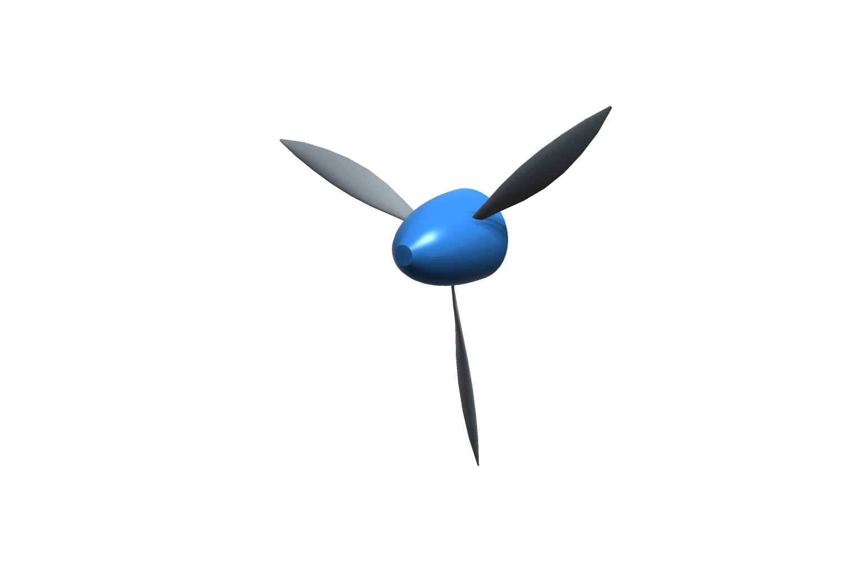
results/21_renders/part_prop.png
