hima0407/Project-Eidolon/results/21_renders/part_tail.png

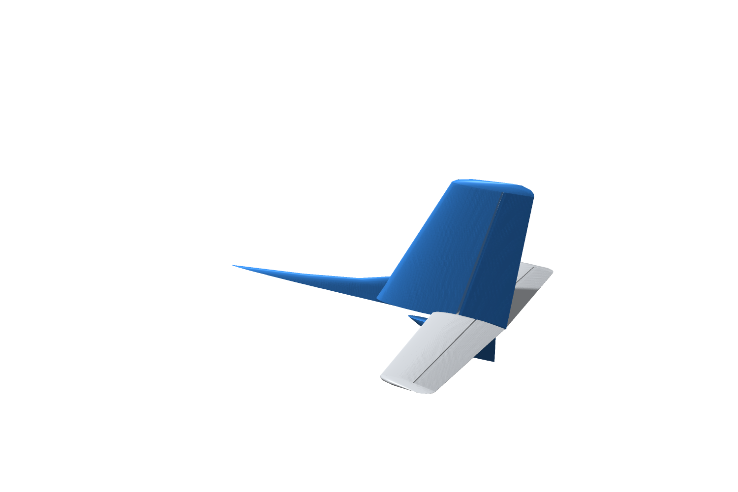
results/21_renders/part_tail.png
