hima0407/Project-Eidolon/results/21_renders/part_wing.png

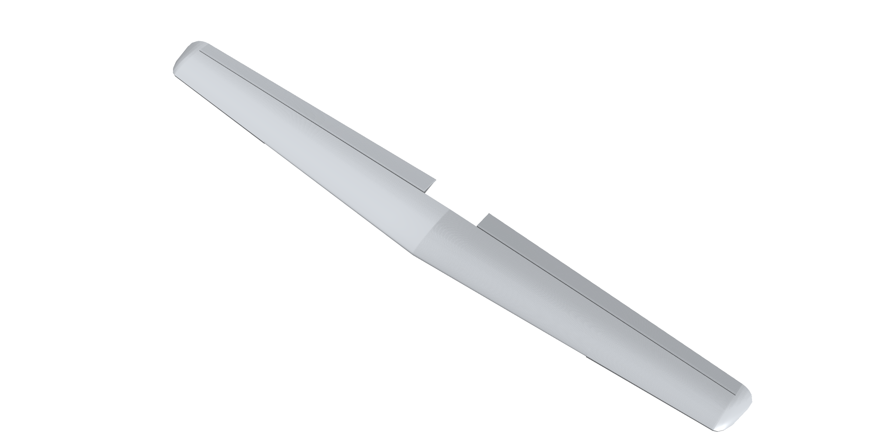
results/21_renders/part_wing.png
