hima0407/Project-Eidolon/results/23_engine_carbon/engine_trade_carbon.png

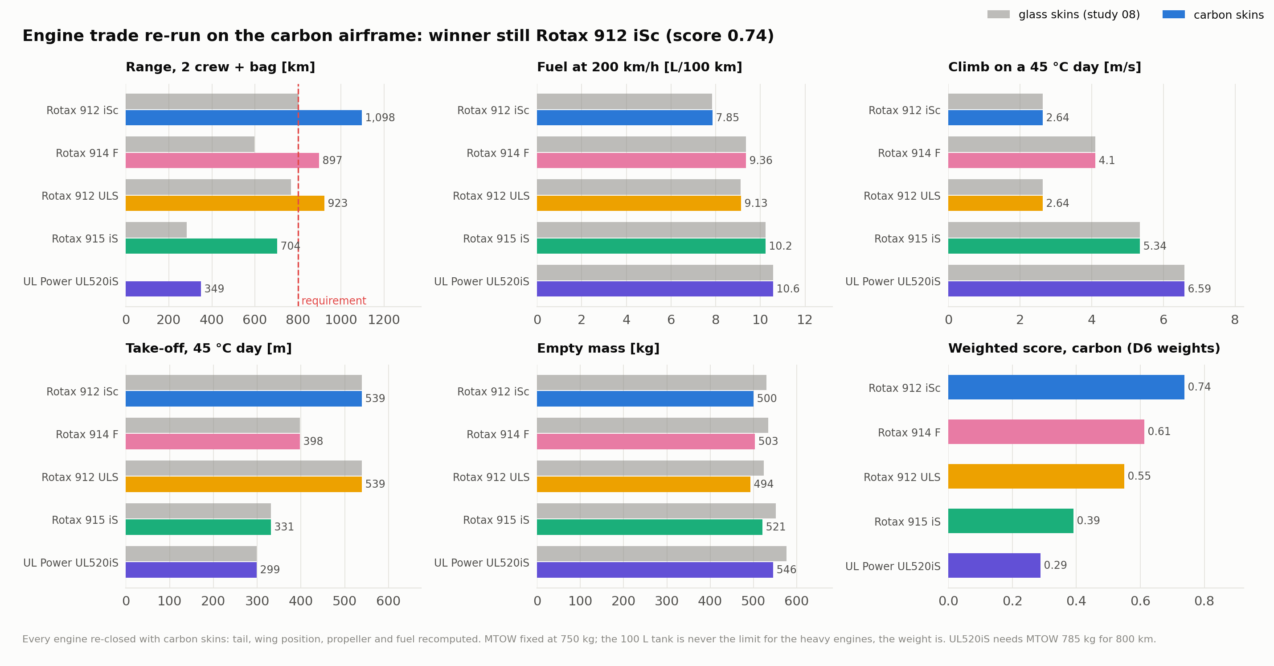
results/23_engine_carbon/engine_trade_carbon.png
