hima0407/Project-Eidolon/results/23_engine_carbon/hot_day_options.png

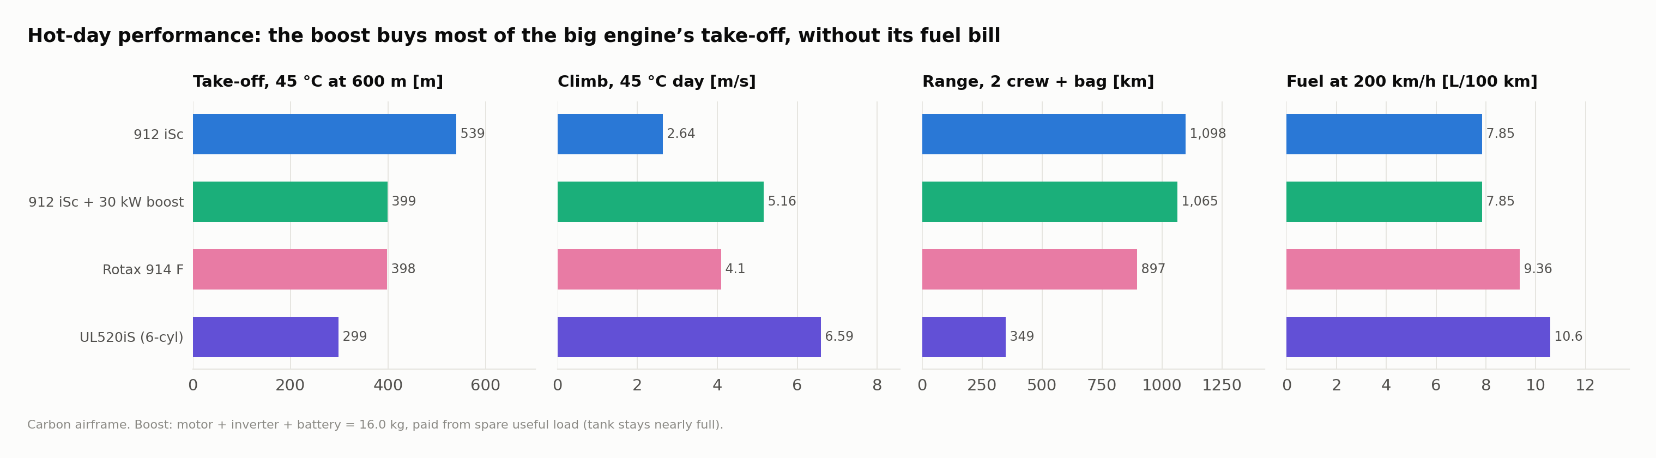
results/23_engine_carbon/hot_day_options.png
