hima0407/Project-Eidolon/results/constraints/constraint_analysis.png

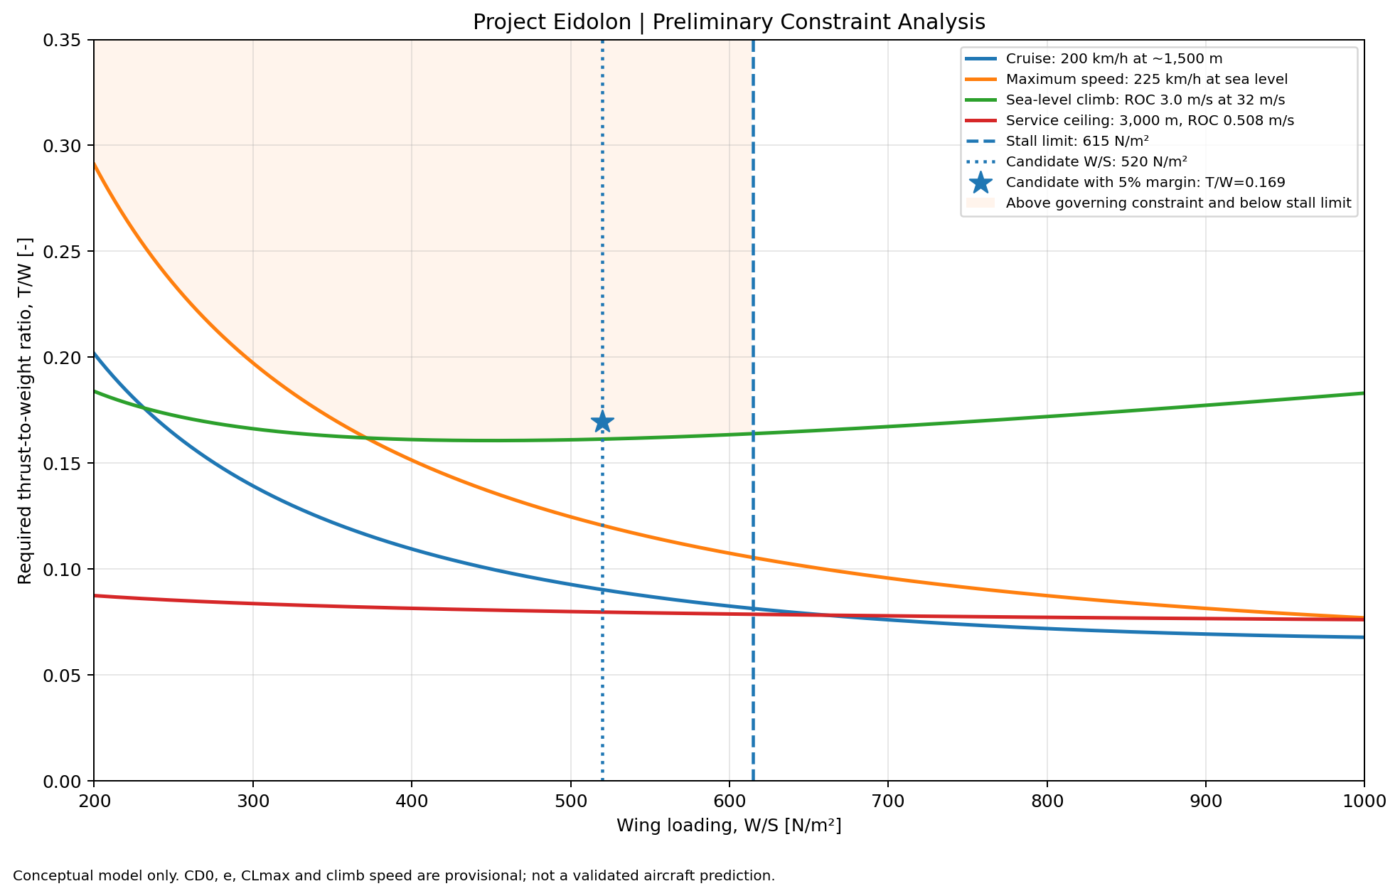
results/constraints/constraint_analysis.png
