hima0407/Project-Eidolon/results/landing_gear/landing_energy_screening.png

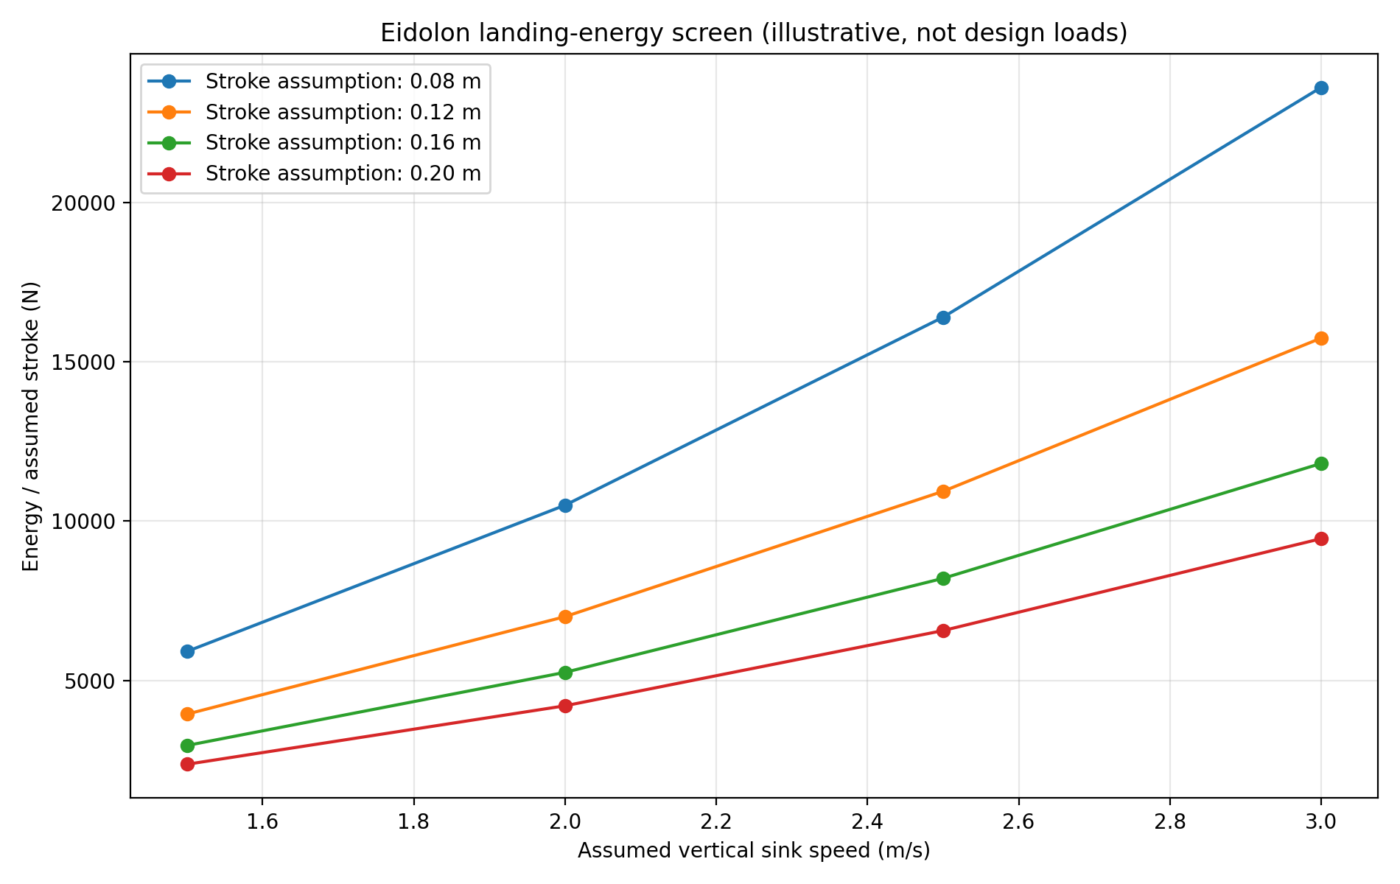
results/landing_gear/landing_energy_screening.png
