hima0407/Project-Eidolon/xflr5/results/naca63415/polar_graphs.png

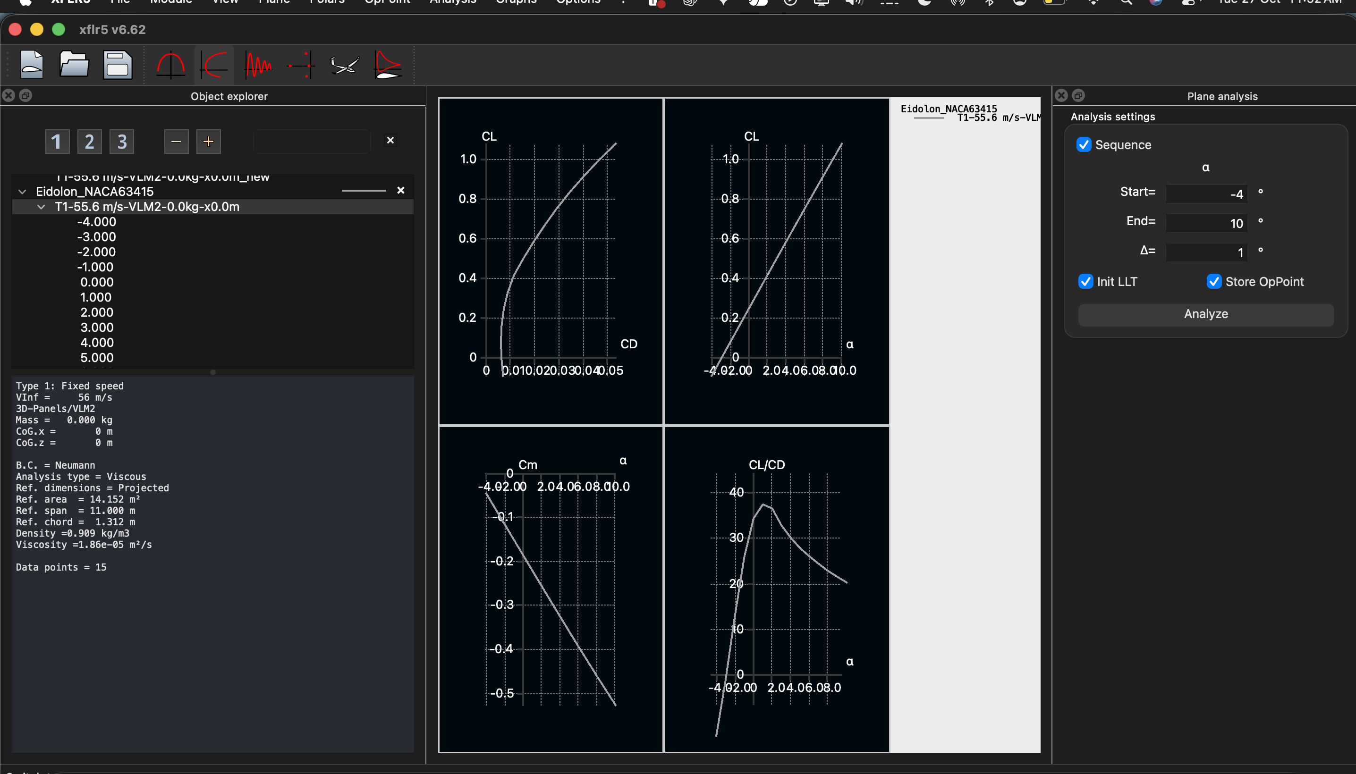
xflr5/results/naca63415/polar_graphs.png
