hima0407/Project-Eidolon/(commit log)

2026-10-26 propulsion: integrated analytical BEMT solver; calibrated MTV-21-A efficiency to 77.6% at cruise
2026-10-27 Add preliminary NACA 63-415 aerodynamic analysis
    [polar3d.csv]
2026-10-27 Synchronising preliminary aircraft design baseline
    [constraint_values.csv]
2026-10-28 aero: lock in baseline wing geometry with -2 deg washout and 63-412 tip blend
2026-10-29 Add piezoelectric landing gear feasibility study
    [landing_energy_screening.csv]
2026-11-05 cad: add initial 3D model - note: fuselage, empennage, engine box, and fuel tank are volumetric placeholders for sizing
    [something.f3d]
2026-11-05 cad: update intial 3d model with added pic for ref
    [initialtrail0.f3d]
2026-11-10 prop: BEMT propeller with momentum-theory bound
2026-11-10 gear: leaf spring sizing, piezo check, hybrid boost model
2026-11-10 studies: mass, calibration, airfoil, wing, wing sizing
2026-11-10 studies: drag, propeller, engine trade, tail, stability
2026-11-10 studies: performance, V-n, gear, monte carlo, hybrid
2026-11-10 results: regenerate figures and tables
    [calibration_vs_cruise_power_assumption.csv, carpet.csv, comparators.csv, configurations.csv, eidolon_mass_items.csv, elevator_sweep.csv, engine_trade.csv, hansa_validation.csv]
2026-11-10 cad: generated 3d model, fusion script, step export, renders
    [eidolon_v1_aileron.stl, eidolon_v1_canopy.stl, eidolon_v1_complete.stl, eidolon_v1_dorsal_fin.stl, eidolon_v1_elevator.stl, eidolon_v1_fin.stl, eidolon_v1_fin_tip.stl, eidolon_v1_flap.stl]
2026-11-10 docs: design decisions, methods and validation, cad notes
2026-11-10 cad: step export of v1 and v0, fusion screenshot
    [cad_eidolonv1.step, cadv0.step]
2026-11-10 repo: reorganise folders - xflr5 data, cad, archive of first iteration
    [cadv0.step, constraint_values.csv, eidolon_v1.step, initialtrail0.f3d, landing_energy_screening.csv, naca2412.dat.csv, polar3d.csv]
2026-11-11 study 17: structural analysis - wing loads, spar, stiffness, tail cone, margins
2026-11-11 study 18: unit-cost model calibrated on Hansa-NG's price
2026-11-11 study 19: fuselage length trade, 7.10 m confirmed
2026-11-11 study 21: part renders, exploded-view layers and assembly animation
2026-11-11 study 22: Monte Carlo and tail screen re-run on the carbon airframe
    [monte_carlo.csv]
2026-11-12 CAD: internal components as an Internals group; see-through Airframe
    [eidolon_v1_int_baggage.stl, eidolon_v1_int_battery.stl, eidolon_v1_int_carry_through.stl, eidolon_v1_int_cg_marker.stl, eidolon_v1_int_crew_head.stl, eidolon_v1_int_crew_torso.stl, eidolon_v1_int_engine.stl, eidolon_v1_int_firewall.stl]
2026-11-12 study 23: engine trade re-run on the carbon airframe; D14 keeps the 912 iSc, hot days via boost
    [engine_trade_carbon.csv]
